Eljah/qulay/electronics/README.md

# Электронная сборка QL-01

## Архитектура

Raspberry Pi 4 / Linux SBC выполняет Java-агент, хранение, связь и работу с флеш-памятью. Pico RP2040 подключён к нему по USB CDC и опрашивает измерительные датчики. Специальное мобильное приложение не требуется: телефон может предоставить Wi-Fi hotspot; опционально используется готовый сертифицированный USB LTE-модем. Разработка собственного GSM-тракта не входит в QL-01.

Редактируемые проекты KiCad создаются `build_checked.py`: плата углового датчика `encoder` 18×24 мм, плата сопряжения Pico `carrier` 80×100 мм. Схемы и платы создаются из одной таблицы выводов, поэтому в `connections.csv` есть явная проверяемая карта каждого контакта. `harness.csv` задаёт все 31 канала, цепочки 8+8+8+7. Изображение платы без электрических сетей не выдаётся за разработанную схему.

## Основные узлы и количества

| Узел | Количество | Примечание |
|---|---:|---|
| Raspberry Pi 4 / Linux SBC | 1 | Java 21, USB, Wi-Fi; отдельное питание |
| Raspberry Pi Pico RP2040 | 1 | Нативный USB; две SPI-шины |
| AS5048A, TSSOP14 | 31 | По одному на каждый шарнир |
| encoder PCB | 31 | AS5048A, 100 нФ, 10 мкФ, разъём |
| carrier PCB | 1 | Разъёмы Pico, датчиков, питания, одометра |
| Диаметрально намагниченный магнит | 31 | Геометрия и материал согласуются по испытанию |
| ADXL355, модуль с доступным SPI 3.3 В | 1 | Жгут согласно нашей распиновке; не обещается прямое совпадение с любым модулем |
| Квадратурный энкодер 3.3 В | 1 | Реальное колесо и масштаб калибруются; 12/24 В входы не поддержаны |
| Внешний стабилизатор датчиков 3.3 В | 1 | Ток не менее 1 А как проектный запас, с ограничением тока |
| Питание SBC 5 В | 1 | Проектный бюджет до 4 А с запасом и отдельной проверкой пиков USB |
| Готовая батарея с BMS/защитой | 1 | Не проект самостоятельной сборки литиевых ячеек |

31 AS5048A при типовом потреблении порядка 15 мА требуют около 465 мА, без запаса. Не подключать их все к 3V3 Pico. Carrier принимает отдельные 3.3 В через PTC; номинал PTC и температурное снижение допустимого тока должны быть проверены. Pico питается от USB, общая земля соединена. Отключённое питание датчиков при активных SPI-линиях может вызывать паразитное питание через входы: порядок включения, буфер/изоляция и защита линий подлежат проверке перед полевым прибором.

Оценочный рабочий бюджет всей электроники 12–20 Вт, не измеренный. Для батареи 60 Вт·ч и суммарного использования 80% это примерно 2.4–4 часа; холод и LTE могут ухудшить результат. Номинал батареи выбирается после замера фактического потребления и пиков.

## Монтаж и первичное включение

Сначала USB-Pico без датчиков: загрузить UF2, проверить CDC и период строк. Затем один AS5048A от ограниченного источника 3.3 В; проверить распиновку, паритет, OCF и диагностику магнита при полном диапазоне поворота. Затем три соседних канала и влияние магнитов. Только после этого — все цепочки и нагрузочное питание. Физическое движение одного рычага должно менять именно его индекс в журнале, иначе порядок SPI-цепочки не подтверждён.

AS5048A SPI mode 1, ADXL355 SPI mode 0: они намеренно на разных контроллерах. Жгуты сигнала и земли прокладывать совместно, питание вести с достаточным сечением; окончательные длины, фронты, резисторы согласования, ESD и EMC подтверждаются на приборе. Наружный USB и разъёмы должны иметь механическую разгрузку и защиту от воды. Защита IP в QL-01 не заявляется.

## Что проверяет автоматическая сборка

KiCad 9, проверка сериализованных координат каждой площадки, экспорт DSN, реальная трассировка Freerouting, обратный импорт SES, DRC, ERC, экспорт схем в PDF и платы в SVG. Все сообщения сохраняются; они не скрываются исключениями. Наличие файлов Gerber, если они экспортированы, не является разрешением на производство: `manufacturing_release=false` остаётся до независимой проверки питания, контактов, схемы, EMC и магнитной калибровки.

Скрипт `build.py` — генератор логической модели; запускать именно `build_checked.py`, который нормализует координаты площадок через API KiCad 9 и повторно читает сохранённую плату. Это исправляет выявленную несовместимость KiCad 7. Системный Python должен содержать pcbnew. Пересборка: `python3 electronics/build_checked.py`, трассировка DSN в SES, `python3 electronics/verify.py`.

## Нереализованные аппаратные функции

Нет валидированного датчика контакта/усилия каждого ролика. Нет интерфейса внешнего геодезического Z, температурной компенсации, защищённого полевого питания и сертифицированного корпуса. Q1 сохраняет реальные углы/ускорение/пробег, но не имеет права утверждать, что все ролики касались покрытия. Эти ограничения отражены в данных, а не спрятаны в документации.

Первичные источники: [AS5048A](https://www.infineon.com/assets/row/public/documents/24/49/infineon-as5048a-as5048b-datasheet-en.pdf), [ADXL355](https://www.analog.com/media/en/technical-documentation/data-sheets/adxl354_adxl355.pdf), [Pico SDK](https://www.raspberrypi.com/documentation/pico-sdk/hardware.html), [KiCad Ubuntu](https://www.kicad.org/download/details/ubuntu/). Отчёты в `generated/` относятся к точной сохранённой ревизии плат.
