Eljah/qulay/electronics/generated/harness.csv

channel | bank | sensor_pin | signal | connect_to
0 | 0 | 1 | 3V3 | carrier.J2.1
0 | 0 | 2 | GND | carrier.J2.2
0 | 0 | 3 | CS | carrier.J2.3
0 | 0 | 4 | SCK | carrier.J2.4
0 | 0 | 5 | DIN | carrier.J2.5
0 | 0 | 6 | DOUT | encoder01.J1.5
1 | 0 | 1 | 3V3 | carrier.J2.1
1 | 0 | 2 | GND | carrier.J2.2
1 | 0 | 3 | CS | carrier.J2.3
1 | 0 | 4 | SCK | carrier.J2.4
1 | 0 | 5 | DIN | encoder00.J1.6
1 | 0 | 6 | DOUT | encoder02.J1.5
2 | 0 | 1 | 3V3 | carrier.J2.1
2 | 0 | 2 | GND | carrier.J2.2
2 | 0 | 3 | CS | carrier.J2.3
2 | 0 | 4 | SCK | carrier.J2.4
2 | 0 | 5 | DIN | encoder01.J1.6
2 | 0 | 6 | DOUT | encoder03.J1.5
3 | 0 | 1 | 3V3 | carrier.J2.1
3 | 0 | 2 | GND | carrier.J2.2
3 | 0 | 3 | CS | carrier.J2.3
3 | 0 | 4 | SCK | carrier.J2.4
3 | 0 | 5 | DIN | encoder02.J1.6
3 | 0 | 6 | DOUT | encoder04.J1.5
4 | 0 | 1 | 3V3 | carrier.J2.1
4 | 0 | 2 | GND | carrier.J2.2
4 | 0 | 3 | CS | carrier.J2.3
4 | 0 | 4 | SCK | carrier.J2.4
4 | 0 | 5 | DIN | encoder03.J1.6
4 | 0 | 6 | DOUT | encoder05.J1.5
5 | 0 | 1 | 3V3 | carrier.J2.1
5 | 0 | 2 | GND | carrier.J2.2
5 | 0 | 3 | CS | carrier.J2.3
5 | 0 | 4 | SCK | carrier.J2.4
5 | 0 | 5 | DIN | encoder04.J1.6
5 | 0 | 6 | DOUT | encoder06.J1.5
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
