Eljah/qulay/docs/METROLOGY.md

# QL-01: наблюдаемость, неопределённость и проект методики

Статус: проект инженерного исследования, не утверждённая методика измерений и не действующий ГОСТ.

## 1. Определяемые величины

Высотный профиль поверхности в заданной системе координат; продольный и поперечный уклоны на явно заданной базе; обнаруженные перепады уровней; зоны потери контакта; пространственная полнота обследования. Геометрия не доказывает сцепление, прочность, водоотвод, безопасное пересечение проезжей части или удобство для всех типов кресел.

Отчёт должен различать: измерено, вычислено, интерполировано, ненаблюдаемо. Интерполяция через вертикальную грань или неизвестный контакт запрещена. Отсутствие измеренной ступеньки не доказывает её отсутствие.

## 2. Геометрическая проблема, которую не исправит программный фильтр

Измерительный угол задаёт положение центра ролика относительно рамы. На двух поверхностях разной высоты рама может подняться вместе с роликами, сохраняя углы и наклон; поэтому без независимого Z продольная поверхность не определяется однозначно. Интегрирование ускорений или GNSS не принято здесь за миллиметровую базу.

DATUM_RAIL требует измерить форму и прогиб направляющих под нагрузкой, биение и деформацию опорных колёс, точное положение кассеты. EXTERNAL_POSE требует временной привязки и прослеживаемости внешней системы. FREE_ROLL допускает разведку и одновременные относительные поперечные величины с оговорками.

### Вдоль бордюра: ещё одна существенная поправка

При L=240 мм, оси на высоте 220 мм и ролике R20 на нижнем уровне центр находится примерно в X=132.7 мм от шарнира. На верхнем уровне +150 мм — примерно X=234.7 мм. Значит, две сравниваемые точки расположены не только на разных Y, но и примерно на 102 мм в разных X. На ровных вдоль бордюра площадках это допустимая модель, но при продольном изменении высот возникает смещение результата. Нельзя называть каждую строку массива строгим поперечным сечением без пересчёта координат.

`CurbAnalysis` сравнивает медианы наружных окон каналов 0..9 и 21..30 при разбросе высоты в каждом окне не более 4 мм. Этот допуск — демонстрационное условие алгоритма, не норматив. Сохраняется разность X контактов; центральная грань остаётся ненаблюдаемой. Серверный `/curb-profile` показывает профиль разности уровней и ограничения, не положительное заключение о соответствии. Для наклонных/волнистых площадок нужны сопоставление по мировой X с datum либо отдельная оценка возможной ошибки от продольного градиента.

## 3. Предварительная оценка чувствительности, не паспортная точность

На горизонтальной раме `dz/dα = L cos α`. Один отсчёт 14-битного датчика равен 2π/16384 ≈ 0.0003835 рад. При α=-56.44° и L=240 мм это около 0.051 мм на отсчёт; при α≈0 — около 0.092 мм. Это дискретность, НЕ погрешность. Нелинейность датчика, магнит, люфт и упругость могут давать значительно больший вклад.

При остаточной ошибке угла 0.05° и чувствительности 133 мм/рад вклад по высоте около 0.116 мм. Но значение 0.05° не достигнуто и не подтверждено: это лишь пример для выбора требований к калибровочному стенду.

Остаточная ошибка крена 0.05° даёт примерно 0.655 мм разности на ширине 750 мм. Неправильно установленный инклинометр способен имитировать нарушение поперечного уклона. Ускорение движения также влияет на акселерометрический наклон.

Пример бюджета стандартной неопределённости одной координаты (только гипотетические входные данные): угол 0.12 мм; длина/ось 0.15; радиус/биение 0.15; люфт/пружина 0.20; ориентация 0.20; datum 0.30; временная несогласованность 0.15. При независимости сумма квадратов даёт u≈0.50 мм, U(k=2)≈1.0 мм. Эти величины НЕ заявляются для устройства. Корреляции, температурные эффекты и модель контакта могут изменить результат.

Для уклона `(z2-z1)/B` важна ковариация двух высот; нельзя механически складывать две полные независимые ошибки, если общая ошибка datum сокращается, или наоборот игнорировать изгиб направляющей. Базу B, фильтрацию и правило обнаружения перегиба фиксируют в версии методики.

## 4. Программа трёхканального стенда

Сначала изготовить и испытать 3 соседних канала с реальными магнитами и датчиками, а не сразу заказывать 31. Измерить нелинейность вверх/вниз, гистерезис, люфт, повторяемость, чувствительность к температуре и соседнему магниту. Проверить реальный радиус контакта и биение ролика, стабильность усилия пружины по всему диапазону.

Требуется отдельный датчик контакта/силы. По одному углу нельзя надёжно отличить касание от зависания рычага: Q1 помечает все реальные каналы CONTACT_UNKNOWN. До разработки, калибровки и испытания этого канала автоматическое принятие реальных измерений блокируется. Возможная следующая конструкция — упругий измерительный элемент между вилкой ролика и рычагом с тензодатчиком; это отдельная аппаратная ревизия, не существующая часть платы QL-01.

После успешного стенда: полная кассета; измерение её изгиба; платформа с поверенными мерами высоты 5/10/15/20/150 мм; наклонная плоскость; два прохода в противоположных направлениях; проход со смещением половины шага; испытания грязью, водой и боковым упором. Положительный результат симулятора не заменяет ни одного из этих испытаний.

## 5. Проект полевой процедуры

Зафиксировать объект, план, погоду/температуру, оператора, версии прошивки и ПО, серийные номера, калибровку и профиль требований. Снять общий вид, границы доступного коридора и состояние покрытия. Проверить ноль и меру высоты до прохода.

Выбрать и проверить высотную базу; разместить направляющие вне исследуемого покрытия и безопасно оградить место. Выполнить перекрывающиеся проходы всей ширины объекта; записать направления, геометрическую привязку и смещения. При упоре в бордюр остановиться, поднять кассету, выполнить отдельный проход вдоль бордюра или сверху. Не продавливать ролики через препятствие.

После прохода повторить контроль нуля/меры, отметить отрывы и повреждения. Сохранить исходные данные и хеш; подписывать протокол отдельным механизмом идентификации оператора, поскольку SHA-256 сам по себе не является электронной подписью.

## 6. Правило решения

Для верхнего предела T при измеренном m и расширенной неопределённости U: соответствие, только если m+U≤T; несоответствие, если m−U>T; иначе пограничный/неопределённый результат. Неполнота покрытия, отсутствие datum, неизвестный контакт, неподтверждённая калибровка или неприменимый норматив дают самостоятельную причину невозможности заключения.

## 7. Путь к стандарту

Сначала определить область применения и измеряемые величины; затем ТУ на средство, методику калибровки/поверки, методику измерений, межоператорную и межлабораторную воспроизводимость, правила решения и формат протокола. Обсудить применимость 102-ФЗ и статус средства измерений с компетентной метрологической организацией. Только после экспериментальной базы готовить предложение по стандартизации с профильным техническим комитетом.

СП 59.13330.2020 и дорожные документы не объединяются в один универсальный порог. Для каждой проверки нужны применимая официальная редакция, пункт и условия объекта. В QL-01 такой юридико-технический реестр ещё не подтверждён; `DEMO-ONLY-01` намеренно не нормативный.

Источники принципов и спецификаций: ссылки в [CONCEPT.md](CONCEPT.md), [firmware/README.md](../firmware/README.md). Численные примеры выше — расчёты проектировщика, а не результаты испытаний.
