Eljah/qulay/mechanical/generated-r1/QL01-R1-review.pdf

# QULAY / Обновлённая компоновка

Ревизия B / 31 канал с шагом 25 мм. Исходная ревизия сохранена в mechanical/generated.

QL-01.R1 · Компоновочный CAD. НЕ разрешение на изготовление и НЕ подтверждение точности.
Номинальные размеры, мм. Пружины, замки высоты, уплотнения и соединение рычага с валом требуют деталировки.

# QULAY / Два соседних шарнира — крупно

Перенесены подшипники и платы. Магнит установлен на торце, а не внутри объёма вала.

# QULAY / Шарнир: осевой разрез

Разрез CAD по Z оси. Зелёный — плата; чёрный — корпус датчика; красный — магнит; жёлтый — габарит пружины.

# QULAY / Режим вдоль бордюра

Два уровня 0/150 мм. Необходимо отдельно ограничивать ошибку от смещения контактов по X.

# QULAY / Режим на независимых направляющих

Только компоновка: прямолинейность и прогиб направляющих под нагрузкой ещё не измерены.
