Eljah/qulay/mechanical/generated/QL01-CAD-album.pdf

# QULAY / Общий вид QL-01

31 канал; шаг 25 мм; база крайних осей 750 мм; рычаг 240 мм.

QL-01 • Компоновочный CAD. НЕ рабочая документация для изготовления. Размеры — мм.

Изображения отрендерены из тех же B-rep тел, которые экспортированы в STEP. Упрощения указаны в реестре деталей. | 1/7

# QULAY / Вид сверху

Габарит рамы 840 × 800 мм. Колея опор 825 мм; наружный габарит колёс 860 мм.

Изображения отрендерены из тех же B-rep тел, которые экспортированы в STEP. Упрощения указаны в реестре деталей. | 2/7

# QULAY / Боковая проекция X–Z

Высота оси измерительного рычага 220 мм; опорные колёса Ø200; ролики Ø40.

Изображения отрендерены из тех же B-rep тел, которые экспортированы в STEP. Упрощения указаны в реестре деталей. | 3/7

# QULAY / Фронтальная проекция Y–Z

Полоса измерения не равна полной ширине съезда. Требуются привязанные перекрывающиеся проходы.

Изображения отрендерены из тех же B-rep тел, которые экспортированы в STEP. Упрощения указаны в реестре деталей. | 4/7

# QULAY / Проход вдоль бордюра

Слева/справа разные уровни 0/150 мм; рама поднята, кассета опущена на 150 мм.

Изображения отрендерены из тех же B-rep тел, которые экспортированы в STEP. Упрощения указаны в реестре деталей. | 5/7

# QULAY / Независимая высотная база: направляющие

Направляющие 3000 × 60 × 80 × 4 мм, 5 опор на каждую. Поверенная геометрия ещё не подтверждена.

Изображения отрендерены из тех же B-rep тел, которые экспортированы в STEP. Упрощения указаны в реестре деталей. | 6/7

# Измерительная кассета — исходные размеры и ограничения

Рычаг: расстояние осей 240 мм; ширина 20 мм; сталь 3 мм; отверстия Ø8.1 мм.

Ролик: сферическая корона R20, ширина 12 мм, отверстие Ø16 мм под два подшипника 688.

31 независимый канал с шагом 25 мм; шарниры, магниты, платы и пружины показаны отдельными телами.

Приведён DXF 1:1 контура рычага и STEP заготовки; перед заказом согласовать посадки и технологию.

Пружина и крепёжные кронштейны показаны габаритно. Рабочие чертежи пружин, стопоров,

грязезащиты и замков высоты требуют проверки на трёхканальном стенде.

Не утверждается отсутствие взаимных пересечений всех сборочных деталей: выполнена проверка валидности

отдельных B-rep тел. Полная проверка зазоров, нагрузок и прогибов должна предшествовать производству.

Калибровка включает: угловую LUT каждого канала, положение магнита, длину рычага, радиус и биение

ролика, ориентацию инклинометра, масштаб одометра и высотную базу под нагрузкой.

Целевая погрешность не является достигнутой характеристикой. Реальные датчики ещё не испытаны.

Реестры резки и деталей выгружены в CSV отдельно для каждого положения сборки.
