Eljah/qulay/mechanical/coupling_c1/generated/C1-drawings.pdf

# QULAY / C1-00 Сборка и осевая размерная цепь

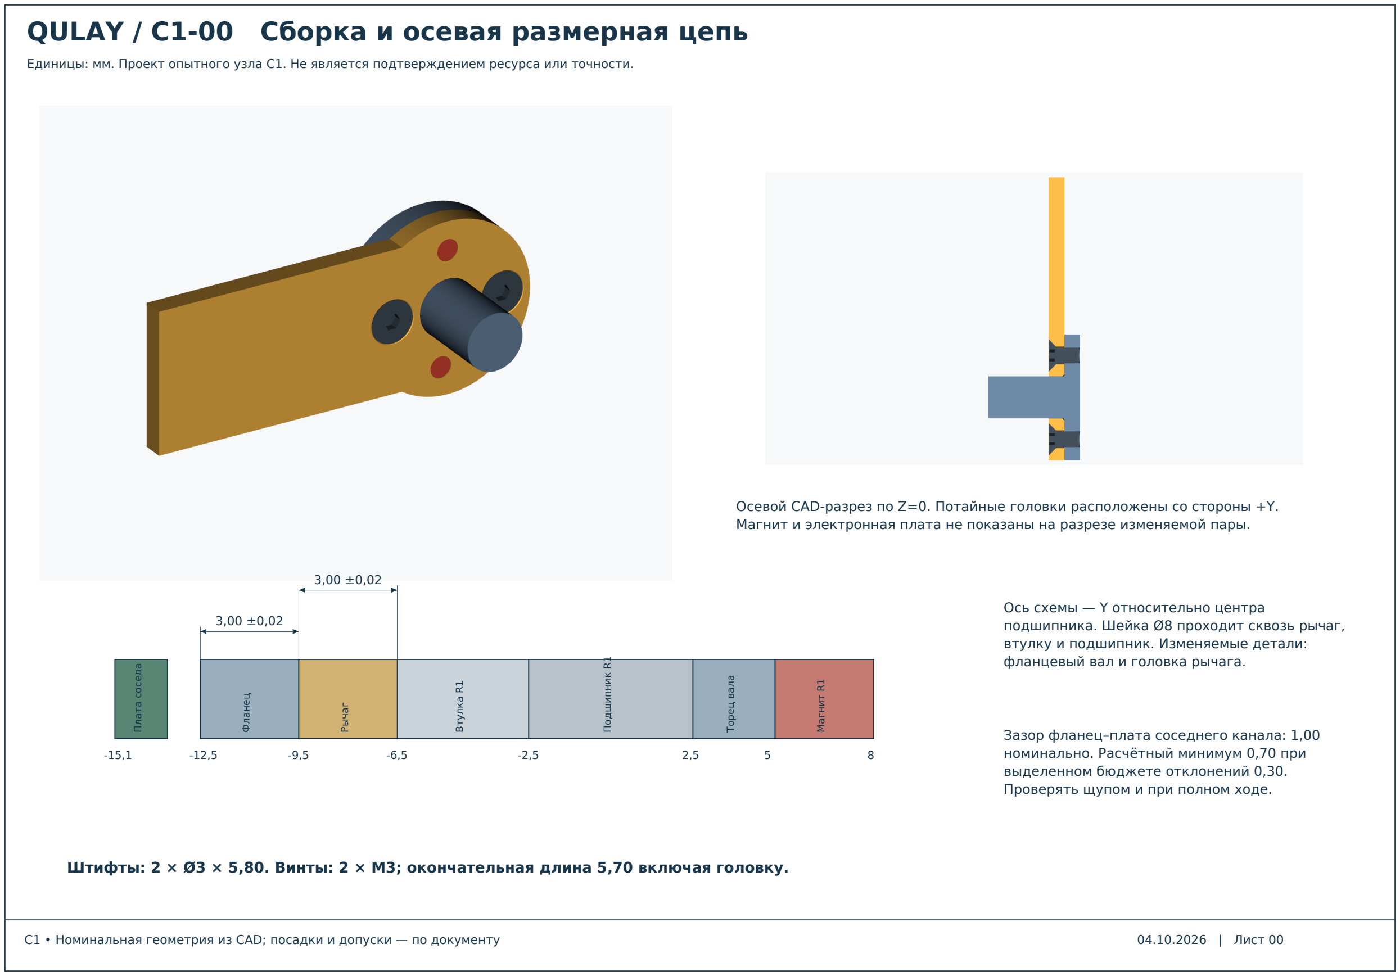
[picture p3: page 1]

Единицы: мм. Проект опытного узла C1. Не является подтверждением ресурса или точности.

C1 • Номинальная геометрия из CAD; посадки и допуски — по документу | 04.10.2026 | Лист 00

Осевой CAD-разрез по Z=0. Потайные головки расположены со стороны +Y. Магнит и электронная плата не показаны на разрезе изменяемой пары.

Плата соседа

-15,1

Фланец

-12,5

Рычаг

-9,5

Втулка R1

-6,5

Подшипник R1

-2,5

Торец вала

2,5

Магнит R1

5 | 8

3,00 ±0,02

3,00 ±0,02

Ось схемы — Y относительно центра подшипника. Шейка Ø8 проходит сквозь рычаг, втулку и подшипник. Изменяемые детали: фланцевый вал и головка рычага.

Зазор фланец–плата соседнего канала: 1,00 номинально. Расчётный минимум 0,70 при выделенном бюджете отклонений 0,30. Проверять щупом и при полном ходе.

Штифты: 2 × Ø3 × 5,80. Винты: 2 × M3; окончательная длина 5,70 включая головку.

# QULAY / C1-01 Цельный фланцевый вал

Единицы: мм. Проект опытного узла C1. Не является подтверждением ресурса или точности.

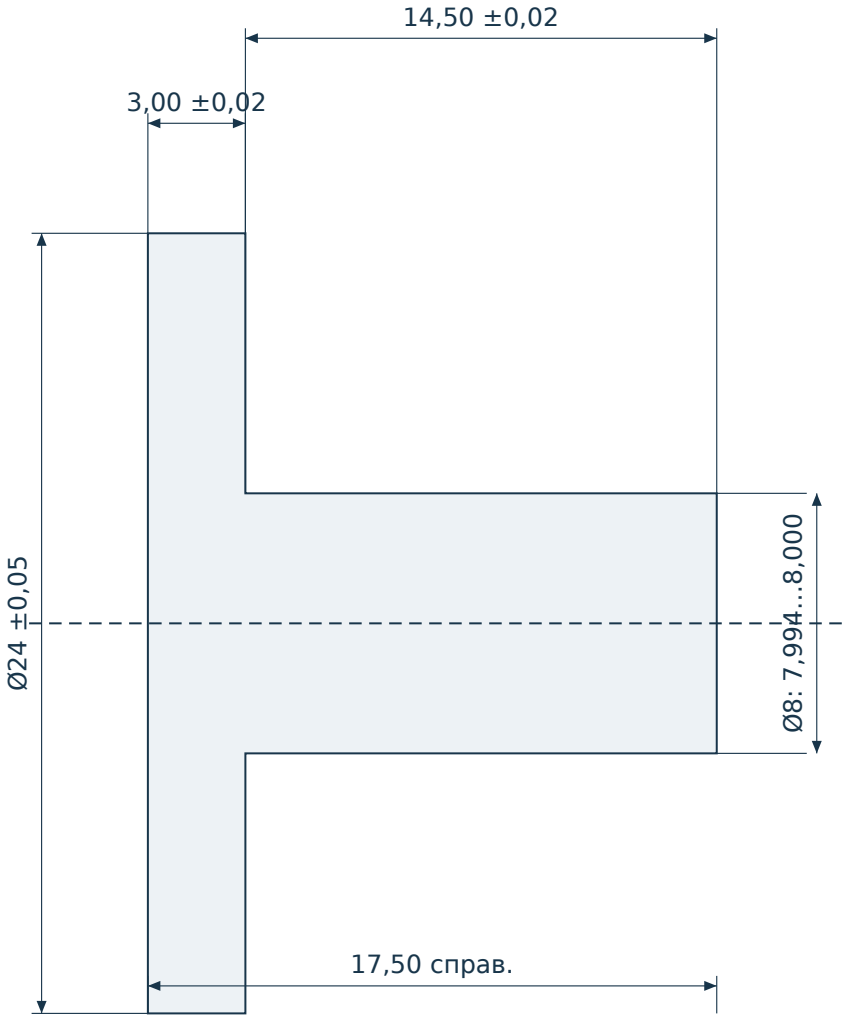
[picture p4: figure]
17,50 справ.
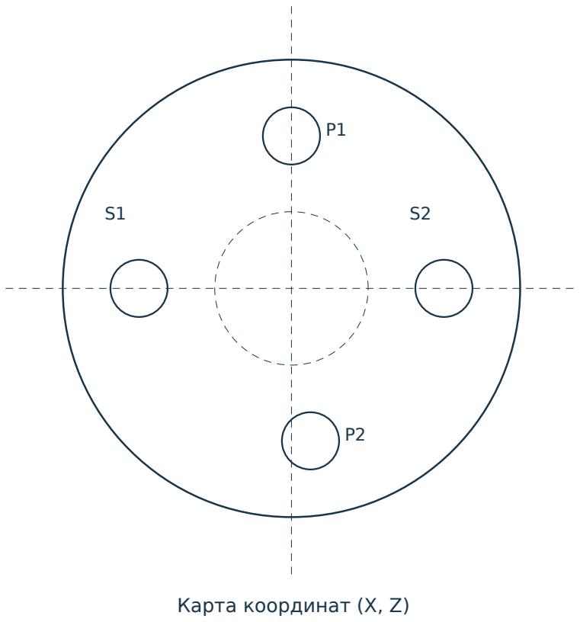
[picture p5: figure]
Карта координат (X, Z)

C1 • Номинальная геометрия из CAD; посадки и допуски — по документу | 04.10.2026 | Лист 01

Продольный профиль Y–Z; галтель R0,20 у фланца.

Отверстие | X | Z | Обработка
P1 | 0 | +8 | Совместно под свой штифт
P2 | +1 | −8 | Совместно под свой штифт
S1 | −8 | 0 | M3×0,5-6H сквозное
S2 | +8 | 0 | M3×0,5-6H сквозное

Материал: C45 / сталь 45; сертификат Rp0,2 ≥300 МПа.

Вал и фланец — одна заготовка. Не приваривать шайбу.

Шейка: Ra ≤0,8 мкм. Торец фланца: плоскостность 0,02;

его биение относительно шейки ≤0,02. Задиры не допускаются.

# QULAY / C1-02 Рычаг и обработка головки

Единицы: мм. Проект опытного узла C1. Не является подтверждением ресурса или точности.

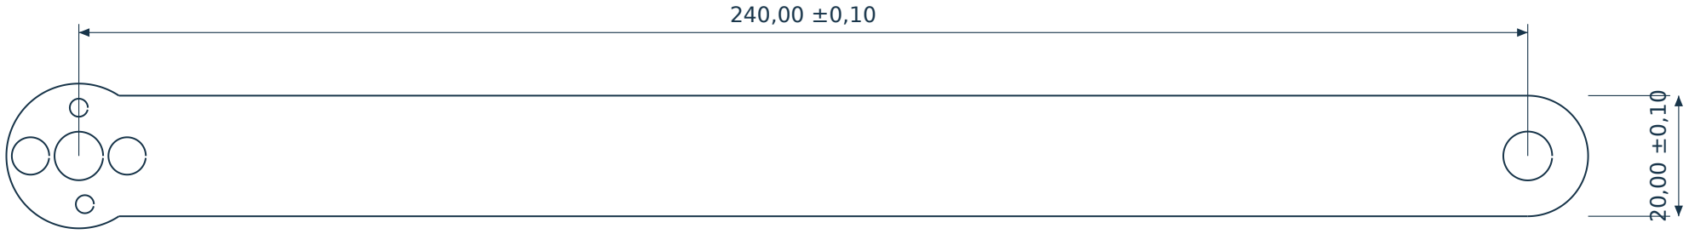
[picture p6: figure]
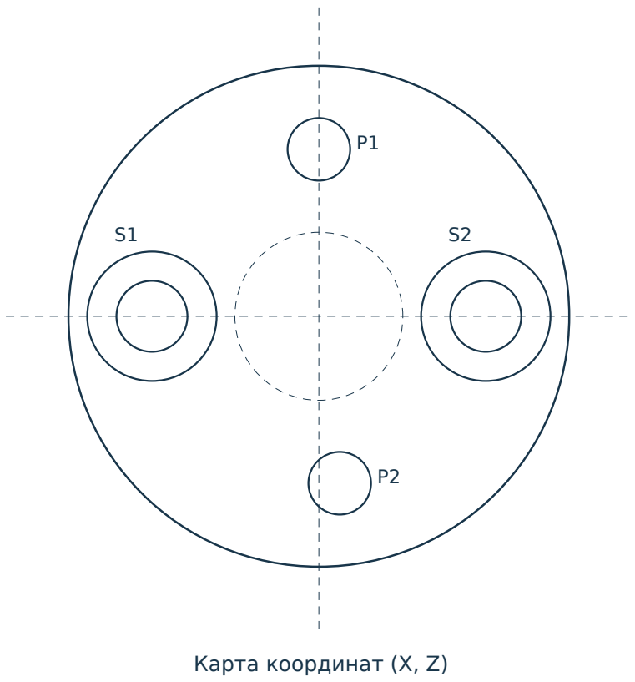
[picture p7: figure]
Карта координат (X, Z)

C1 • Номинальная геометрия из CAD; посадки и допуски — по документу | 04.10.2026 | Лист 02

Общий вид 1:1: линии получены с плоской грани CAD. Головка R12; роликовое отверстие Ø8,10.

Головка рычага: толщина 3,00 ±0,02; сталь Rp0,2 ≥300 МПа.

Центральное отверстие Ø8,05 ±0,01. Со стороны фланца

фаска 0,4×45° для галтели. Плоскостность торца ≤0,02.

S1 / S2: Ø3,4 сквозные; зенковка Ø6,2 +0,05/0, угол 90°.

Головка винта ≤Ø6,0; утапливание 0…0,10. Подрезанный

винт длиной 5,70 ±0,05 включая головку; не выступать сзади.

P1 / P2: координаты как на листе C1-01. Финиш отверстий

только совместно в стянутой паре. Dотв = Dштифта − 0,002…0,004.

Натяг измерять; обозначение H7/m6 не является заменой.

Серийный номер пары нанести до запрессовки. Не смешивать пары.

Рабочее цилиндрическое зацепление штифта ≥2,4 в каждой детали.

DXF — геометрия готовой грани, не программа лазера: отверстия

с натягом, фаски и зенковки требуют механической обработки.

Контроль печати: 100 мм. Печатать A3, 100%, без вписывания.
