Eljah/qulay/docs/channel/assets/pivot.png

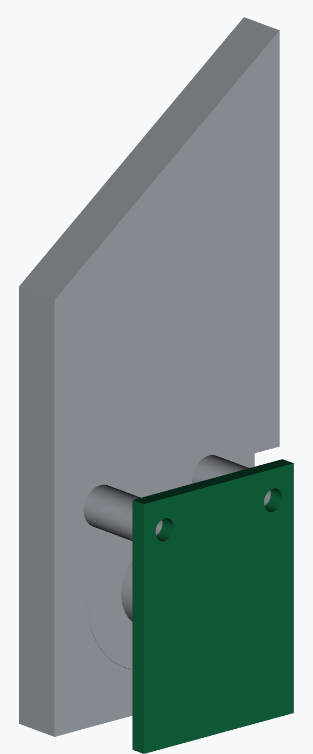
docs/channel/assets/pivot.png
