Eljah/qulay/mechanical/coupling_c1/generated/joint.png

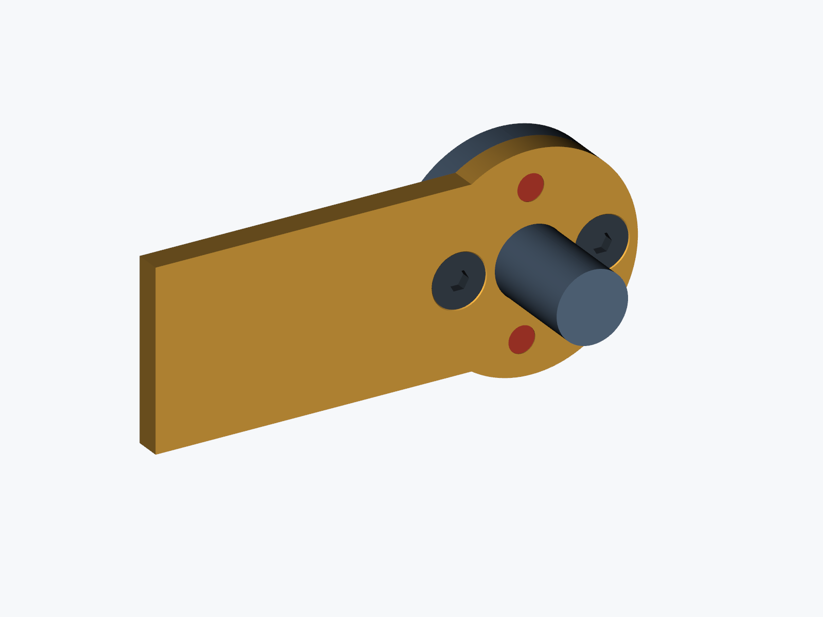
mechanical/coupling_c1/generated/joint.png
