Eljah/qulay/mechanical/coupling_c1/generated/section.png

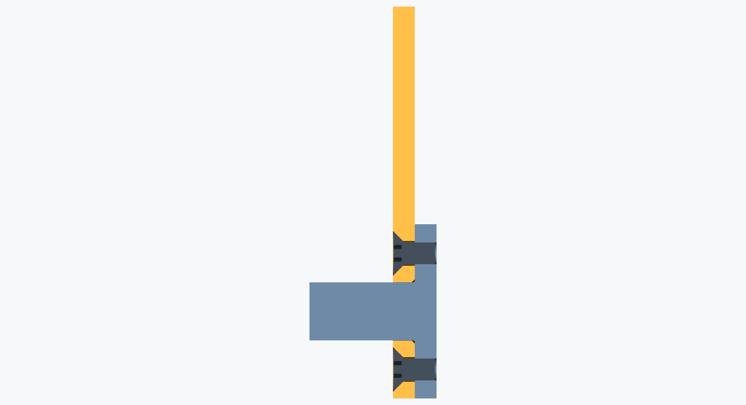
mechanical/coupling_c1/generated/section.png
