Eljah/qulay/mechanical/coupling_c1/generated/trolley.png

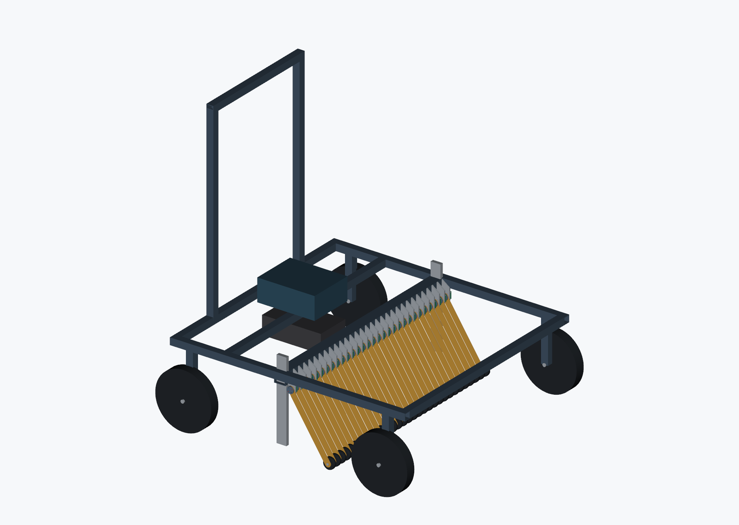
mechanical/coupling_c1/generated/trolley.png
