Eljah/qulay/mechanical/generated-r1/along-curb-iso.png

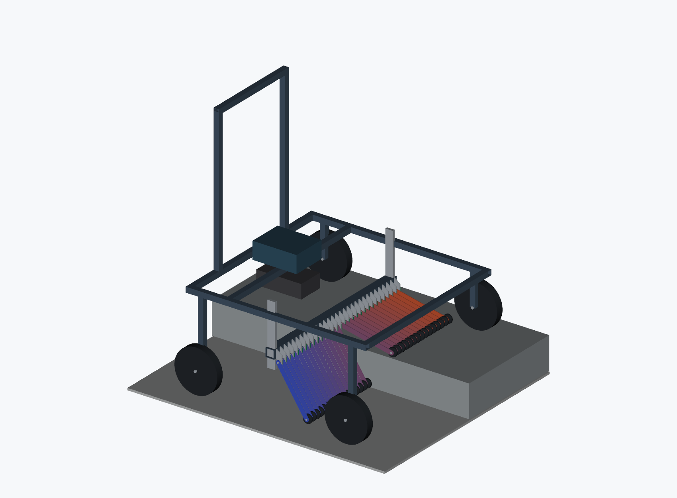
mechanical/generated-r1/along-curb-iso.png
