Eljah/qulay/mechanical/generated-r1/datum-rail-iso.png

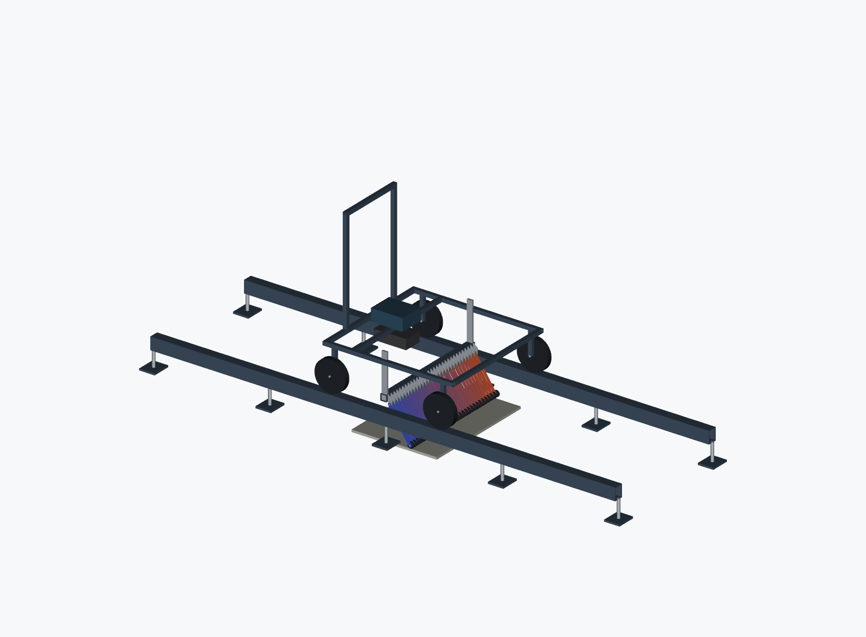
mechanical/generated-r1/datum-rail-iso.png
