Eljah/qulay/mechanical/generated-r1/pivot-detail.png

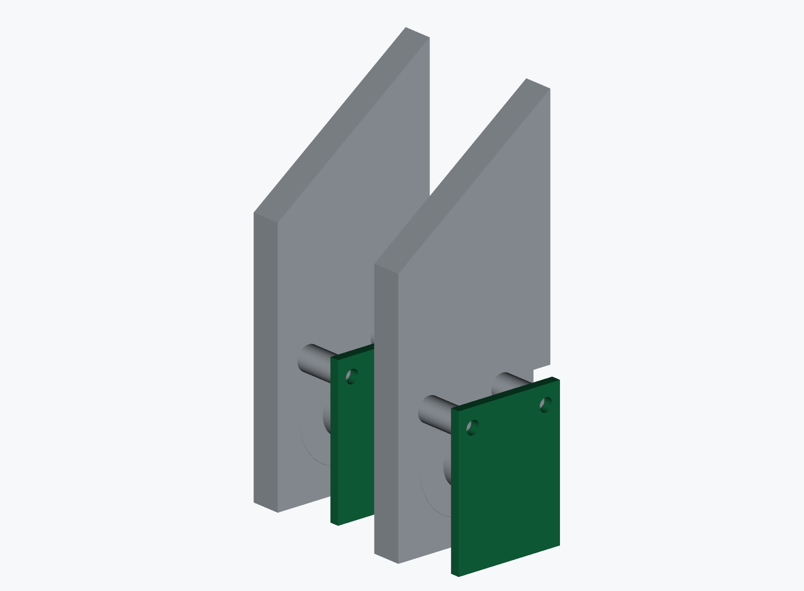
mechanical/generated-r1/pivot-detail.png
