Eljah/qulay/mechanical/generated-r1/pivot-section.png

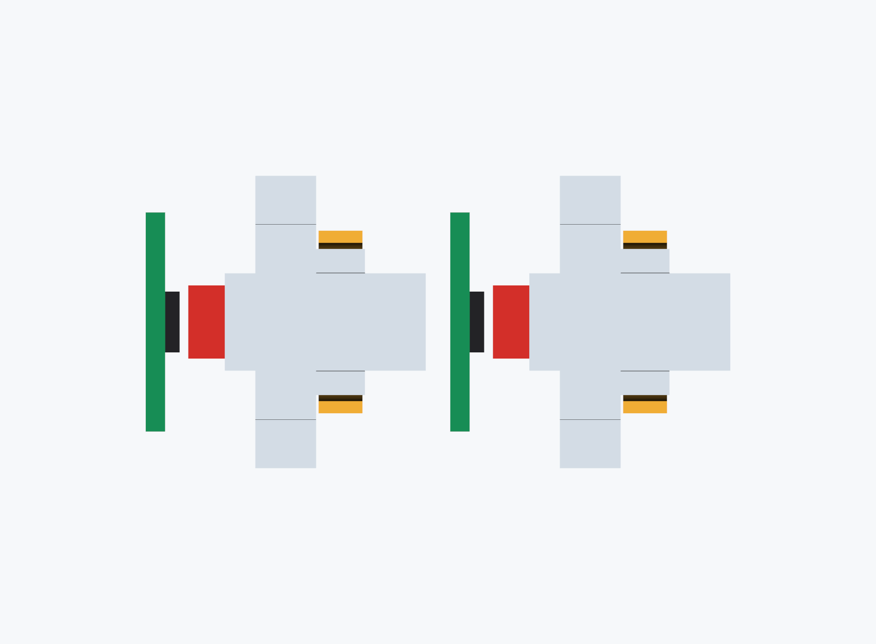
mechanical/generated-r1/pivot-section.png
