Eljah/qulay/mechanical/generated/crossing-front.png

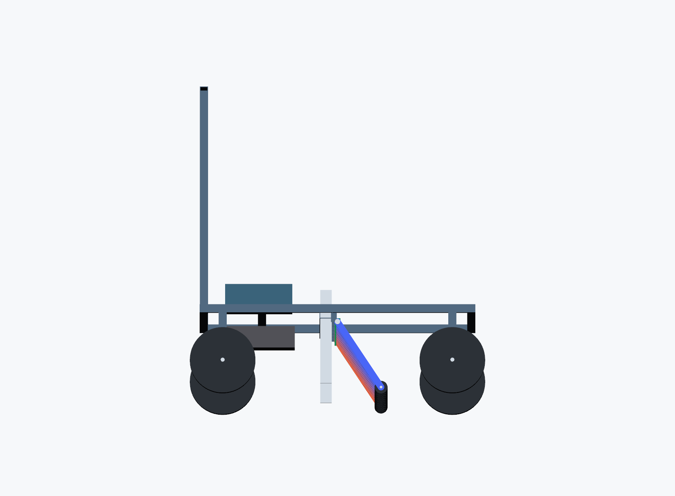
mechanical/generated/crossing-front.png
