Eljah/qulay/mechanical/generated/crossing-side.png

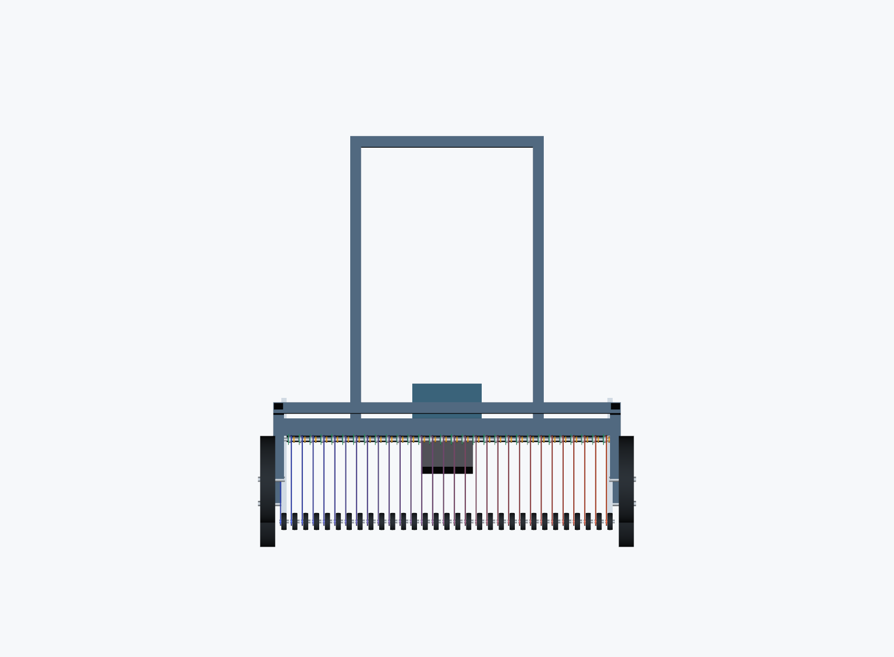
mechanical/generated/crossing-side.png
