Eljah/qulay/mechanical/generated/crossing-top.png

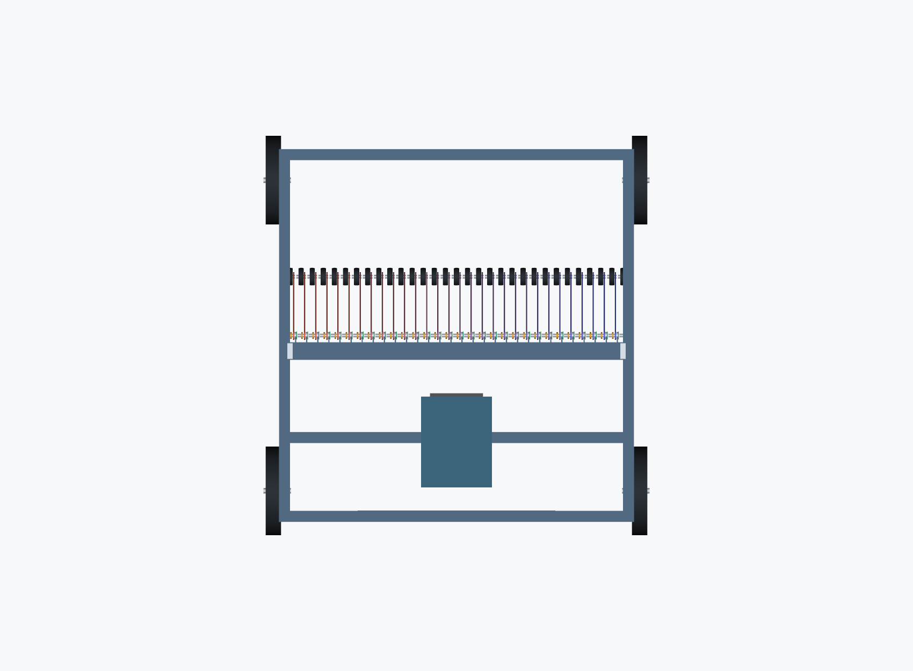
mechanical/generated/crossing-top.png
