Eljah/qulay/mechanical/generated-r1/parts-along-curb.csv

id | material | volume_mm3 | note
F01-L | steel | 154560.0
F01-R | steel | 154560.0
F02-rear | steel | 138000.0
F02-front | steel | 138000.0
F03-rear-cross | steel | 138000.0
W-leg-rear-L | steel | 57040.0
W-axle-rear-L | steel | 7012.035 | axle envelope; retainers not detailed
W-wheel-rear-L | purchased wheel | 1095599.022 | rigid calibrated substitute needed on datum rails
W-leg-rear-R | steel | 29440.0
W-axle-rear-R | steel | 7012.035 | axle envelope; retainers not detailed
W-wheel-rear-R | purchased wheel | 1095599.022 | rigid calibrated substitute needed on datum rails
W-leg-front-L | steel | 57040.0
W-axle-front-L | steel | 7012.035 | axle envelope; retainers not detailed
W-wheel-front-L | purchased wheel | 1095599.022 | rigid calibrated substitute needed on datum rails
W-leg-front-R | steel | 29440.0
W-axle-front-R | steel | 7012.035 | axle envelope; retainers not detailed
W-wheel-front-R | purchased wheel | 1095599.022 | rigid calibrated substitute needed on datum rails
C-slide-L | steel | 119700.0 | cassette slide/clamp envelope, travel 220 mm
C-slide-R | steel | 119700.0 | cassette slide/clamp envelope, travel 220 mm
C01-pivot-beam | steel | 237120.0
A-01 | steel laser plate | 15033.298 | 240 mm centre distance; 3 mm; 8.1 mm holes
R-01 | POM/urethane crown | 12214.515 | spherical crown R20, width12; material/hysteresis to validate
RB-01a | 688 bearing | 753.982
RB-01b | 688 bearing | 753.982
RA-01 | steel axle | 1105.841
A-02 | steel laser plate | 15033.298 | 240 mm centre distance; 3 mm; 8.1 mm holes
R-02 | POM/urethane crown | 12214.515 | spherical crown R20, width12; material/hysteresis to validate
RB-02a | 688 bearing | 753.982
RB-02b | 688 bearing | 753.982
RA-02 | steel axle | 1105.841
A-03 | steel laser plate | 15033.298 | 240 mm centre distance; 3 mm; 8.1 mm holes
R-03 | POM/urethane crown | 12214.515 | spherical crown R20, width12; material/hysteresis to validate
RB-03a | 688 bearing | 753.982
RB-03b | 688 bearing | 753.982
RA-03 | steel axle | 1105.841
A-04 | steel laser plate | 15033.298 | 240 mm centre distance; 3 mm; 8.1 mm holes
R-04 | POM/urethane crown | 12214.515 | spherical crown R20, width12; material/hysteresis to validate
RB-04a | 688 bearing | 753.982
RB-04b | 688 bearing | 753.982
RA-04 | steel axle | 1105.841
A-05 | steel laser plate | 15033.298 | 240 mm centre distance; 3 mm; 8.1 mm holes
R-05 | POM/urethane crown | 12214.515 | spherical crown R20, width12; material/hysteresis to validate
RB-05a | 688 bearing | 753.982
RB-05b | 688 bearing | 753.982
RA-05 | steel axle | 1105.841
A-06 | steel laser plate | 15033.298 | 240 mm centre distance; 3 mm; 8.1 mm holes
R-06 | POM/urethane crown | 12214.515 | spherical crown R20, width12; material/hysteresis to validate
RB-06a | 688 bearing | 753.982
RB-06b | 688 bearing | 753.982
RA-06 | steel axle | 1105.841
A-07 | steel laser plate | 15033.298 | 240 mm centre distance; 3 mm; 8.1 mm holes
R-07 | POM/urethane crown | 12214.515 | spherical crown R20, width12; material/hysteresis to validate
RB-07a | 688 bearing | 753.982
RB-07b | 688 bearing | 753.982
RA-07 | steel axle | 1105.841
A-08 | steel laser plate | 15033.298 | 240 mm centre distance; 3 mm; 8.1 mm holes
R-08 | POM/urethane crown | 12214.515 | spherical crown R20, width12; material/hysteresis to validate
RB-08a | 688 bearing | 753.982
RB-08b | 688 bearing | 753.982
RA-08 | steel axle | 1105.841
A-09 | steel laser plate | 15033.298 | 240 mm centre distance; 3 mm; 8.1 mm holes
R-09 | POM/urethane crown | 12214.515 | spherical crown R20, width12; material/hysteresis to validate
RB-09a | 688 bearing | 753.982
RB-09b | 688 bearing | 753.982
RA-09 | steel axle | 1105.841
A-10 | steel laser plate | 15033.298 | 240 mm centre distance; 3 mm; 8.1 mm holes
R-10 | POM/urethane crown | 12214.515 | spherical crown R20, width12; material/hysteresis to validate
RB-10a | 688 bearing | 753.982
RB-10b | 688 bearing | 753.982
RA-10 | steel axle | 1105.841
A-11 | steel laser plate | 15033.298 | 240 mm centre distance; 3 mm; 8.1 mm holes
R-11 | POM/urethane crown | 12214.515 | spherical crown R20, width12; material/hysteresis to validate
RB-11a | 688 bearing | 753.982
RB-11b | 688 bearing | 753.982
RA-11 | steel axle | 1105.841
A-12 | steel laser plate | 15033.298 | 240 mm centre distance; 3 mm; 8.1 mm holes
R-12 | POM/urethane crown | 12214.515 | spherical crown R20, width12; material/hysteresis to validate
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
RB-27b | 688 bearing | 753.982
RA-27 | steel axle | 1105.841
A-28 | steel laser plate | 15033.298 | 240 mm centre distance; 3 mm; 8.1 mm holes
R-28 | POM/urethane crown | 12214.515 | spherical crown R20, width12; material/hysteresis to validate
RB-28a | 688 bearing | 753.982
RB-28b | 688 bearing | 753.982
RA-28 | steel axle | 1105.841
A-29 | steel laser plate | 15033.298 | 240 mm centre distance; 3 mm; 8.1 mm holes
R-29 | POM/urethane crown | 12214.515 | spherical crown R20, width12; material/hysteresis to validate
RB-29a | 688 bearing | 753.982
RB-29b | 688 bearing | 753.982
RA-29 | steel axle | 1105.841
A-30 | steel laser plate | 15033.298 | 240 mm centre distance; 3 mm; 8.1 mm holes
R-30 | POM/urethane crown | 12214.515 | spherical crown R20, width12; material/hysteresis to validate
RB-30a | 688 bearing | 753.982
RB-30b | 688 bearing | 753.982
RA-30 | steel axle | 1105.841
A-31 | steel laser plate | 15033.298 | 240 mm centre distance; 3 mm; 8.1 mm holes
R-31 | POM/urethane crown | 12214.515 | spherical crown R20, width12; material/hysteresis to validate
RB-31a | 688 bearing | 753.982
RB-31b | 688 bearing | 753.982
RA-31 | steel axle | 1105.841
E-enclosure | purchased enclosure | 2624000.0 | Pi and acquisition carrier; sealed connectors not detailed
B-battery-envelope | certified battery assembly | 1638000.0 | purchased battery+BMS; no cell-pack fabrication instructions
H01-L | steel | 125120.0
H01-R | steel | 125120.0
H02-grip | steel | 81880.0
REFERENCE-road | reference only | 12600000.0
REFERENCE-curb | reference only | 91800000.0 | vertical face deliberately not traversed
BR-01 | aluminium bracket | 5640.384 | bearing bore 16.05; retention/fasteners require review
PB-01 | 688 bearing | 753.982 | centre Y=0; +/-2.5 mm
PS-01 | steel shaft | 829.38 | Y -11.5..+5; positive arm coupling remains to detail
PC-01 | spacer | 246.269 | Y -6.5..-2.5
PM-01 | magnet | 84.823 | Y +5..+8; end-face attachment; no overlap with shaft
PE-01 | PCB FR4 envelope | 679.036 | Y9.9..11.5; holes match encoder PCB
IC-01 | AS5048A package envelope | 38.4 | magnet-face to package 0.7 mm; actual sensitive-layer gap needs calibration
STL-01 | nonmagnetic standoff | 64.861 | PCB support, unthreaded CAD bore
STR-01 | nonmagnetic standoff | 64.861 | PCB support, unthreaded CAD bore
SP-01 | torsion spring envelope | 158.336 | not a released spring winding or fatigue design
BR-02 | aluminium bracket | 5640.384 | bearing bore 16.05; retention/fasteners require review
PB-02 | 688 bearing | 753.982 | centre Y=0; +/-2.5 mm
PS-02 | steel shaft | 829.38 | Y -11.5..+5; positive arm coupling remains to detail
PC-02 | spacer | 246.269 | Y -6.5..-2.5
PM-02 | magnet | 84.823 | Y +5..+8; end-face attachment; no overlap with shaft
PE-02 | PCB FR4 envelope | 679.036 | Y9.9..11.5; holes match encoder PCB
IC-02 | AS5048A package envelope | 38.4 | magnet-face to package 0.7 mm; actual sensitive-layer gap needs calibration
STL-02 | nonmagnetic standoff | 64.861 | PCB support, unthreaded CAD bore
STR-02 | nonmagnetic standoff | 64.861 | PCB support, unthreaded CAD bore
SP-02 | torsion spring envelope | 158.336 | not a released spring winding or fatigue design
BR-03 | aluminium bracket | 5640.384 | bearing bore 16.05; retention/fasteners require review
PB-03 | 688 bearing | 753.982 | centre Y=0; +/-2.5 mm
PS-03 | steel shaft | 829.38 | Y -11.5..+5; positive arm coupling remains to detail
PC-03 | spacer | 246.269 | Y -6.5..-2.5
PM-03 | magnet | 84.823 | Y +5..+8; end-face attachment; no overlap with shaft
PE-03 | PCB FR4 envelope | 679.036 | Y9.9..11.5; holes match encoder PCB
IC-03 | AS5048A package envelope | 38.4 | magnet-face to package 0.7 mm; actual sensitive-layer gap needs calibration
STL-03 | nonmagnetic standoff | 64.861 | PCB support, unthreaded CAD bore
STR-03 | nonmagnetic standoff | 64.861 | PCB support, unthreaded CAD bore
SP-03 | torsion spring envelope | 158.336 | not a released spring winding or fatigue design
BR-04 | aluminium bracket | 5640.384 | bearing bore 16.05; retention/fasteners require review
PB-04 | 688 bearing | 753.982 | centre Y=0; +/-2.5 mm
PS-04 | steel shaft | 829.38 | Y -11.5..+5; positive arm coupling remains to detail
PC-04 | spacer | 246.269 | Y -6.5..-2.5
PM-04 | magnet | 84.823 | Y +5..+8; end-face attachment; no overlap with shaft
PE-04 | PCB FR4 envelope | 679.036 | Y9.9..11.5; holes match encoder PCB
IC-04 | AS5048A package envelope | 38.4 | magnet-face to package 0.7 mm; actual sensitive-layer gap needs calibration
STL-04 | nonmagnetic standoff | 64.861 | PCB support, unthreaded CAD bore
STR-04 | nonmagnetic standoff | 64.861 | PCB support, unthreaded CAD bore
SP-04 | torsion spring envelope | 158.336 | not a released spring winding or fatigue design
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
PS-29 | steel shaft | 829.38 | Y -11.5..+5; positive arm coupling remains to detail
PC-29 | spacer | 246.269 | Y -6.5..-2.5
PM-29 | magnet | 84.823 | Y +5..+8; end-face attachment; no overlap with shaft
PE-29 | PCB FR4 envelope | 679.036 | Y9.9..11.5; holes match encoder PCB
IC-29 | AS5048A package envelope | 38.4 | magnet-face to package 0.7 mm; actual sensitive-layer gap needs calibration
STL-29 | nonmagnetic standoff | 64.861 | PCB support, unthreaded CAD bore
STR-29 | nonmagnetic standoff | 64.861 | PCB support, unthreaded CAD bore
SP-29 | torsion spring envelope | 158.336 | not a released spring winding or fatigue design
BR-30 | aluminium bracket | 5640.384 | bearing bore 16.05; retention/fasteners require review
PB-30 | 688 bearing | 753.982 | centre Y=0; +/-2.5 mm
PS-30 | steel shaft | 829.38 | Y -11.5..+5; positive arm coupling remains to detail
PC-30 | spacer | 246.269 | Y -6.5..-2.5
PM-30 | magnet | 84.823 | Y +5..+8; end-face attachment; no overlap with shaft
PE-30 | PCB FR4 envelope | 679.036 | Y9.9..11.5; holes match encoder PCB
IC-30 | AS5048A package envelope | 38.4 | magnet-face to package 0.7 mm; actual sensitive-layer gap needs calibration
STL-30 | nonmagnetic standoff | 64.861 | PCB support, unthreaded CAD bore
STR-30 | nonmagnetic standoff | 64.861 | PCB support, unthreaded CAD bore
SP-30 | torsion spring envelope | 158.336 | not a released spring winding or fatigue design
BR-31 | aluminium bracket | 5640.384 | bearing bore 16.05; retention/fasteners require review
PB-31 | 688 bearing | 753.982 | centre Y=0; +/-2.5 mm
PS-31 | steel shaft | 829.38 | Y -11.5..+5; positive arm coupling remains to detail
PC-31 | spacer | 246.269 | Y -6.5..-2.5
PM-31 | magnet | 84.823 | Y +5..+8; end-face attachment; no overlap with shaft
PE-31 | PCB FR4 envelope | 679.036 | Y9.9..11.5; holes match encoder PCB
IC-31 | AS5048A package envelope | 38.4 | magnet-face to package 0.7 mm; actual sensitive-layer gap needs calibration
STL-31 | nonmagnetic standoff | 64.861 | PCB support, unthreaded CAD bore
STR-31 | nonmagnetic standoff | 64.861 | PCB support, unthreaded CAD bore
SP-31 | torsion spring envelope | 158.336 | not a released spring winding or fatigue design
