Eljah/qulay/electronics/generated/carrier/BOM.csv

reference | value | footprint | quantity_per_board
U1 | Raspberry_Pi_Pico_USB_powered | PICO40 | 1
J1 | EXTERNAL_3V3_CURRENT_LIMITED | H2 | 1
F1 | PTC_hold_0.75A_review_derating | F1206 | 1
J2 | SPI_BANK_0 | H6 | 1
J3 | SPI_BANK_1 | H6 | 1
J4 | SPI_BANK_2 | H6 | 1
J5 | SPI_BANK_3 | H6 | 1
J6 | ADXL355_3V3_MODULE | H7 | 1
J7 | ODOMETER_3V3_ONLY | H4 | 1
C1 | 100n | C0603 | 1
C2 | 10u 6.3V | C0603 | 1
