Eljah/qulay/electronics/generated-r2/carrier_r2/connections.csv

reference | pin | net | pin_type
U1 | 1 | ODO_A | passive
U1 | 2 | ODO_B | passive
U1 | 3 | GND | passive
U1 | 4 | P_SCK0 | passive
U1 | 5 | P_MOSI0 | passive
U1 | 6 | MISO0 | passive
U1 | 7 | P_CS0 | passive
U1 | 8 | GND | passive
U1 | 9 | P_CS1 | passive
U1 | 10 | P_CS2 | passive
U1 | 11 | P_CS3 | passive
U1 | 12 | NC | passive
U1 | 13 | GND | passive
U1 | 14 | P_SCK1 | passive
U1 | 15 | P_MOSI1 | passive
U1 | 16 | MISO1 | passive
U1 | 17 | CS_ADXL | passive
U1 | 18 | GND | passive
U1 | 19 | DRDY_ADXL | passive
U1 | 20 | NC | passive
U1 | 21 | P_ADC_CS0 | passive
U1 | 22 | P_ADC_CS1 | passive
U1 | 23 | GND | passive
U1 | 24 | P_ADC_CS2 | passive
U1 | 25 | P_ADC_CS3 | passive
U1 | 26 | LIFT_STOWED_N | passive
U1 | 27 | POWER_GOOD | passive
U1 | 28 | GND | passive
U1 | 29 | SENSOR_ENABLE | passive
U1 | 30 | NC | passive
U1 | 31 | NC | passive
U1 | 32 | NC | passive
U1 | 33 | GND | passive
U1 | 34 | NC | passive
U1 | 35 | NC | passive
U1 | 36 | PICO_3V3 | power_out
U1 | 37 | NC | passive
U1 | 38 | GND | passive
U1 | 39 | NC | passive
U1 | 40 | NC | passive
J1 | 1 | SENS_3V3 | power_out
J1 | 2 | GND | power_out
U2 | 1 | OE_SENS_N | input
U2 | 2 | P_SCK0 | input
U2 | 3 | ADC_MOSI_BUF | tri_state
U2 | 4 | P_MOSI0 | input
U2 | 5 | ADC_SCK_BUF | tri_state
U2 | 6 | P_CS0 | input
U2 | 7 | CS3 | tri_state
U2 | 8 | P_CS1 | input
U2 | 9 | CS2 | tri_state
U2 | 10 | GND | power_in
U2 | 11 | P_CS2 | input
U2 | 12 | CS1 | tri_state
U2 | 13 | P_CS3 | input
U2 | 14 | CS0 | tri_state
U2 | 15 | P_SCK1 | input
U2 | 16 | MOSI0_BUF | tri_state
U2 | 17 | P_MOSI1 | input
U2 | 18 | SCK0_BUF | tri_state
U2 | 19 | OE_SENS_N | input
U2 | 20 | SENS_3V3 | power_in
U3 | 1 | OE_SENS_N | input
U3 | 2 | P_ADC_CS0 | input
U3 | 3 | NC | tri_state
U3 | 4 | P_ADC_CS1 | input
U3 | 5 | NC | tri_state
U3 | 6 | P_ADC_CS2 | input
U3 | 7 | NC | tri_state
U3 | 8 | P_ADC_CS3 | input
U3 | 9 | NC | tri_state
U3 | 10 | GND | power_in
U3 | 11 | GND | input
U3 | 12 | ADC_CS3 | tri_state
U3 | 13 | GND | input
U3 | 14 | ADC_CS2 | tri_state
U3 | 15 | GND | input
U3 | 16 | ADC_CS1 | tri_state
U3 | 17 | GND | input
U3 | 18 | ADC_CS0 | tri_state
U3 | 19 | OE_SENS_N | input
U3 | 20 | SENS_3V3 | power_in
U4 | 1 | GND | input
U4 | 2 | MISO0_RAW | input
U4 | 3 | MISO0 | tri_state
U4 | 4 | GND | input
U4 | 5 | MISO1_RAW | input
U4 | 6 | MISO1 | tri_state
U4 | 7 | GND | power_in
U4 | 8 | NC | passive
U4 | 9 | GND | passive
U4 | 10 | PICO_3V3 | input
U4 | 11 | NC | passive
U4 | 12 | GND | passive
U4 | 13 | PICO_3V3 | input
U4 | 14 | PICO_3V3 | power_in
C1 | 1 | SENS_3V3 | passive
C1 | 2 | GND | passive
C2 | 1 | SENS_3V3 | passive
C2 | 2 | GND | passive
C3 | 1 | PICO_3V3 | passive
C3 | 2 | GND | passive
C4 | 1 | SENS_3V3 | passive
C4 | 2 | GND | passive
J2 | 1 | SENS_3V3 | passive
J2 | 2 | GND | passive
J2 | 3 | CS0 | passive
J2 | 4 | SCK0 | passive
J2 | 5 | MOSI0 | passive
J2 | 6 | MISO0_RAW | passive
J3 | 1 | SENS_3V3 | passive
J3 | 2 | GND | passive
J3 | 3 | CS1 | passive
J3 | 4 | SCK0 | passive
J3 | 5 | MOSI0 | passive
J3 | 6 | MISO0_RAW | passive
J4 | 1 | SENS_3V3 | passive
J4 | 2 | GND | passive
J4 | 3 | CS2 | passive
J4 | 4 | SCK0 | passive
J4 | 5 | MOSI0 | passive
J4 | 6 | MISO0_RAW | passive
J5 | 1 | SENS_3V3 | passive
J5 | 2 | GND | passive
J5 | 3 | CS3 | passive
J5 | 4 | SCK0 | passive
J5 | 5 | MOSI0 | passive
J5 | 6 | MISO0_RAW | passive
J6 | 1 | PICO_3V3 | passive
J6 | 2 | GND | passive
J6 | 3 | P_SCK1 | passive
J6 | 4 | P_MOSI1 | passive
J6 | 5 | MISO1_RAW | passive
J6 | 6 | CS_ADXL | passive
J6 | 7 | DRDY_ADXL | passive
J7 | 1 | PICO_3V3 | passive
J7 | 2 | GND | passive
J7 | 3 | ODO_A | passive
J7 | 4 | ODO_B | passive
J8 | 1 | SENS_3V3 | passive
J8 | 2 | GND | passive
J8 | 3 | ADC_SCK | passive
J8 | 4 | ADC_MOSI | passive
J8 | 5 | MISO1_RAW | passive
J8 | 6 | ADC_CS0 | passive
J8 | 7 | ADC_CS1 | passive
J8 | 8 | ADC_CS2 | passive
J8 | 9 | ADC_CS3 | passive
J8 | 10 | GND | passive
J9 | 1 | GND | passive
J9 | 2 | LIFT_STOWED_N | passive
J9 | 3 | POWER_GOOD | passive
J9 | 4 | PICO_3V3 | passive
R1 | 1 | SENS_3V3 | passive
R1 | 2 | CS0 | passive
R2 | 1 | SENS_3V3 | passive
R2 | 2 | CS1 | passive
R3 | 1 | SENS_3V3 | passive
R3 | 2 | CS2 | passive
R4 | 1 | SENS_3V3 | passive
R4 | 2 | CS3 | passive
R5 | 1 | SENS_3V3 | passive
R5 | 2 | ADC_CS0 | passive
R6 | 1 | SENS_3V3 | passive
R6 | 2 | ADC_CS1 | passive
R7 | 1 | SENS_3V3 | passive
R7 | 2 | ADC_CS2 | passive
R8 | 1 | SENS_3V3 | passive
R8 | 2 | ADC_CS3 | passive
Q1 | 1 | Q_BASE | passive
Q1 | 2 | GND | passive
Q1 | 3 | OE_SENS_N | open_collector
R9 | 1 | SENSOR_ENABLE | passive
R9 | 2 | Q_BASE | passive
R10 | 1 | Q_BASE | passive
R10 | 2 | GND | passive
R11 | 1 | SENS_3V3 | passive
R11 | 2 | OE_SENS_N | passive
R12 | 1 | POWER_GOOD | passive
R12 | 2 | GND | passive
R13 | 1 | MISO0_RAW | passive
R13 | 2 | GND | passive
R14 | 1 | MISO1_RAW | passive
R14 | 2 | GND | passive
R15 | 1 | SCK0_BUF | passive
R15 | 2 | SCK0 | passive
R16 | 1 | MOSI0_BUF | passive
R16 | 2 | MOSI0 | passive
R17 | 1 | ADC_SCK_BUF | passive
R17 | 2 | ADC_SCK | passive
R18 | 1 | ADC_MOSI_BUF | passive
R18 | 2 | ADC_MOSI | passive
