Eljah/qulay/electronics/generated/carrier/connections.csv

reference | pin | net | pin_type
U1 | 1 | ODO_A | passive
U1 | 2 | ODO_B | passive
U1 | 3 | GND | passive
U1 | 4 | SCK0 | passive
U1 | 5 | MOSI0 | passive
U1 | 6 | MISO0 | passive
U1 | 7 | CS0 | passive
U1 | 8 | GND | passive
U1 | 9 | CS1 | passive
U1 | 10 | CS2 | passive
U1 | 11 | CS3 | passive
U1 | 12 | NC | passive
U1 | 13 | GND | passive
U1 | 14 | SCK1 | passive
U1 | 15 | MOSI1 | passive
U1 | 16 | MISO1 | passive
U1 | 17 | CS_ADXL | passive
U1 | 18 | GND | passive
U1 | 19 | DRDY_ADXL | passive
U1 | 20 | NC | passive
U1 | 21 | NC | passive
U1 | 22 | NC | passive
U1 | 23 | GND | passive
U1 | 24 | NC | passive
U1 | 25 | NC | passive
U1 | 26 | NC | passive
U1 | 27 | NC | passive
U1 | 28 | GND | passive
U1 | 29 | NC | passive
U1 | 30 | NC | passive
U1 | 31 | NC | passive
U1 | 32 | NC | passive
U1 | 33 | GND | passive
U1 | 34 | NC | passive
U1 | 35 | NC | passive
U1 | 36 | PICO_3V3 | power_out
U1 | 37 | NC | passive
U1 | 38 | GND | passive
U1 | 39 | NC | passive
U1 | 40 | NC | passive
J1 | 1 | EXT_3V3 | power_out
J1 | 2 | GND | power_out
F1 | 1 | EXT_3V3 | passive
F1 | 2 | SENS_3V3 | passive
J2 | 1 | SENS_3V3 | passive
J2 | 2 | GND | passive
J2 | 3 | CS0 | passive
J2 | 4 | SCK0 | passive
J2 | 5 | MOSI0 | passive
J2 | 6 | MISO0 | passive
J3 | 1 | SENS_3V3 | passive
J3 | 2 | GND | passive
J3 | 3 | CS1 | passive
J3 | 4 | SCK0 | passive
J3 | 5 | MOSI0 | passive
J3 | 6 | MISO0 | passive
J4 | 1 | SENS_3V3 | passive
J4 | 2 | GND | passive
J4 | 3 | CS2 | passive
J4 | 4 | SCK0 | passive
J4 | 5 | MOSI0 | passive
J4 | 6 | MISO0 | passive
J5 | 1 | SENS_3V3 | passive
J5 | 2 | GND | passive
J5 | 3 | CS3 | passive
J5 | 4 | SCK0 | passive
J5 | 5 | MOSI0 | passive
J5 | 6 | MISO0 | passive
J6 | 1 | PICO_3V3 | passive
J6 | 2 | GND | passive
J6 | 3 | SCK1 | passive
J6 | 4 | MOSI1 | passive
J6 | 5 | MISO1 | passive
J6 | 6 | CS_ADXL | passive
J6 | 7 | DRDY_ADXL | passive
J7 | 1 | PICO_3V3 | passive
J7 | 2 | GND | passive
J7 | 3 | ODO_A | passive
J7 | 4 | ODO_B | passive
C1 | 1 | SENS_3V3 | passive
C1 | 2 | GND | passive
C2 | 1 | SENS_3V3 | passive
C2 | 2 | GND | passive
