Eljah/qulay/electronics/generated/encoder/connections.csv

reference | pin | net | pin_type
U1 | 1 | CS | input
U1 | 2 | SCK | input
U1 | 3 | DOUT | tri_state
U1 | 4 | DIN | input
U1 | 5 | GND | power_in
U1 | 6 | NC | passive
U1 | 7 | NC | passive
U1 | 8 | NC | passive
U1 | 9 | NC | passive
U1 | 10 | NC | passive
U1 | 11 | SENS_3V3 | power_in
U1 | 12 | SENS_3V3 | power_in
U1 | 13 | GND | power_in
U1 | 14 | NC | passive
J1 | 1 | SENS_3V3 | power_out
J1 | 2 | GND | power_out
J1 | 3 | CS | output
J1 | 4 | SCK | output
J1 | 5 | DIN | output
J1 | 6 | DOUT | input
C1 | 1 | SENS_3V3 | passive
C1 | 2 | GND | passive
C2 | 1 | SENS_3V3 | passive
C2 | 2 | GND | passive
