Eljah/qulay/mechanical/coupling_c1/generated/Qulay-C1-crossing.step

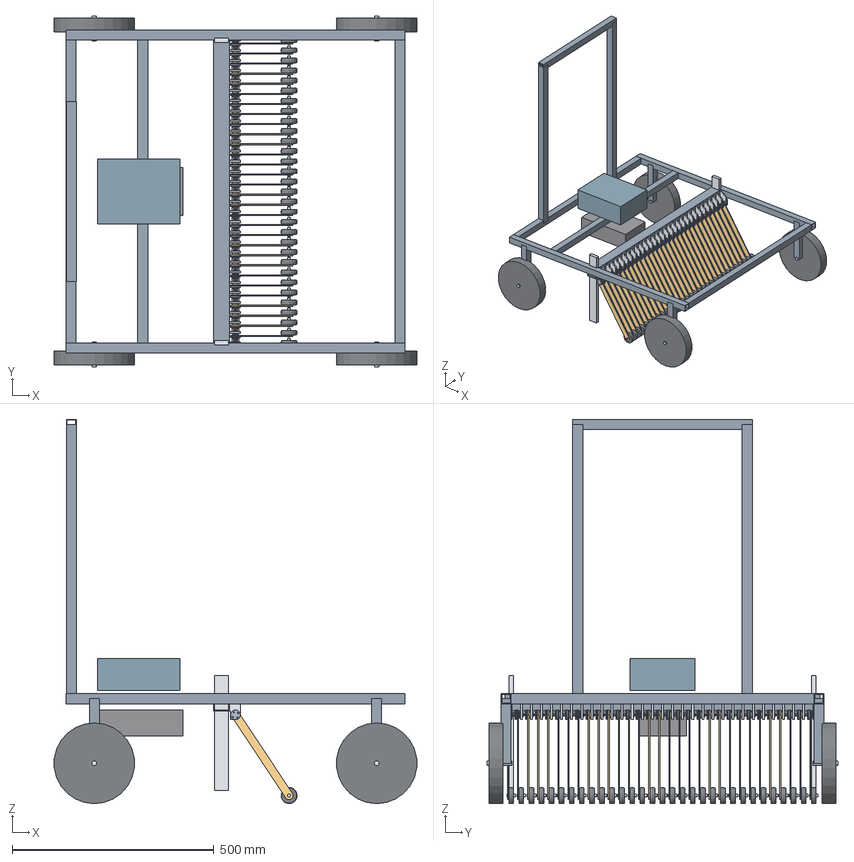
[picture p29: CAD file, 2026-10-04]
mechanical/coupling_c1/generated/Qulay-C1-crossing.step
898.5 x 870.0 x 952.5 mm
F01-L
F01-R
F02-rear
F02-front
F03-rear-cross
W-leg-rear-L
W-axle-rear-L
W-wheel-rear-L
W-leg-rear-R
W-axle-rear-R
W-wheel-rear-R
W-leg-front-L
W-axle-front-L
W-wheel-front-L
W-leg-front-R
W-axle-front-R
W-wheel-front-R
C-slide-L
C-slide-R
C01-pivot-beam
R-01
RB-01a
RB-01b
RA-01
R-02
RB-02a
RB-02b
RA-02
R-03
RB-03a
RB-03b
RA-03
R-04
RB-04a
RB-04b
RA-04
R-05
RB-05a
RB-05b
RA-05
R-06
RB-06a
RB-06b
RA-06
R-07
RB-07a
RB-07b
RA-07
R-08
RB-08a
RB-08b
RA-08
R-09
RB-09a
RB-09b
RA-09
R-10
RB-10a
RB-10b
RA-10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
