Eljah/qulay/mechanical/generated/arm-240mm-3mm.step

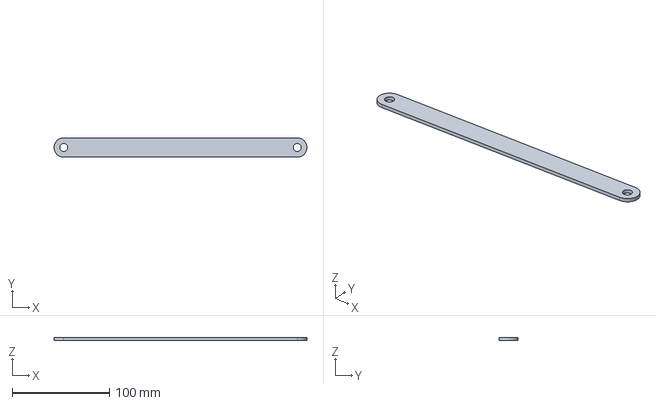
[picture p31: CAD file, 2026-10-02]
mechanical/generated/arm-240mm-3mm.step
260.0 x 20.0 x 3.00 mm
