Eljah/qulay/mechanical/coupling_c1/generated/C1-PIN-1.step

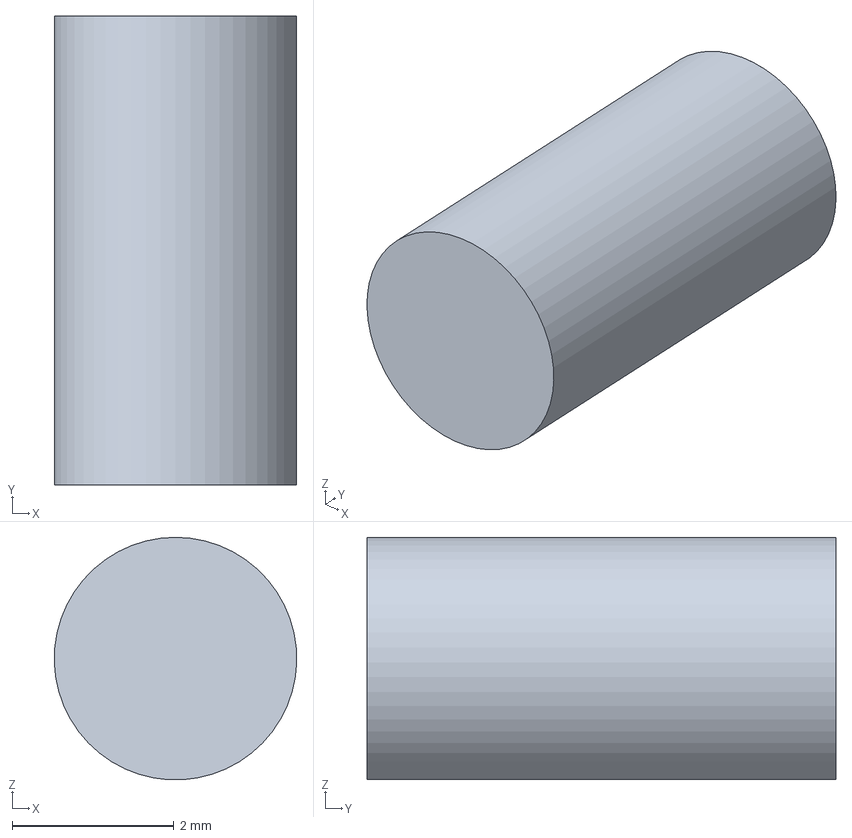
[picture p32: CAD file, 2026-10-04]
mechanical/coupling_c1/generated/C1-PIN-1.step
3.00 x 5.80 x 3.00 mm
