Eljah/qulay/mechanical/generated/qulay-along-curb.step

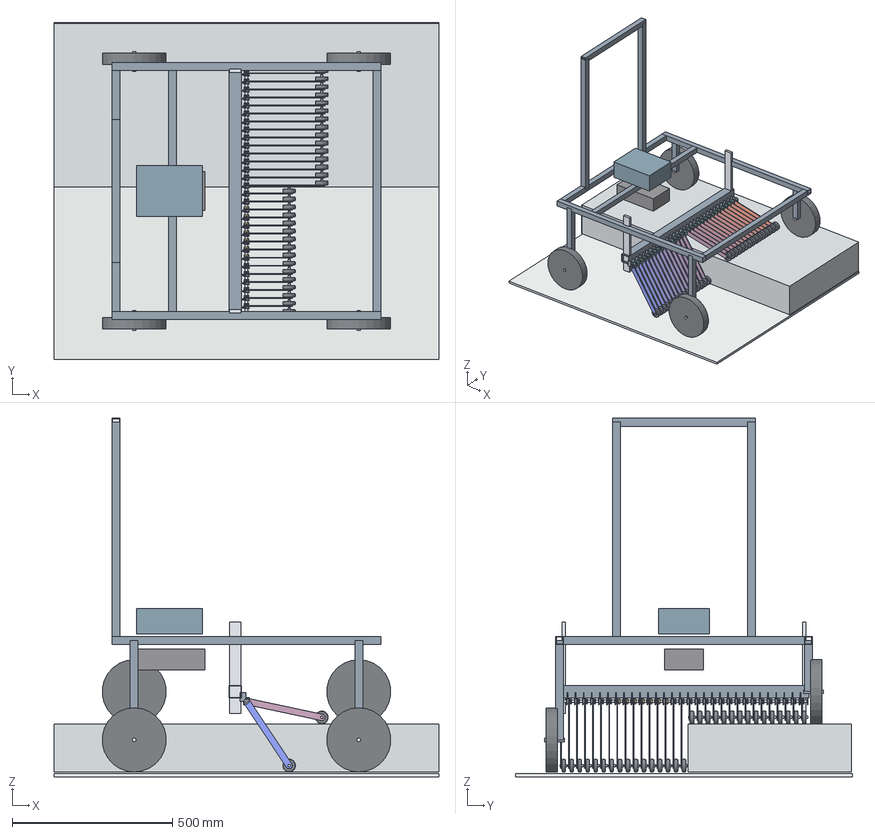
[picture p34: CAD file, 2026-10-02]
mechanical/generated/qulay-along-curb.step
1200.0 x 1050.0 x 1117.5 mm
F01-L
F01-R
F02-rear
F02-front
F03-rear-cross
W-leg-rear-L
W-axle-rear-L
W-wheel-rear-L
W-leg-rear-R
W-axle-rear-R
W-wheel-rear-R
W-leg-front-L
W-axle-front-L
W-wheel-front-L
W-leg-front-R
W-axle-front-R
W-wheel-front-R
C-slide-L
C-slide-R
C01-pivot-beam
A-01
R-01
RB-01a
RB-01b
RA-01
PB-01
PS-01
PM-01
PE-01
SP-01
BR-01
A-02
R-02
RB-02a
RB-02b
RA-02
PB-02
PS-02
PM-02
PE-02
SP-02
BR-02
A-03
R-03
RB-03a
RB-03b
RA-03
PB-03
PS-03
PM-03
PE-03
SP-03
BR-03
A-04
R-04
RB-04a
RB-04b
RA-04
PB-04
PS-04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
