Eljah/qulay/mechanical/generated-r1/pivot-bracket-5mm.dxf

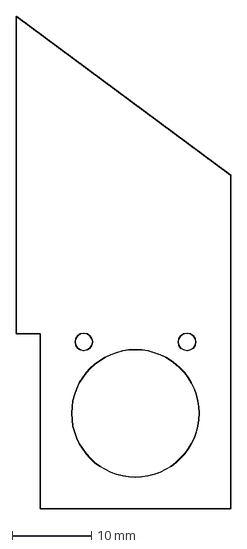
[picture p35: CAD file, 2026-10-02]
mechanical/generated-r1/pivot-bracket-5mm.dxf
27.0 x 62.0 mm
