Eljah/qulay/mechanical/coupling_c1/generated/C1-arm-finished-face.dxf

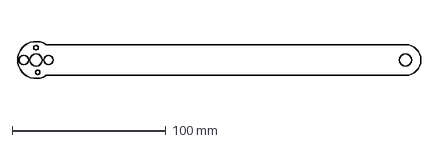
[picture p40: CAD file, 2026-10-04]
mechanical/coupling_c1/generated/C1-arm-finished-face.dxf
263.0 x 26.6 mm
