Eljah/qulay/mechanical/coupling_c1/generated/C1-ARM.step

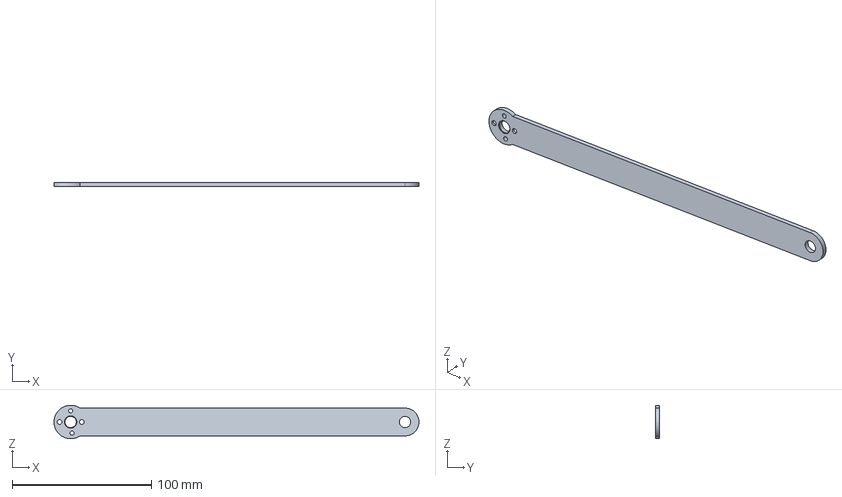
[picture p41: CAD file, 2026-10-04]
mechanical/coupling_c1/generated/C1-ARM.step
262.0 x 3.00 x 24.0 mm
