Eljah/qulay/mechanical/coupling_c1/generated/C1-flange-hole-map.dxf

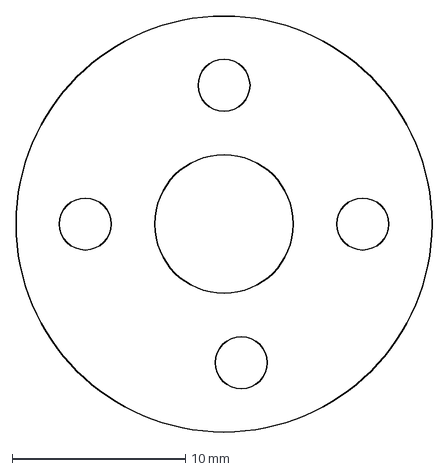
[picture p42: CAD file, 2026-10-04]
mechanical/coupling_c1/generated/C1-flange-hole-map.dxf
24.0 x 24.0 mm
