Eljah/qulay/mechanical/coupling_c1/generated/C1-SHAFT.step

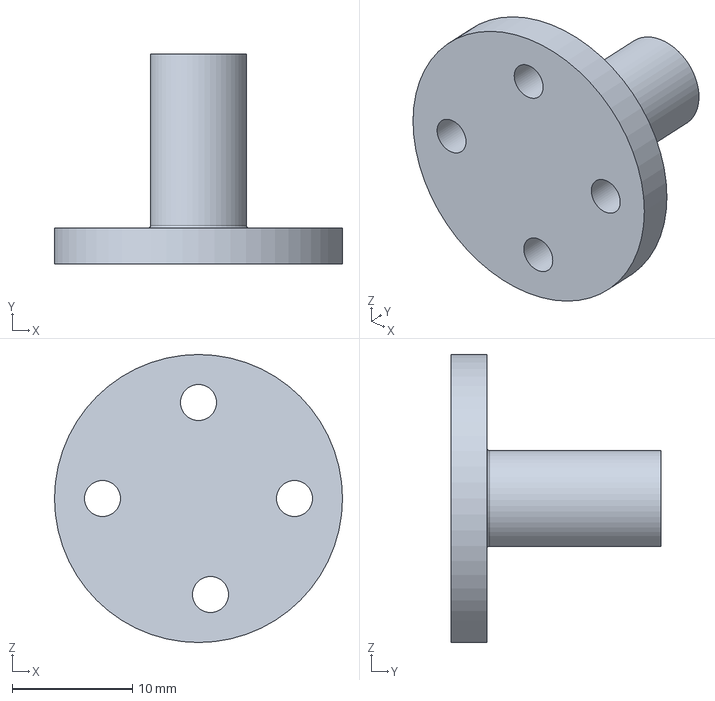
[picture p43: CAD file, 2026-10-04]
mechanical/coupling_c1/generated/C1-SHAFT.step
24.0 x 17.5 x 24.0 mm
