Eljah/qulay/mechanical/coupling_c1/generated/C1-exploded.step

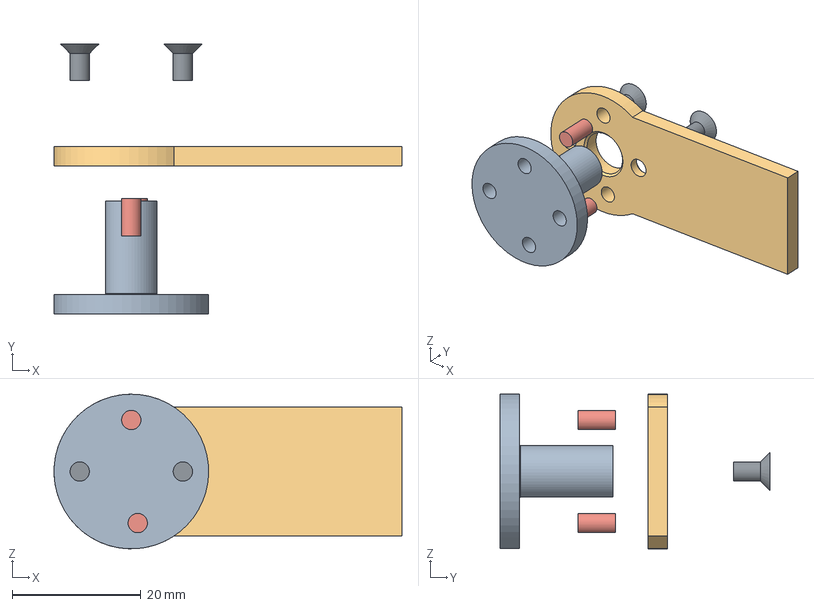
[picture p44: CAD file, 2026-10-04]
mechanical/coupling_c1/generated/C1-exploded.step
54.0 x 41.9 x 24.0 mm
C1-SHAFT
C1-ARM
C1-PIN-1
C1-PIN-2
C1-SCREW-1
C1-SCREW-2
