Eljah/qulay/(list of files, cad)

Other CAD files:
mechanical/coupling_c1/generated/C1-PIN-2.step
mechanical/coupling_c1/generated/Qulay-C1-datum-rail.step
mechanical/coupling_c1/generated/Qulay-C1-along-curb.step
mechanical/coupling_c1/generated/C1-SCREW-1.step
mechanical/coupling_c1/generated/C1-SCREW-2.step
mechanical/generated/arm-240mm-3mm.dxf
