Eljah/qulay/docs/manual/manual.md

# 01. Назначение и статус документа
@sources S1,S2,S3,S5

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

## Как читать обозначения

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

## Состав альбома

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

# 02. Система координат и рабочие положения
@sources S1,S2,S3

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

@dimensions

## Нумерация каналов

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

## Различие трёх положений

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

# 03. Состав общей механической сборки
@sources S1,S2,S3

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

@bom_base

## До заказа покупных узлов

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

# 04. Комплект одного измерительного канала
@sources S2,S3,S5

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

@bom_channel

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

# 05. Заготовки рамы и резка труб
@sources S1,S2,S4

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

@cuts

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

# 06. Подготовка и сборка рамы
@sources S1,S2,S4

## Операция М01 — входной контроль

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

## Операция М02 — выставление прямоугольника

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

## Операция М03 — соединения и защита

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

## Операция М04 — опоры и рукоять

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

# 07. Установка кассеты и кронштейнов
@sources S1,S2,S3

## Операция М05 — поперечина и направляющие кассеты

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

## Операция М06 — базирование ряда

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

## Операция М07 — кронштейн BR

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

# 08. Сборка рычага, ролика и шарнира
@sources S1,S2,S3

## Операция М08 — роликовый узел

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

## Операция М09 — рычаг A

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

## Операция М10 — шарнир

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

# 09. Монтаж магнита и платы encoder
@sources S2,S3,S5,S10

## Операция Э01 — подготовка платы

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

## Операция Э02 — магнит и осевой зазор

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

## Операция Э03 — контроль соседнего канала

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

# 10. Монтаж ящика, SBC и вспомогательных датчиков
@sources S1,S2,S5,S7

## Операция Э04 — ящик и батарея

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

## Операция Э05 — carrier и Pico

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

## Операция Э06 — наклон и пробег

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

# 11. Жгуты и разделение питания
@sources S5,S6,S7

## Операция Э07 — механическая прокладка

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

## Питание: три разных интерфейса

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

@power

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

# 12. Распиновка разъёмов
@sources S5,S6,S7

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

@pinout

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

# 13. Карта каналов 01–16
@sources S2,S6,S7

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

@channels_first

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

# 14. Карта каналов 17–31
@sources S2,S6,S7

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

@channels_second

## Проверка полного комплекта

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

# 15. Первичное включение и проверка монтажа
@sources S5,S6,S7,S9

## Операция П01 — без питания

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

## Операция П02 — Pico отдельно

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

## Операция П03 — стенд датчиков

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

## Операция П04 — весь измерительный ряд

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

# 16. Механическая наладка и калибровка
@sources S1,S2,S3,S7,S8

## Операция П05 — свободный ход

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

## Операция П06 — геометрическая калибровка

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

## Операция П07 — тракт данных

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

# 17. Переналадка на два режима обследования
@sources S1,S2,S8

## Поперёк перехода дорога — тротуар

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

## Вдоль бордюра

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

# 18. Обслуживание и поиск неисправностей
@sources S2,S5,S6,S7,S8

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

# 19. Неопределённые узлы и контрольные остановки
@sources S1,S2,S3,S5,S8,S9

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

# 20. Форма механического контроля
@sources S1,S2,S3,S4

Серийный номер образца: __________________  Дата: __________________

Сборщик: __________________  Контролёр: __________________________

CAD/ревизия: __________________  Утверждённые изменения: ___________

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

Допуски и критерии по документу: __________________________________

Незакрытые КО: __________________________________________________

Разрешён следующий этап: _________________________________________

Подпись контролёра: __________________  Дата: _____________________

> Эта форма фиксирует контроль сборки. Она не заменяет поверку и не является актом приёмки доступной среды.

# 21. Форма электрического и поканального контроля
@sources S5,S6,S7

PCB/ревизия: _________________  Прошивка/хеш: _____________________

Напряжение EXT_3V3: __________  Дальний encoder: ___________________

Ток ветвей J2/J3/J4/J5: __________ / __________ / __________ / __________

Ориентация ADXL355: __________  Масштаб одометра: ________________

@channel_check

CRC/тайм-ауты: _______________  Файл пробного прохода: ______________

Контрольные суммы сохранены: ______  Незакрытые КО: ______________

Исполнитель / подпись: _________________  Дата: ___________________

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

# 22. Источники и прослеживаемость
@sources S1,S2,S3,S4,S5,S6,S7,S8,S9,S10,S11

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

@sources_table

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
