Eljah/qulay/docs/manual/assets/r1-channel.png

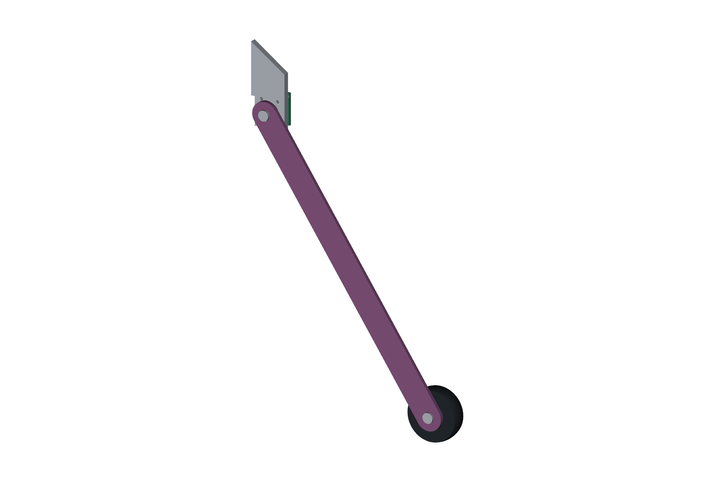
docs/manual/assets/r1-channel.png
