Eljah/qulay/docs/manual/assets/r1-frame.png

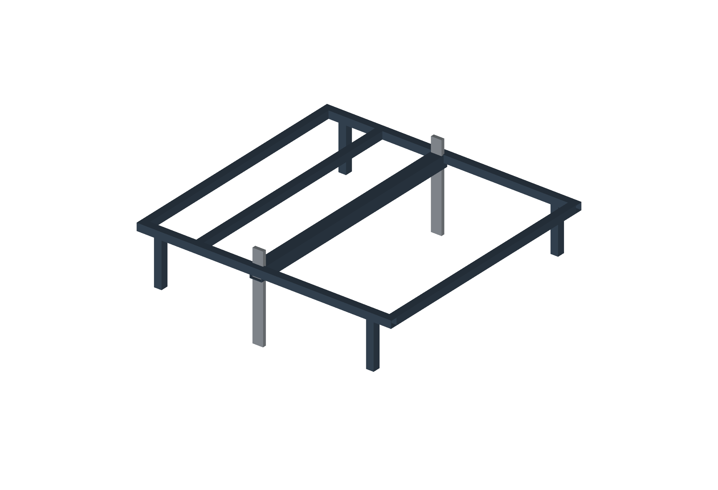
docs/manual/assets/r1-frame.png
