Eljah/qulay/docs/manual/assets/r1-pivot-exploded.png

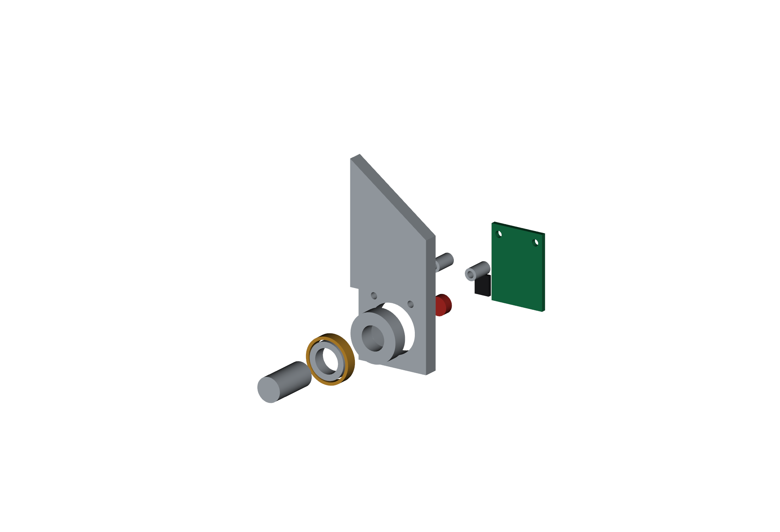
docs/manual/assets/r1-pivot-exploded.png
