Eljah/qulay/docs/manual/assets/r1-side.png

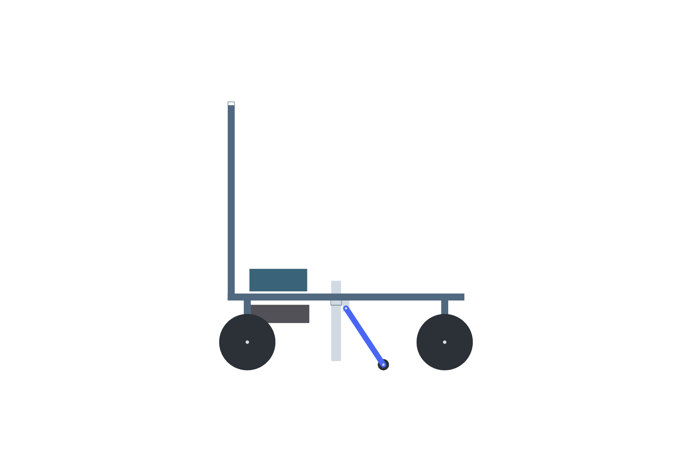
docs/manual/assets/r1-side.png
