Eljah/qulay/docs/manual/assets/r1-top.png

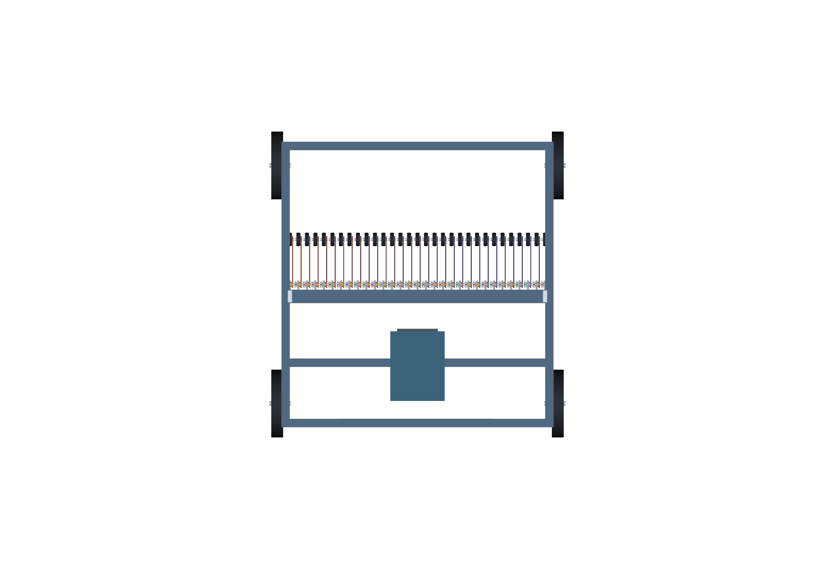
docs/manual/assets/r1-top.png
