Eljah/qulay/electronics/generated-r2/adc/adc-assembly.pdf

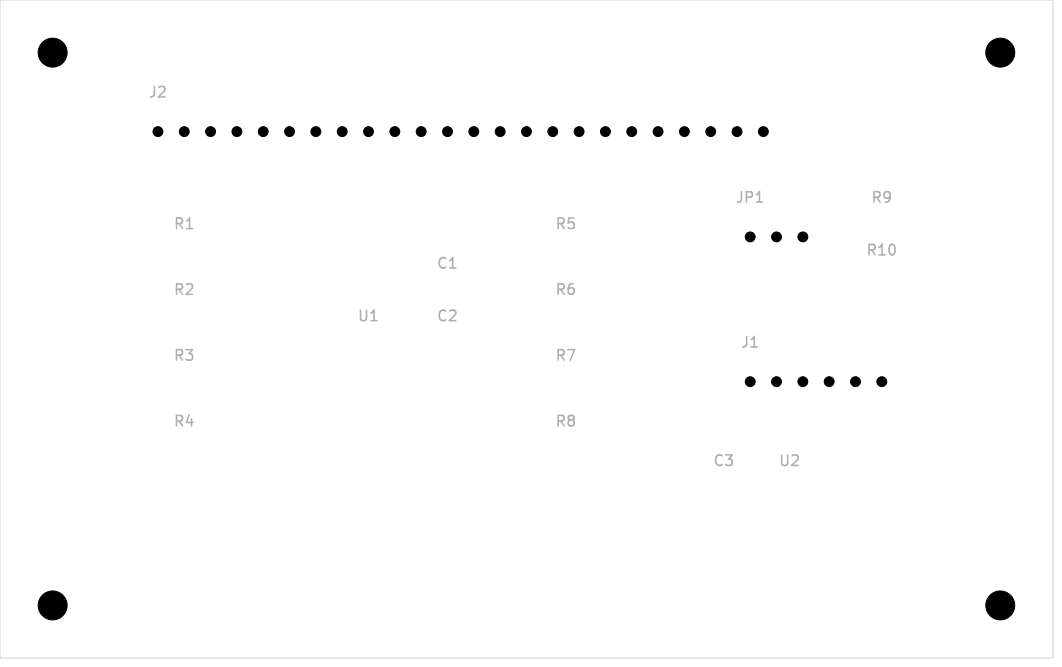
[picture p73: page 1]
