Eljah/qulay/electronics/generated-r2/adc/adc-schematic.pdf

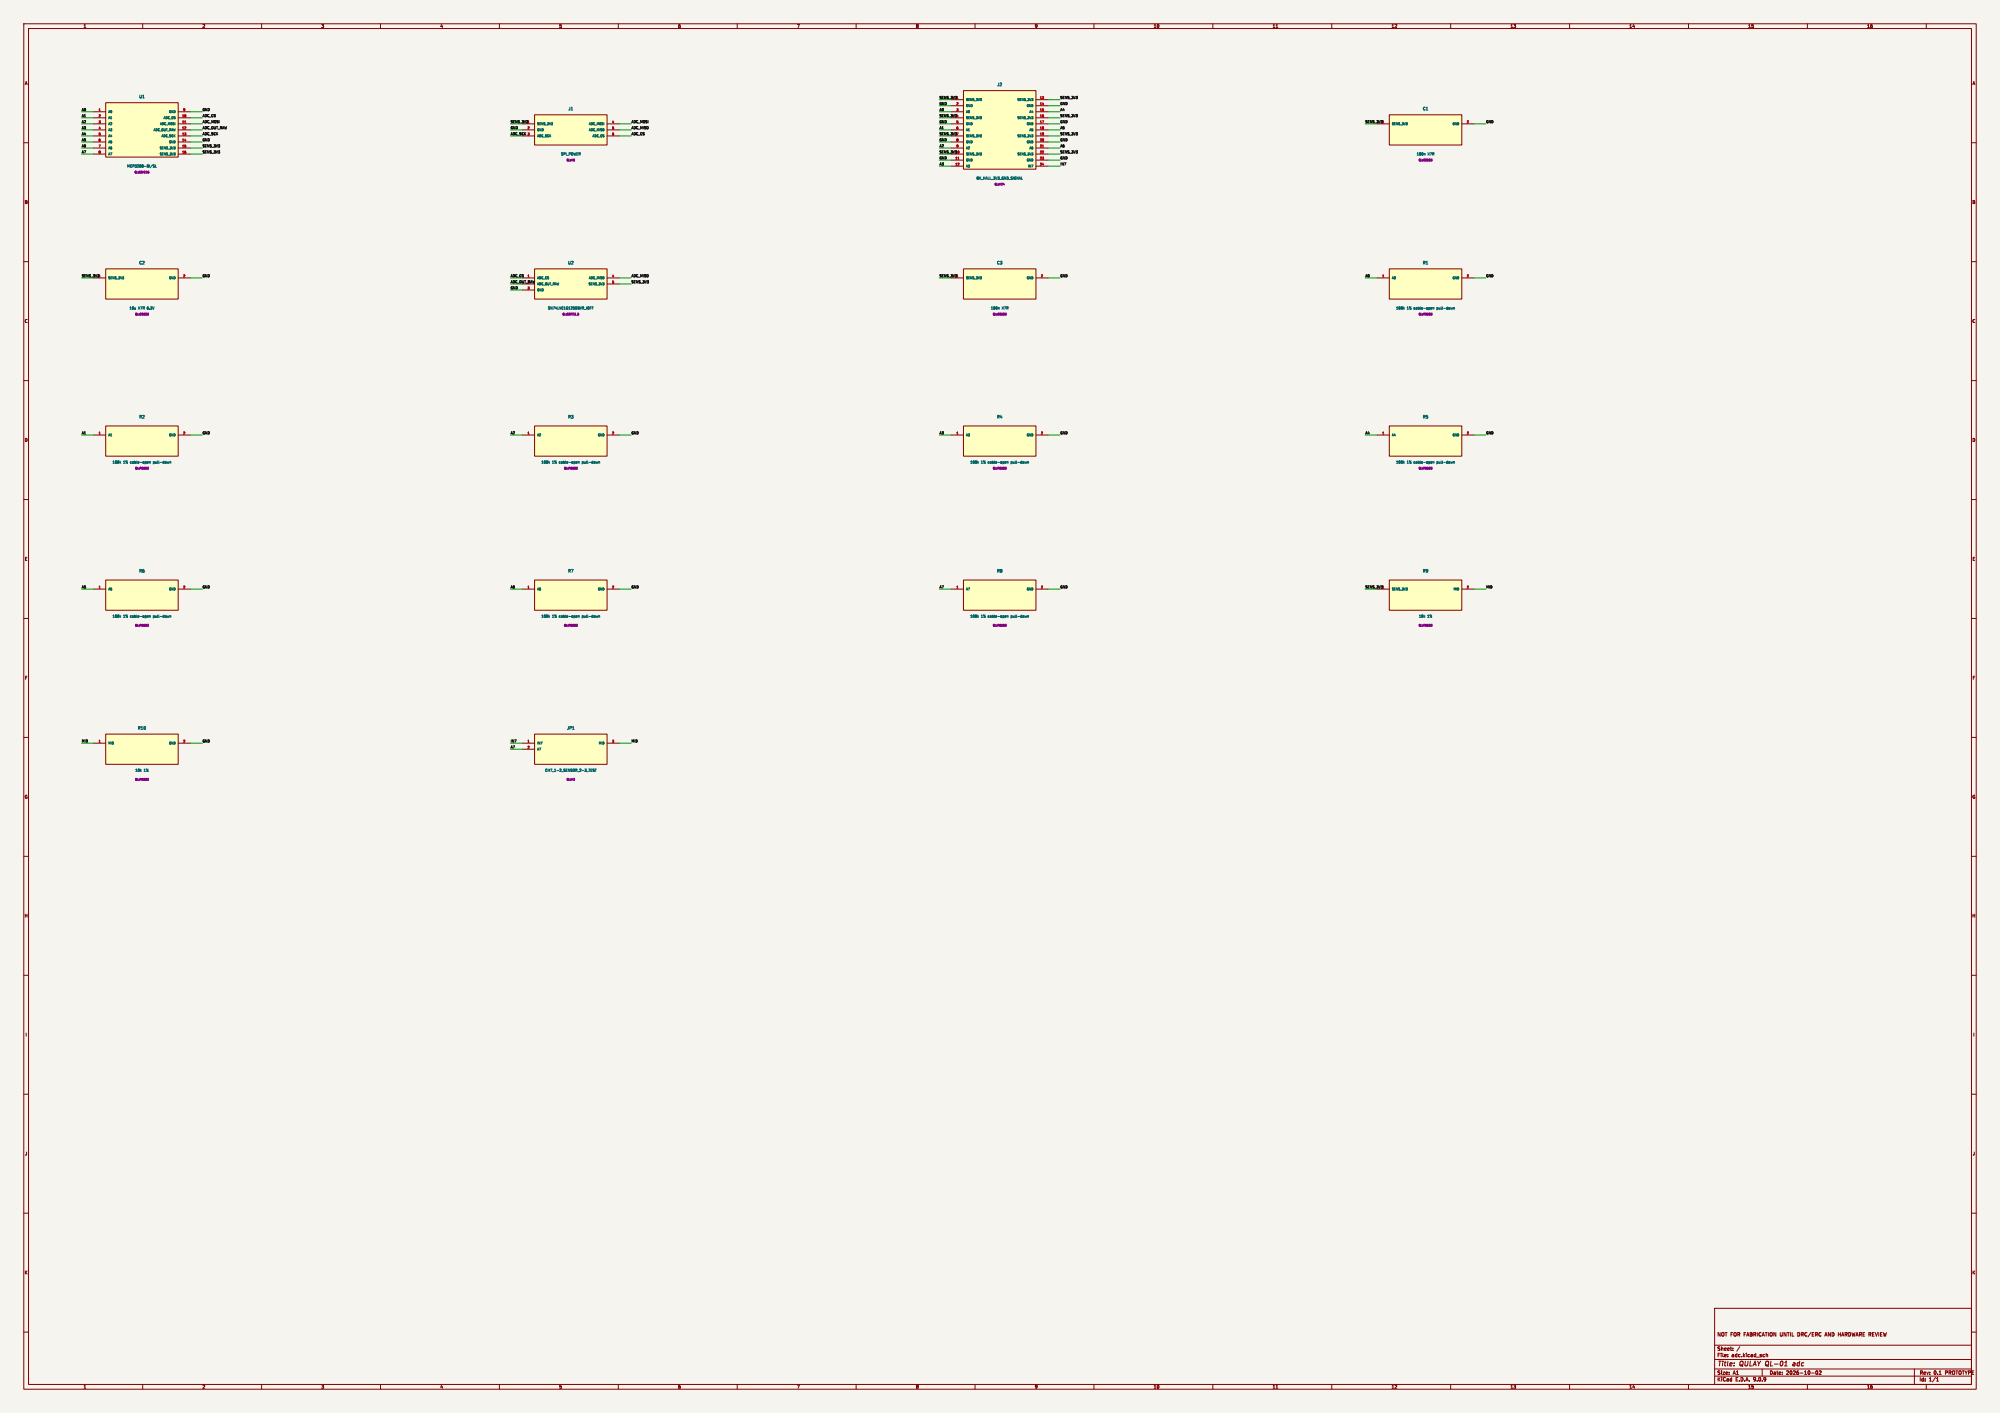
[picture p74: page 1]
