Eljah/qulay/electronics/generated-r2/carrier_r2/carrier_r2-assembly.pdf

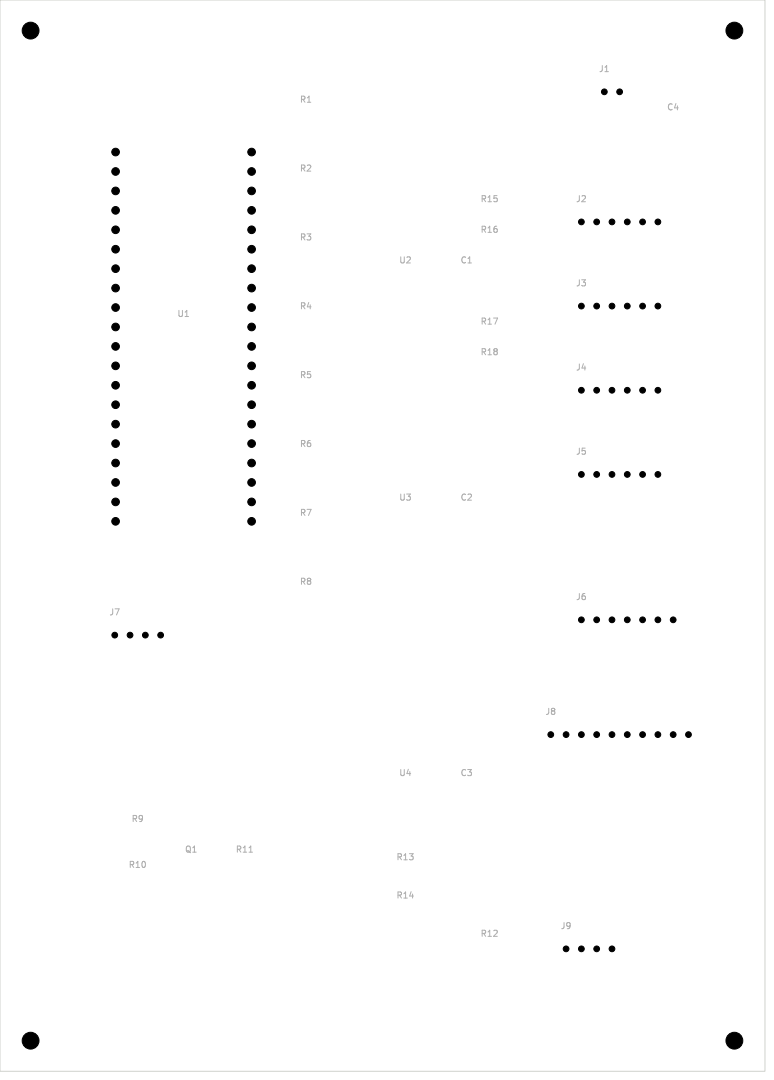
[picture p75: page 1]
