Eljah/qulay/electronics/generated-r2/carrier_r2/carrier_r2-schematic.pdf

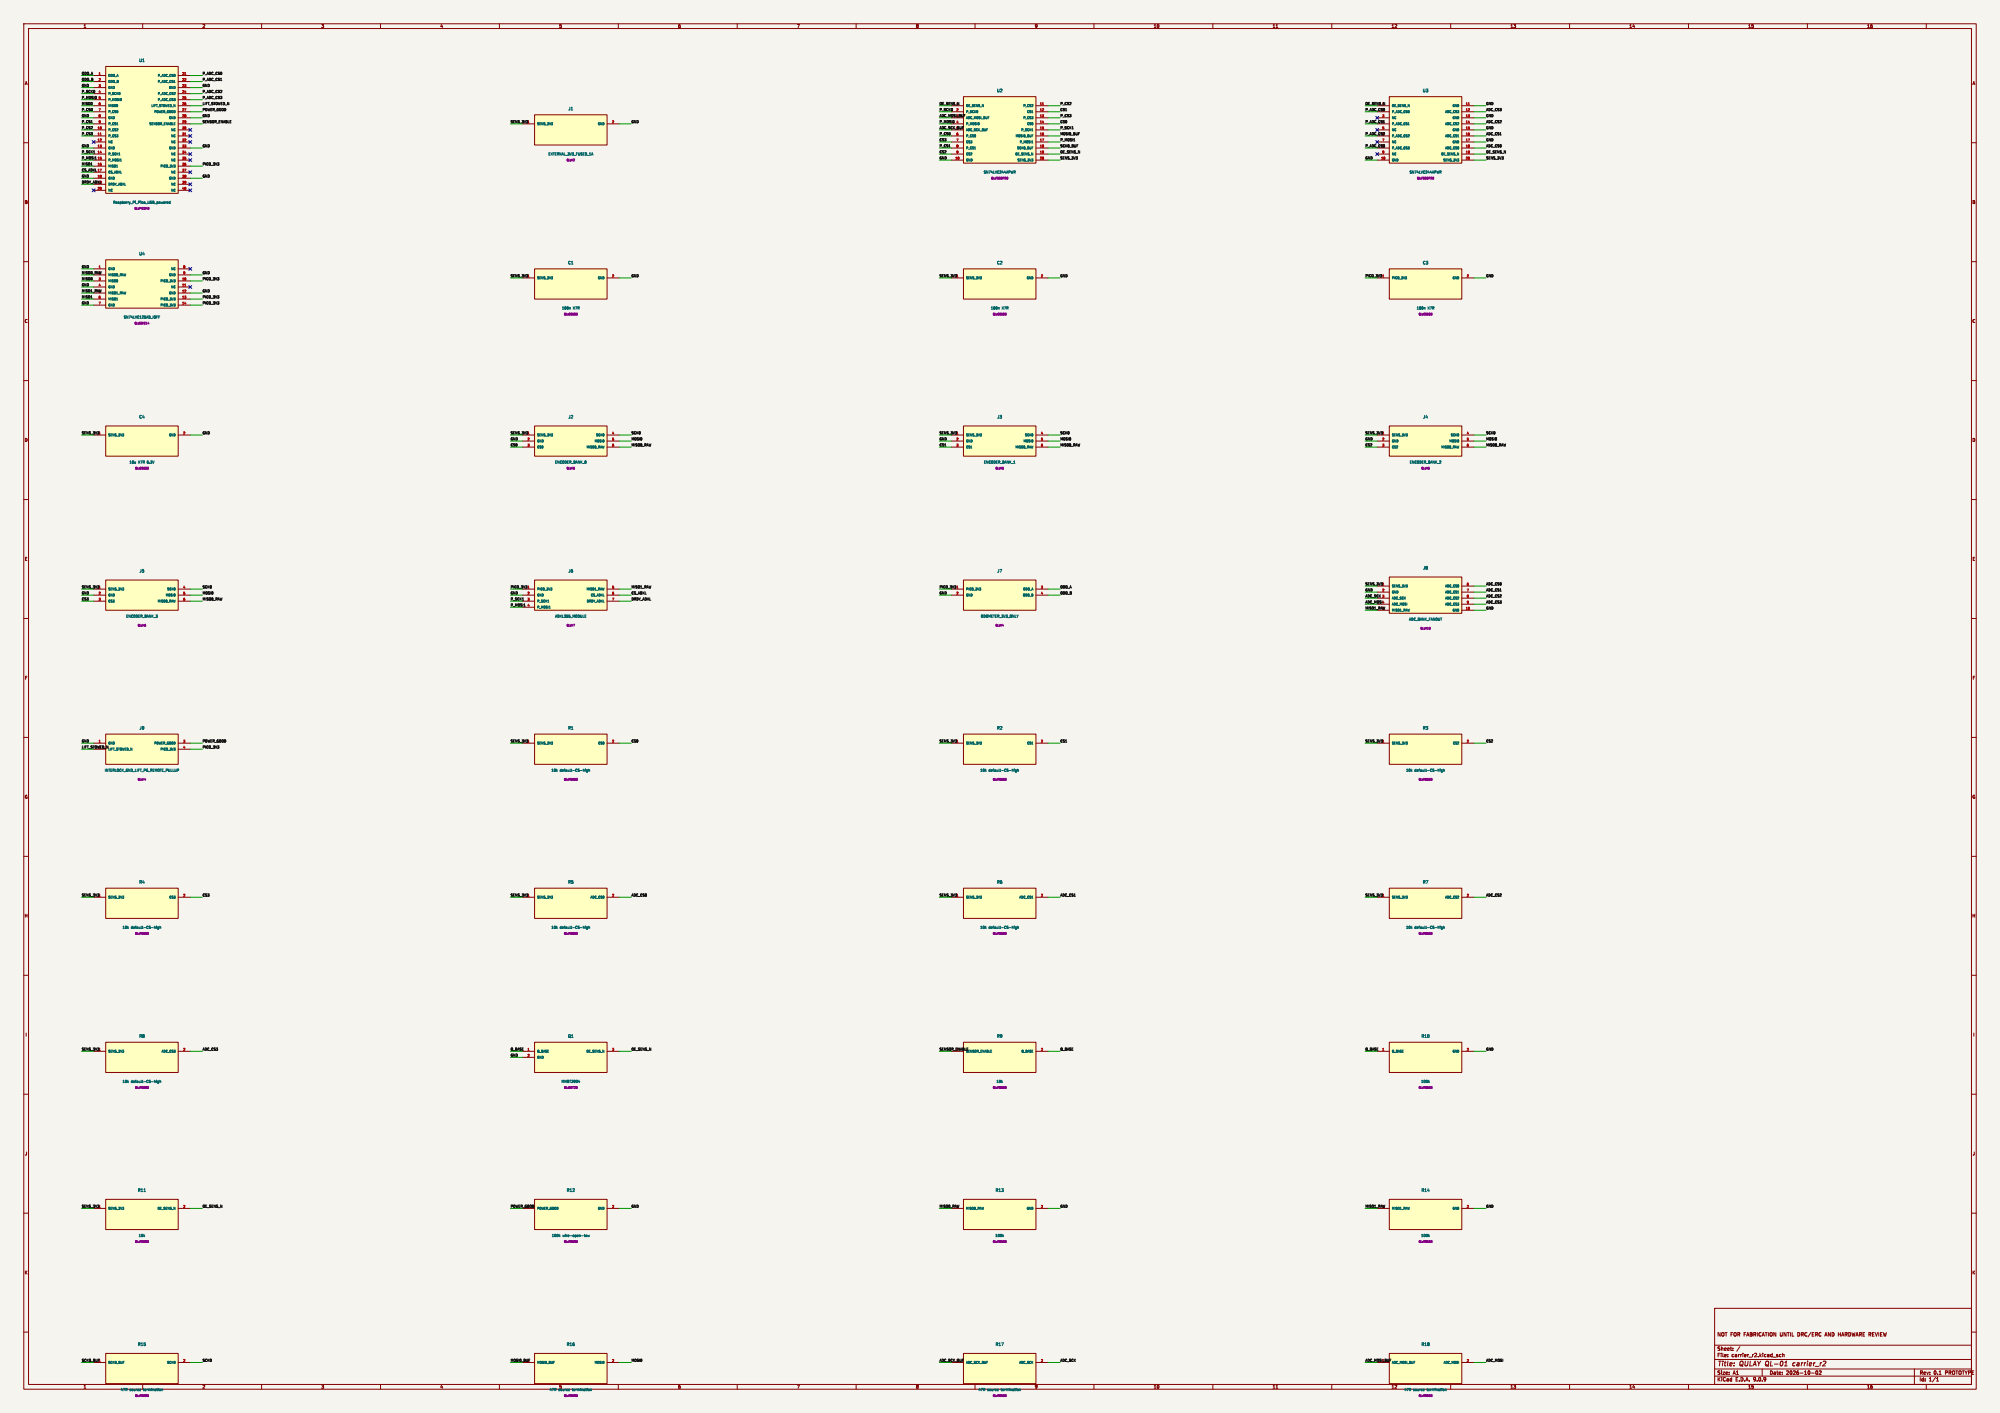
[picture p76: page 1]

10k default-CS-high QL:R0603

10k default-CS-high QL:R0603 Q_BASE
