Eljah/qulay/electronics/generated-r2/force/force-assembly.pdf

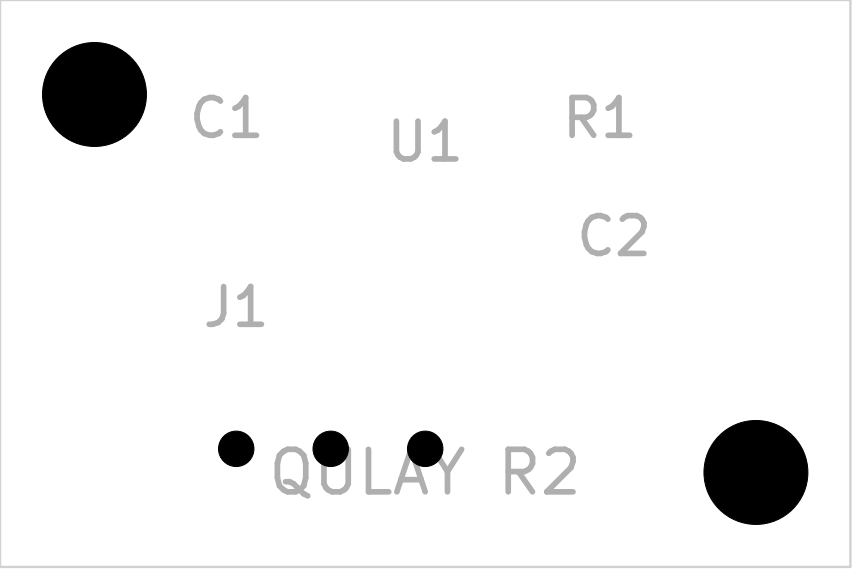
[picture p77: page 1]
