Eljah/qulay/electronics/generated-r2/force/force-schematic.pdf

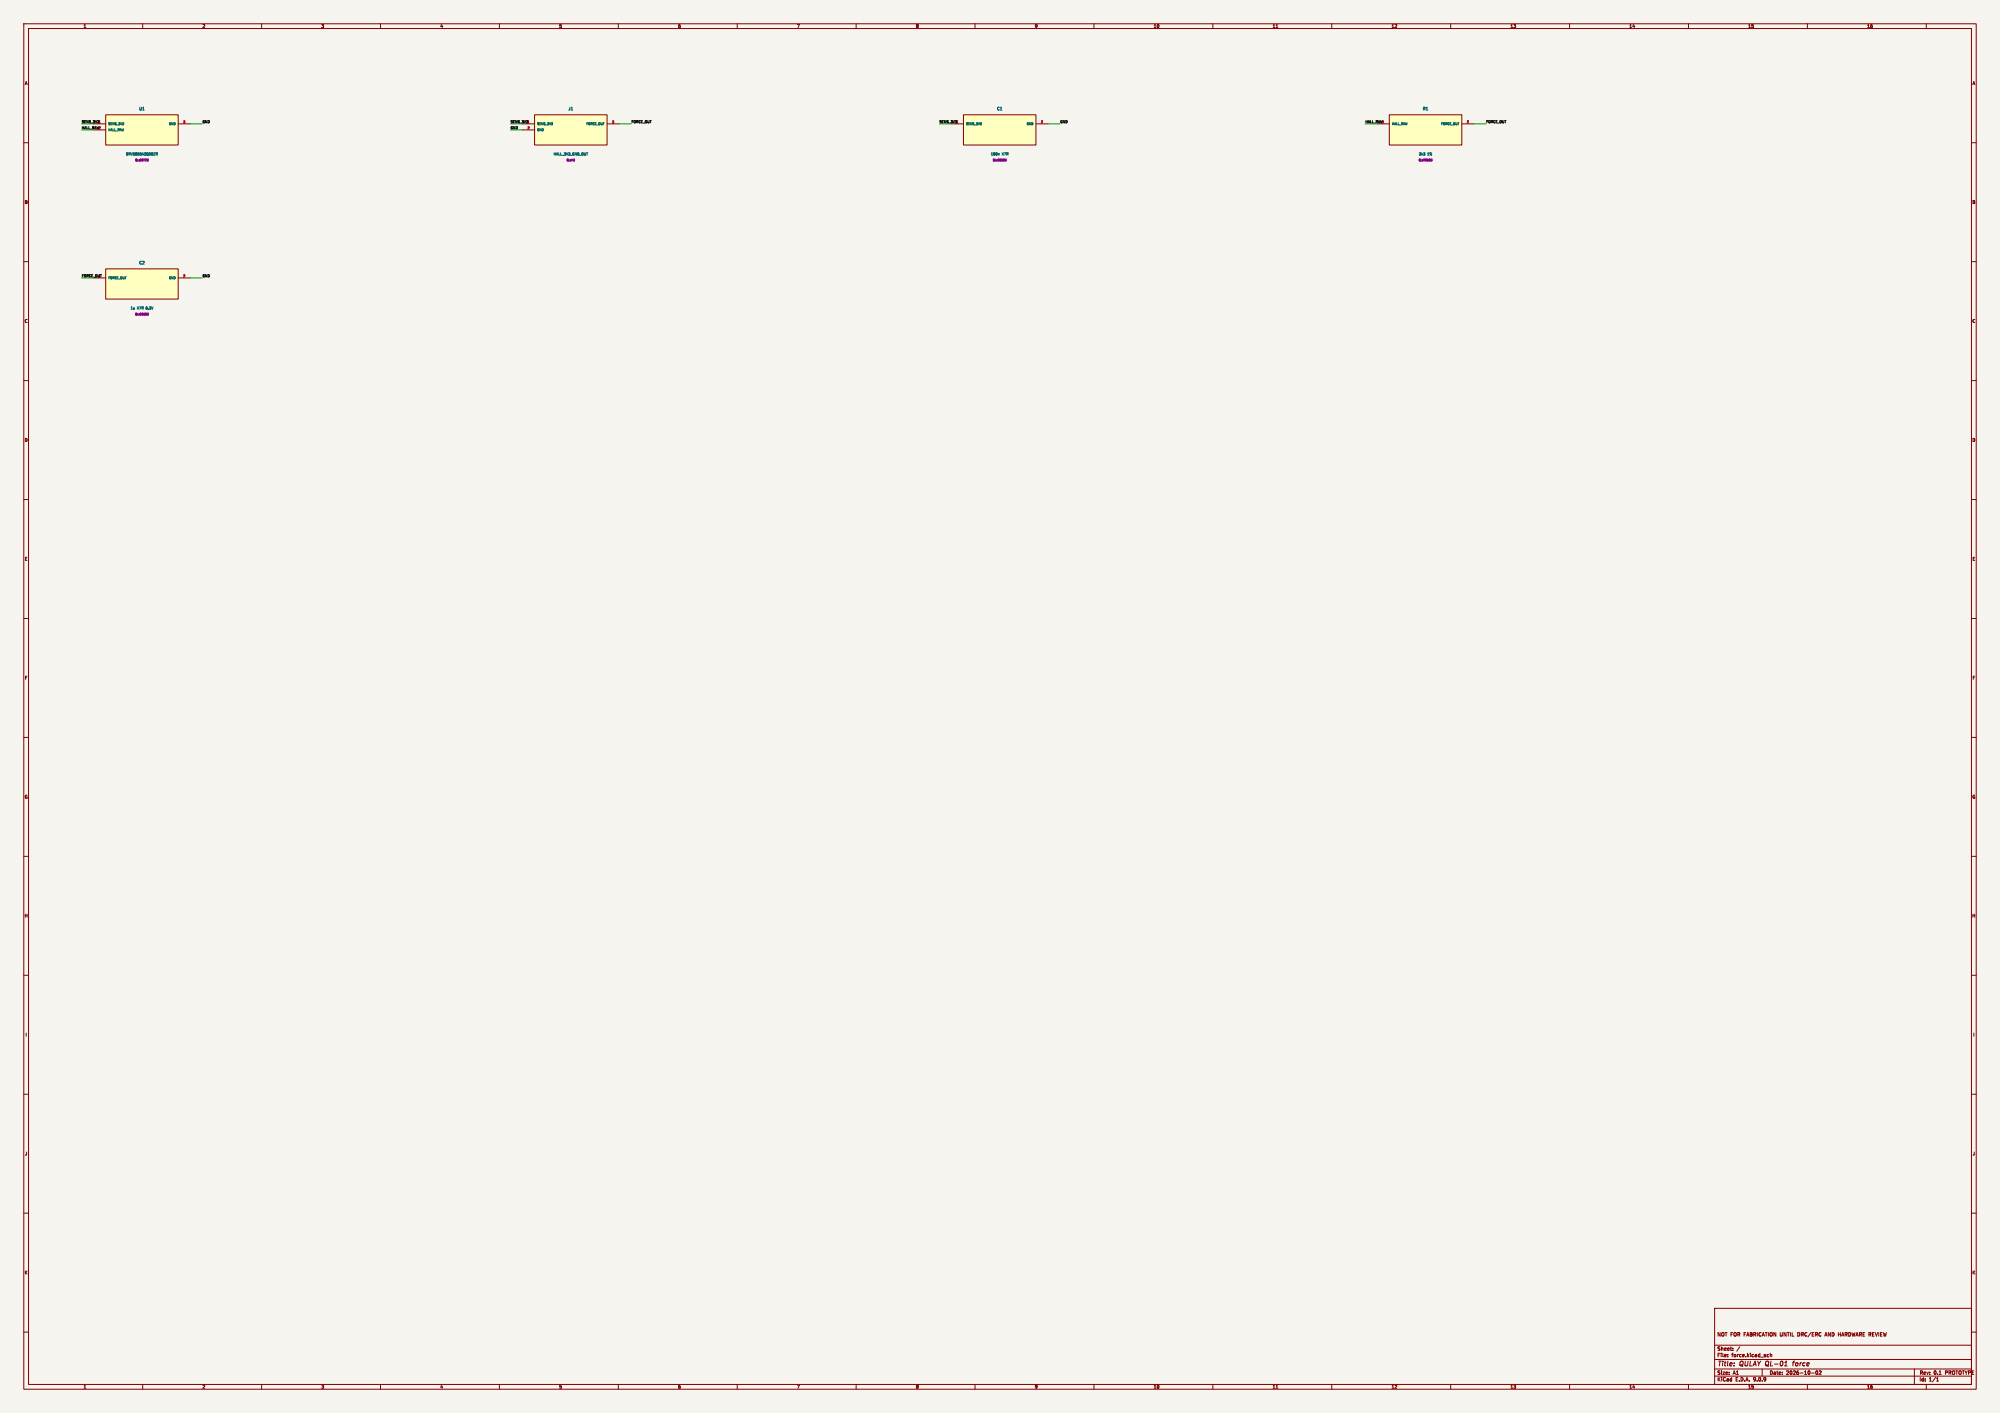
[picture p78: page 1]
