Eljah/qulay/electronics/generated-r2/power_good/power_good-assembly.pdf

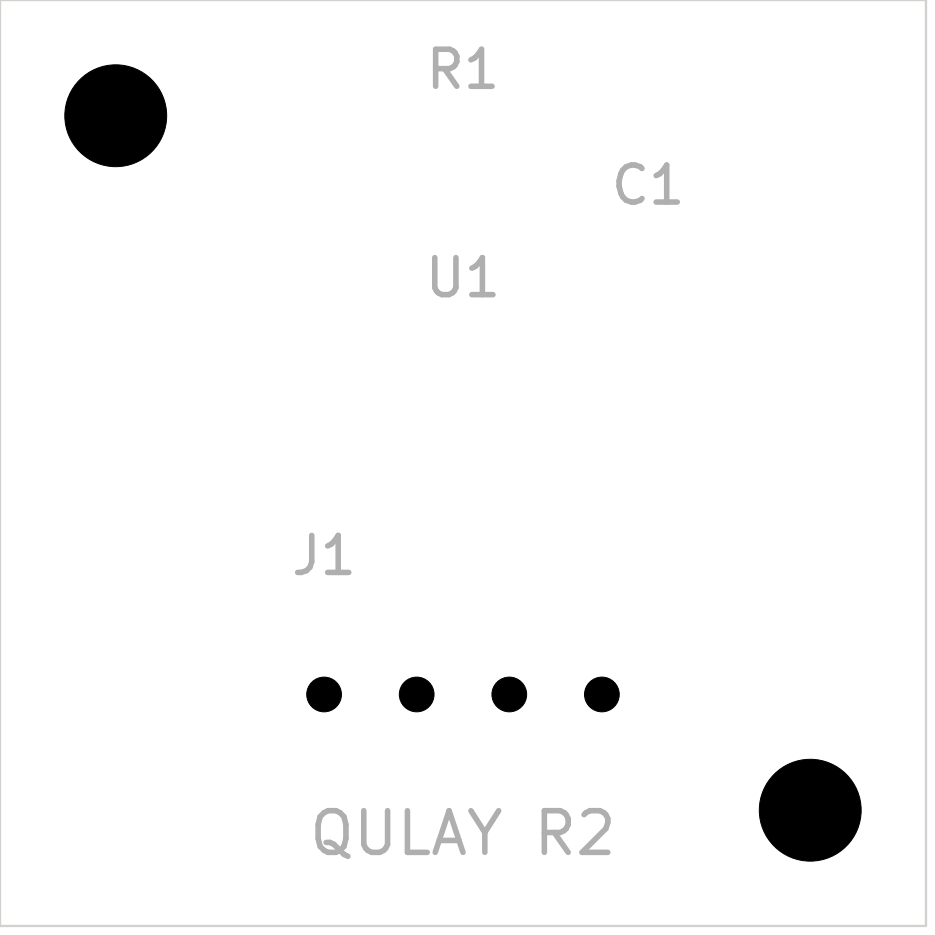
[picture p79: page 1]
