Eljah/qulay/electronics/generated-r2/power_good/power_good-schematic.pdf

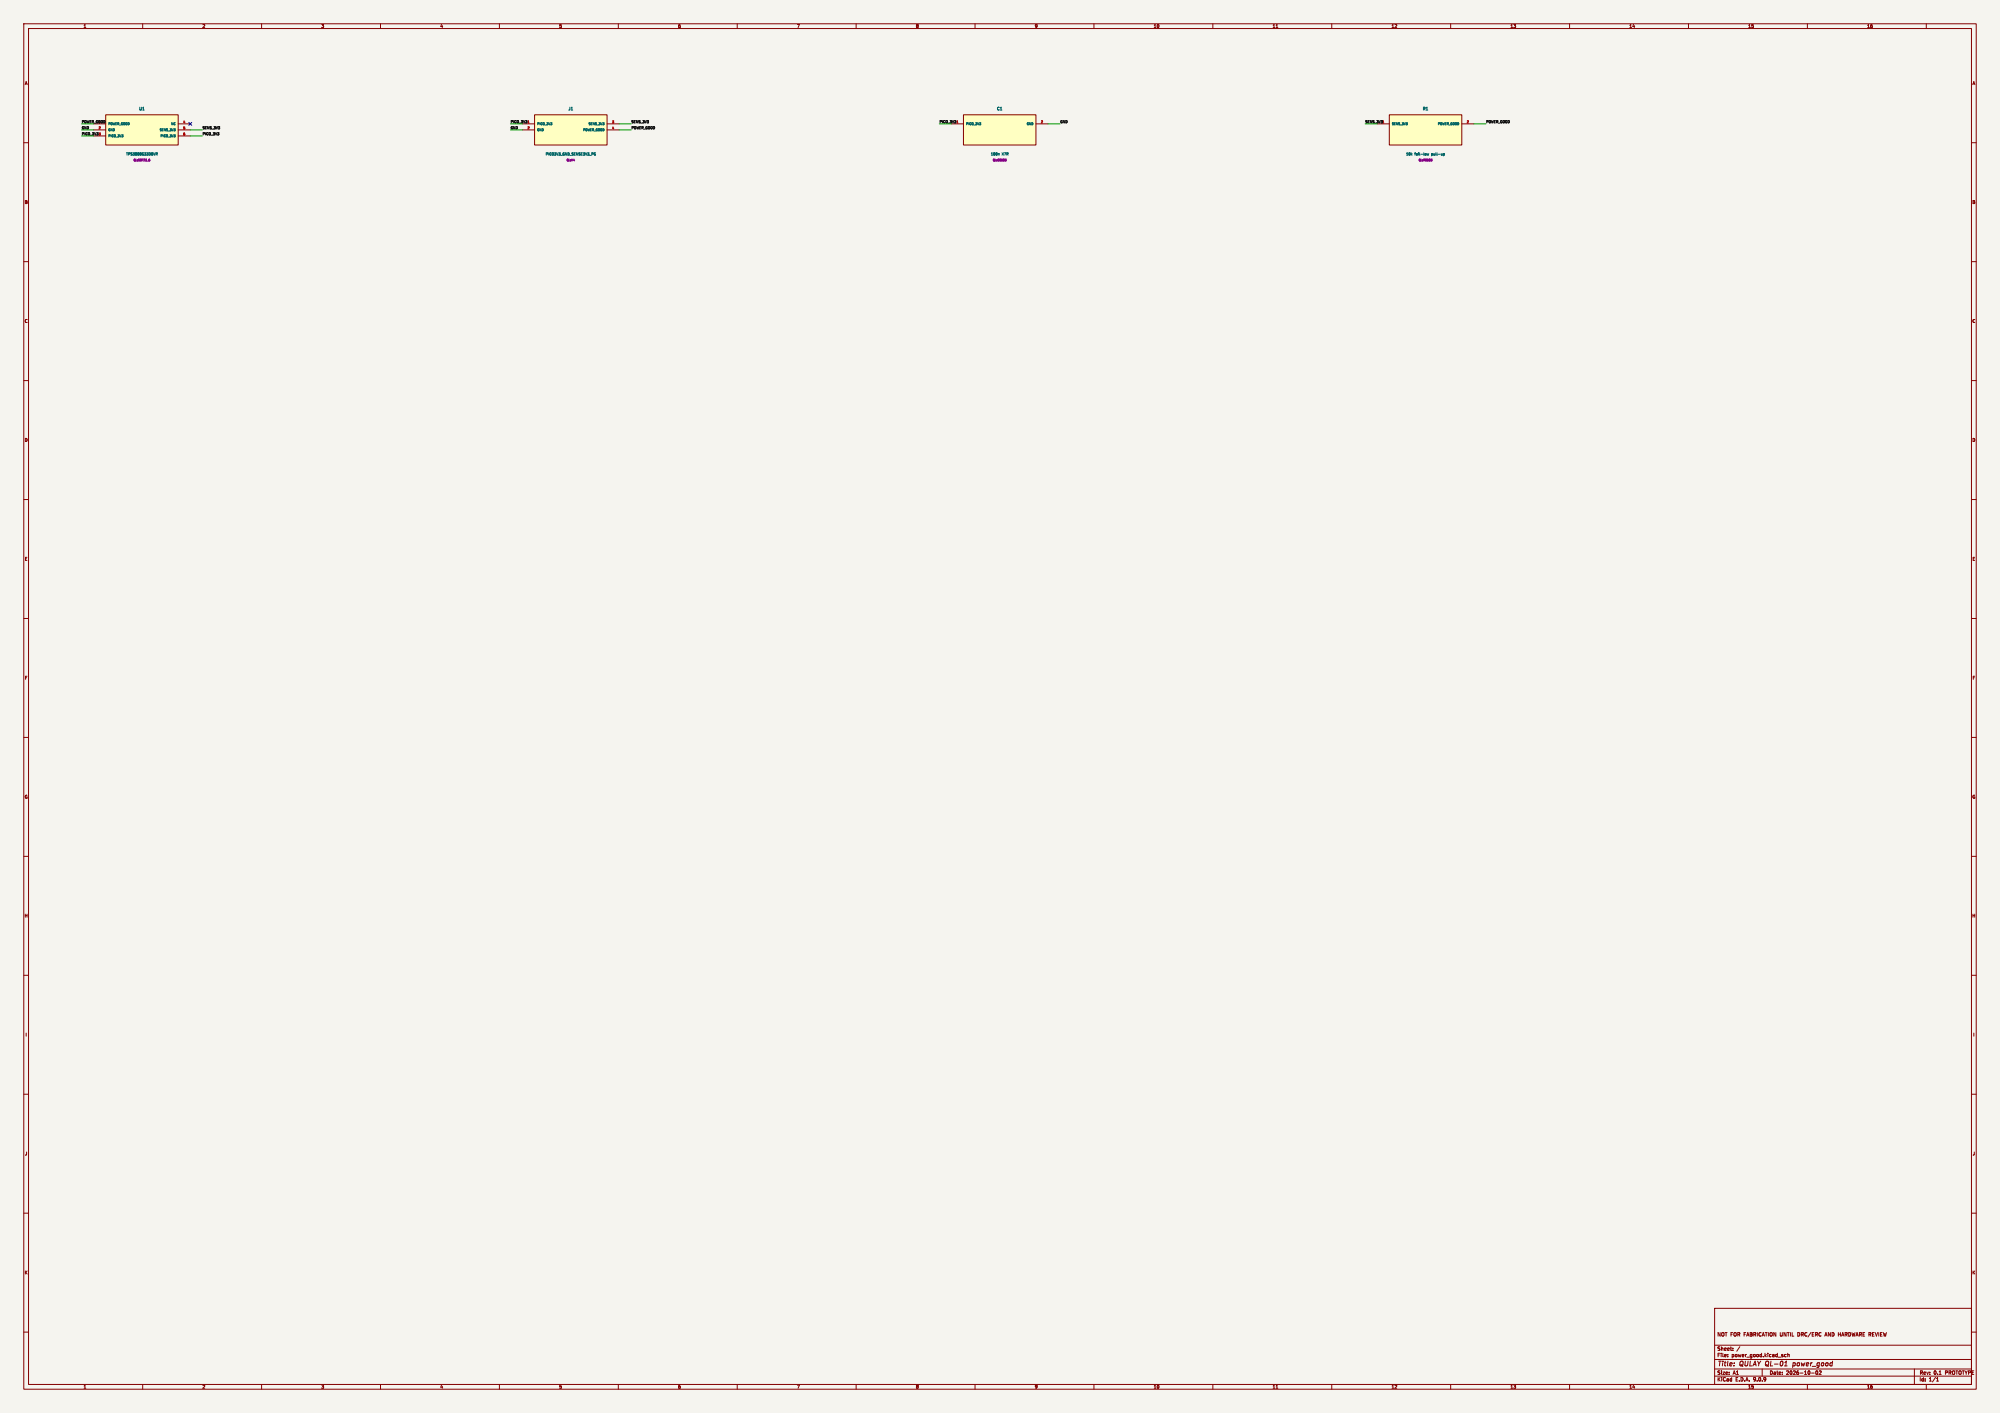
[picture p80: page 1]
