Eljah/qulay/electronics/generated/carrier/carrier-schematic.pdf

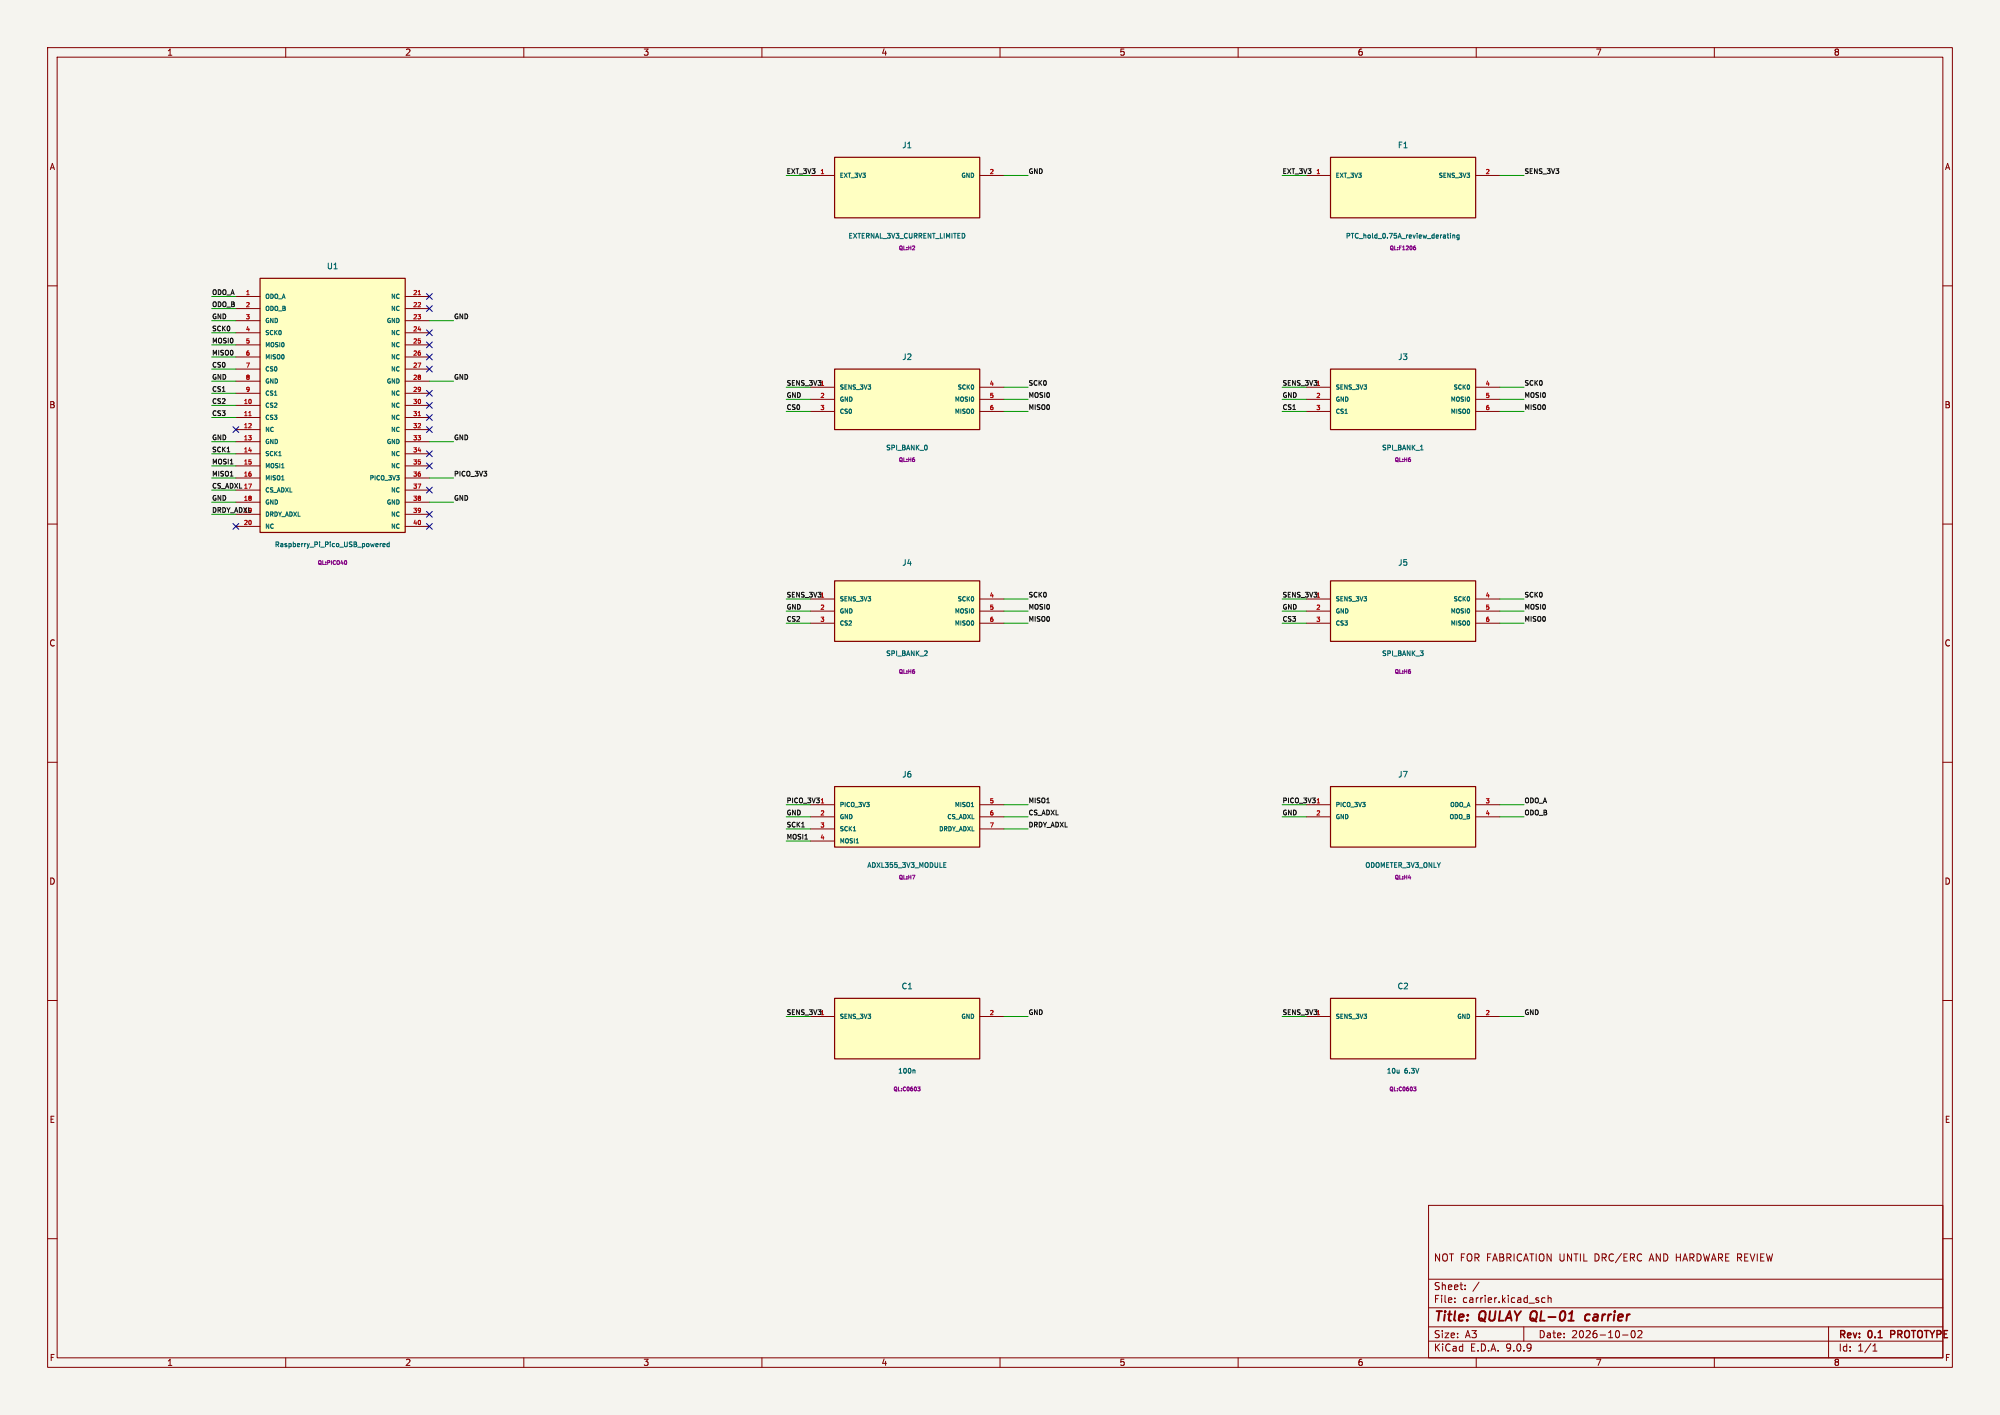
[picture p81: page 1]
