Eljah/qulay/electronics/generated/encoder/encoder-schematic.pdf

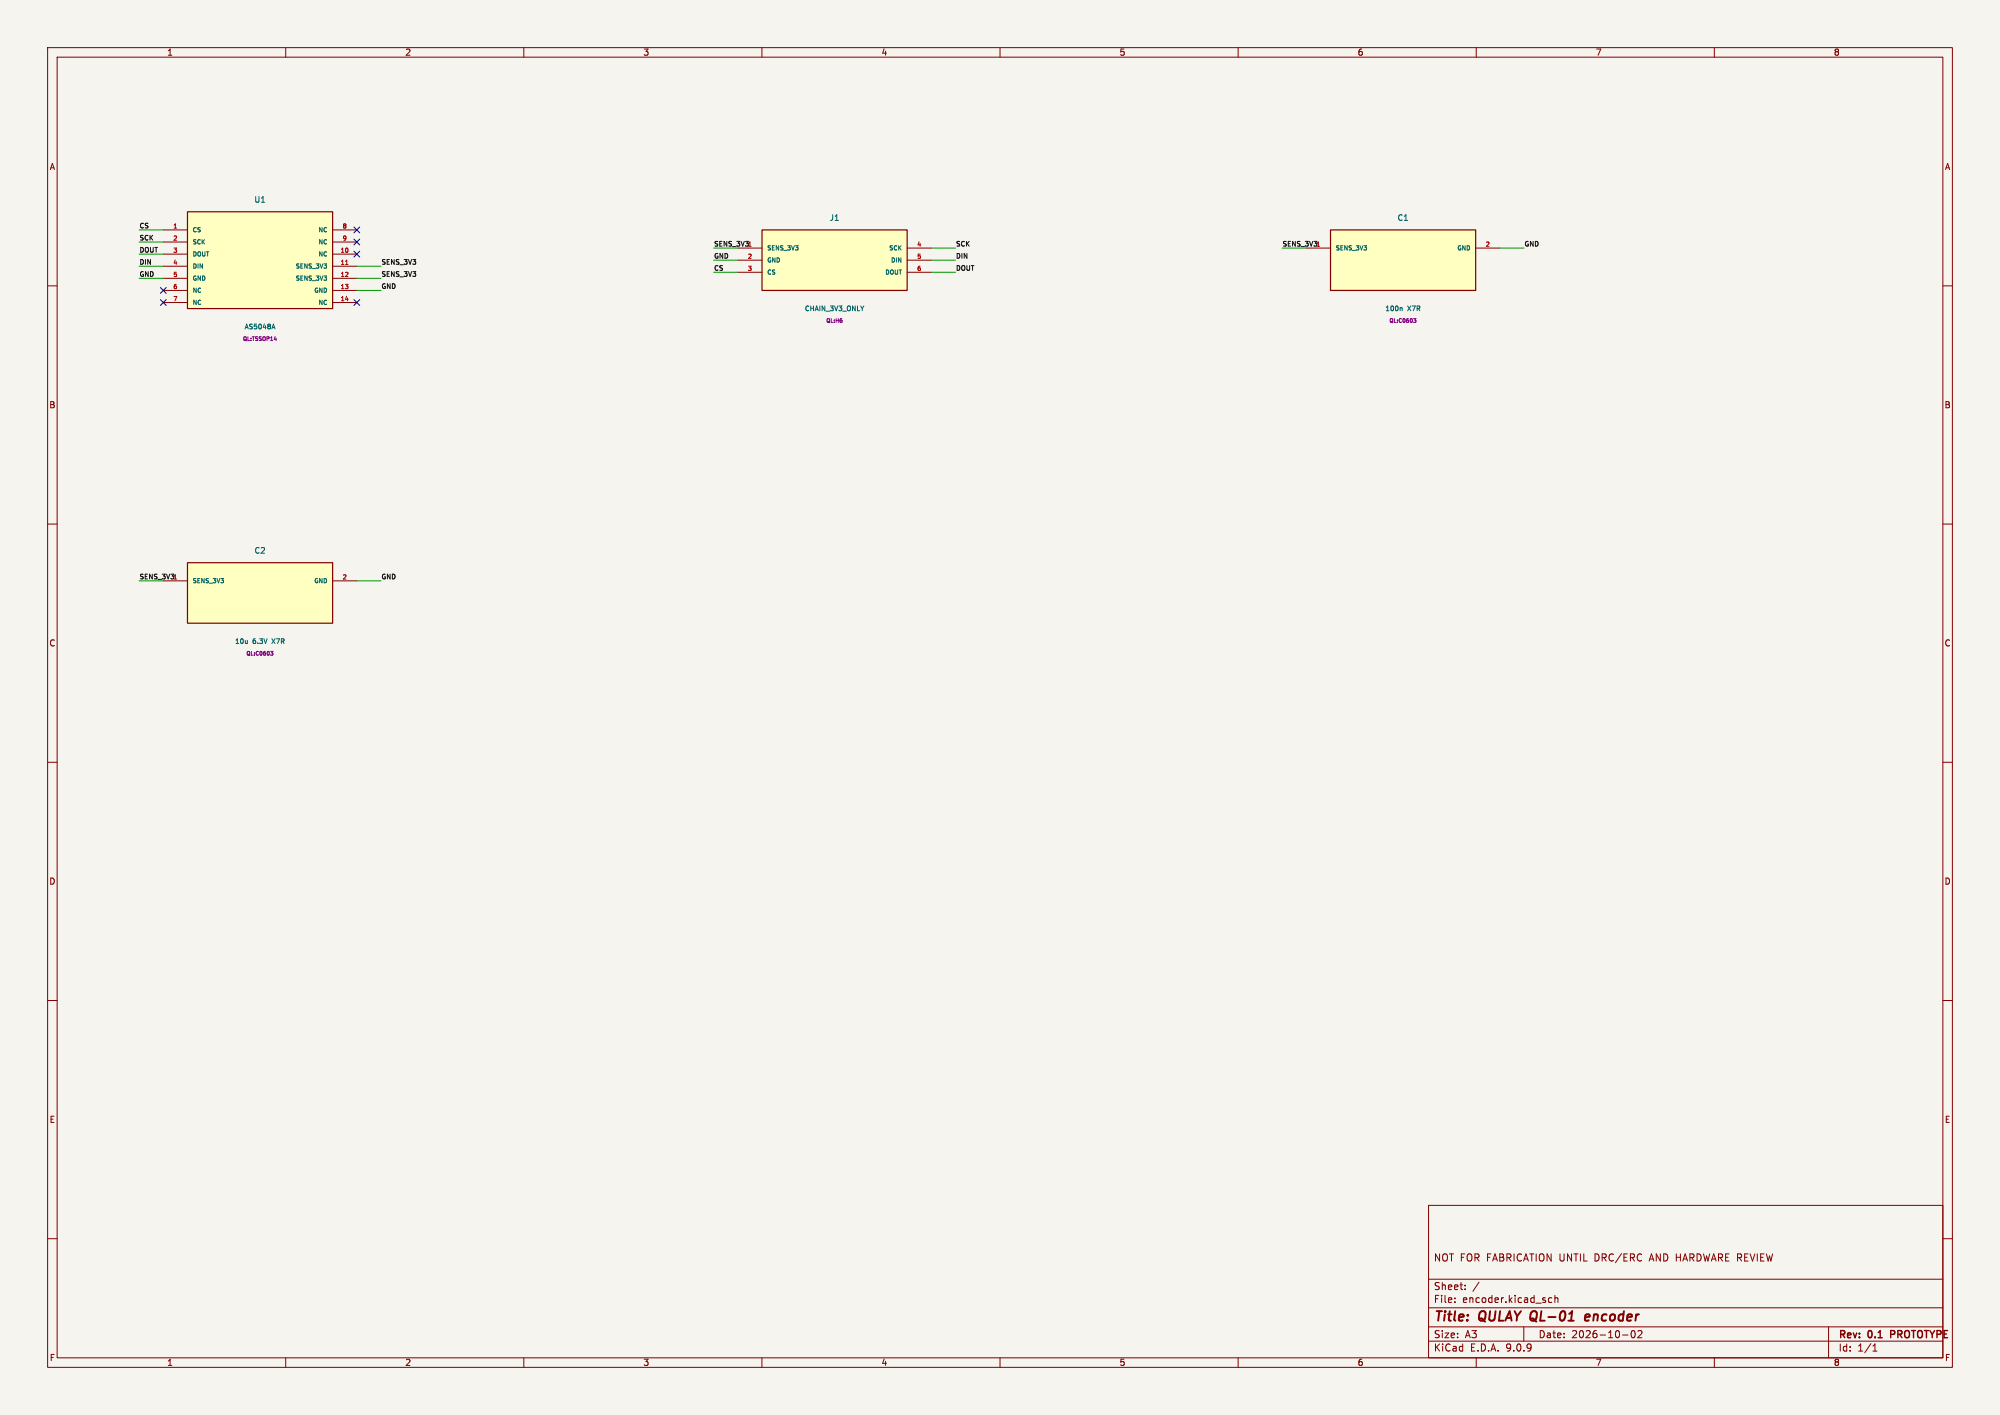
[picture p82: page 1]
