Eljah/qulay/(list of files, drawings)

Other design files:
electronics/generated-r2/adc/adc.dsn
electronics/generated-r2/carrier_r2/carrier_r2.dsn
electronics/generated-r2/force/force.dsn
electronics/generated-r2/power_good/power_good.dsn
electronics/generated/carrier/carrier.dsn
electronics/generated/encoder/encoder.dsn
