Eljah/qulay/electronics/generated-r2/force/force.kicad_pcb

## KiCad design electronics/generated-r2/force/force.kicad_pcb (2026-10-04)

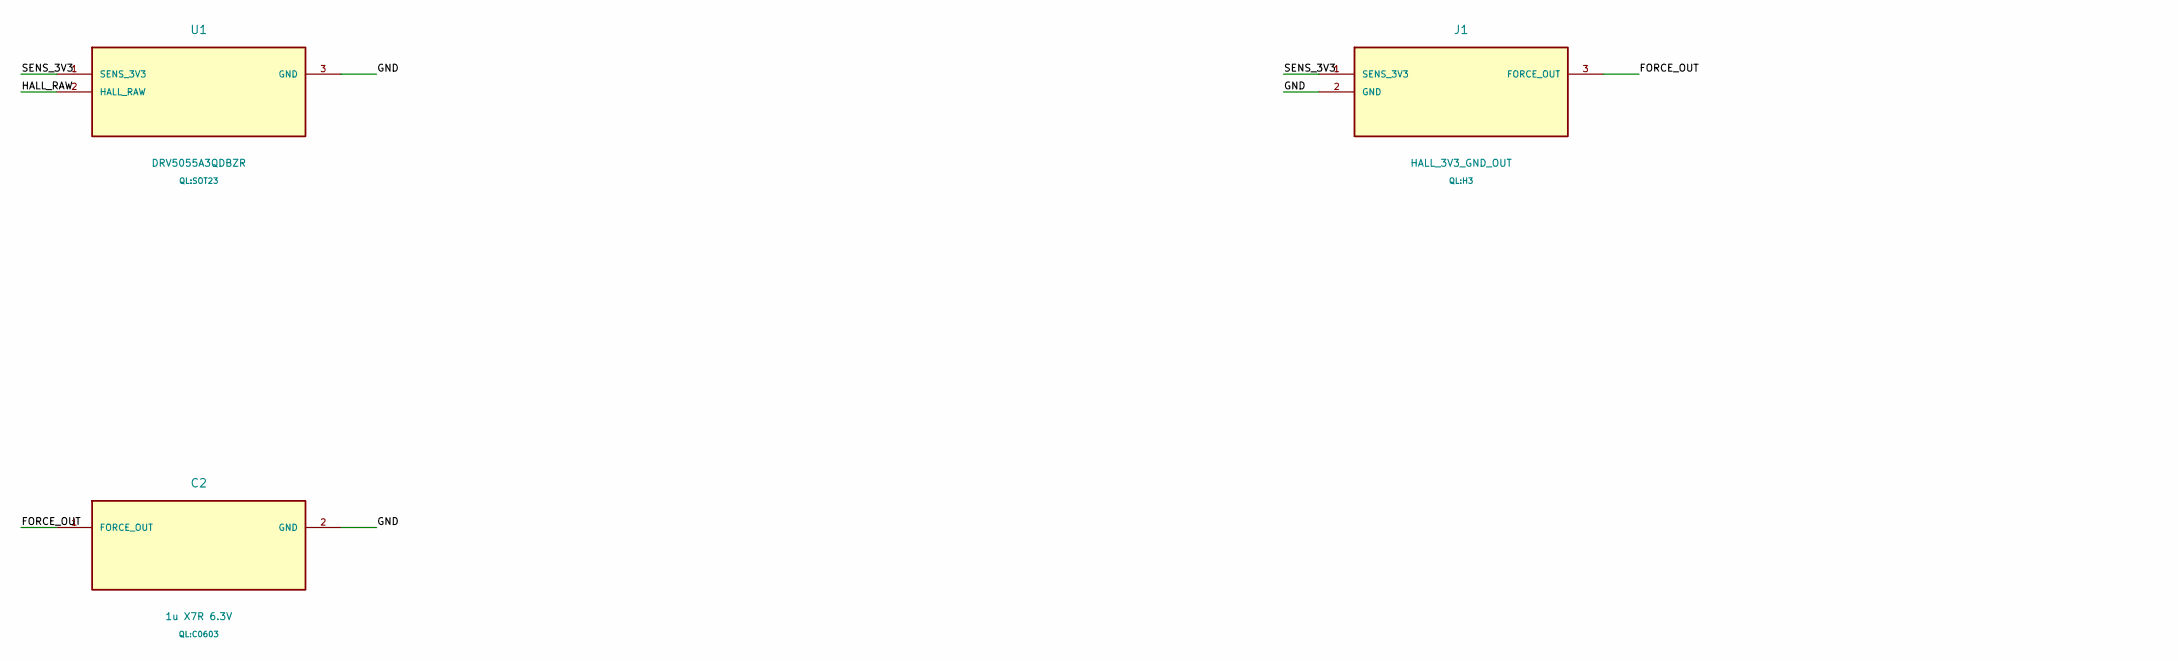
[picture p83: schematic force.kicad_sch, QULAY QL-01 force, part in row 1, column 1]

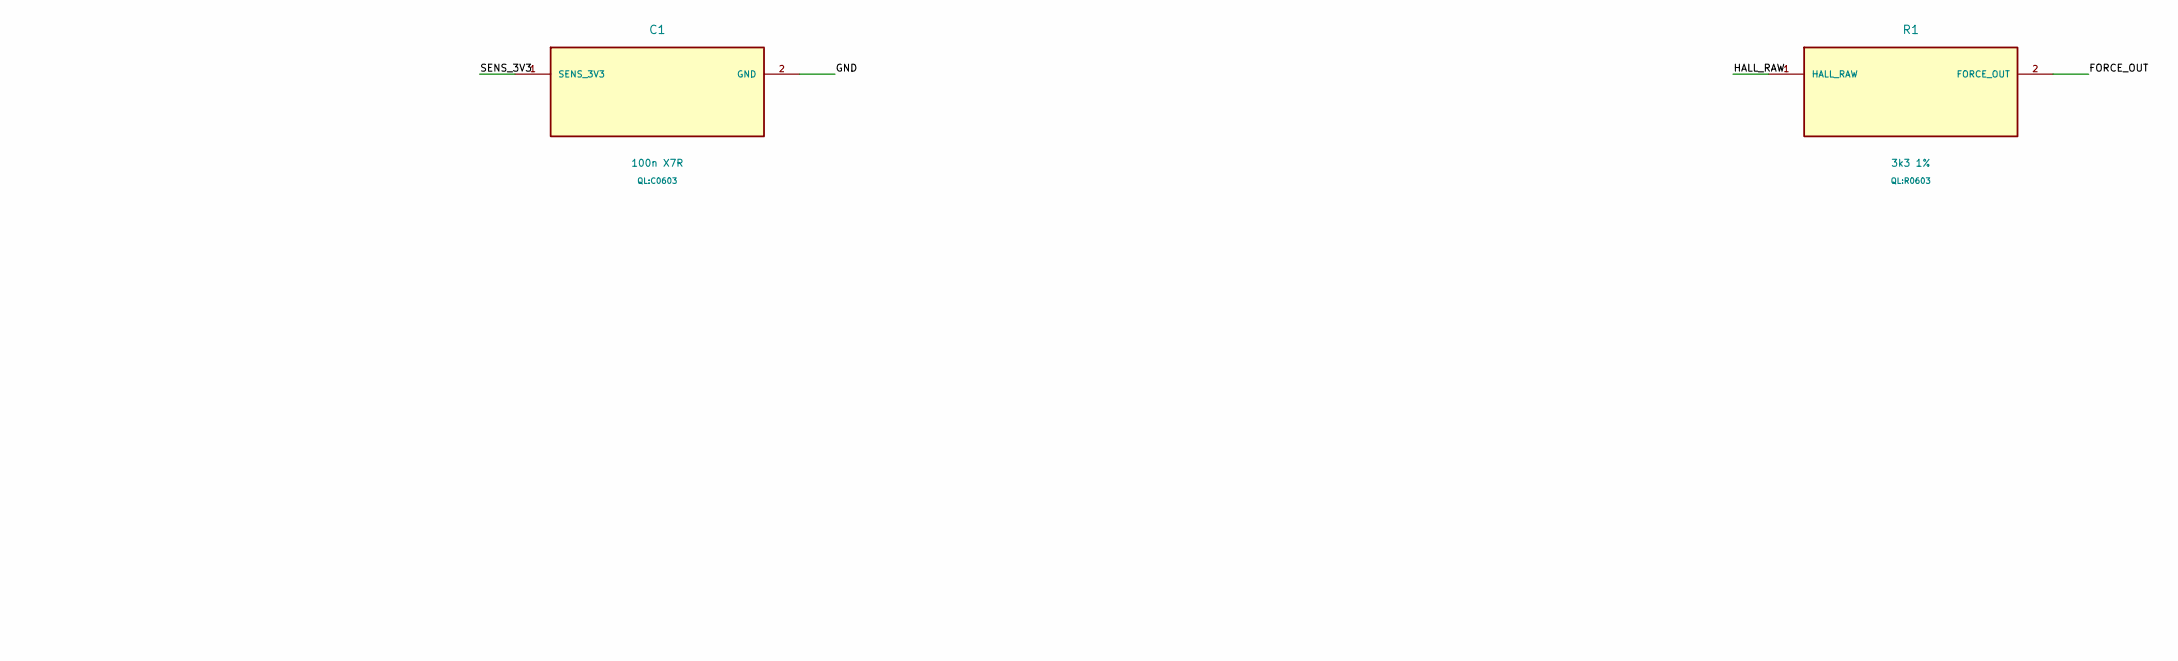
[picture p84: schematic force.kicad_sch, QULAY QL-01 force, part in row 1, column 2]

Parts:
C1: 100n X7R; C0603
C2: 1u X7R 6.3V; C0603
J1: HALL_3V3_GND_OUT; H3
R1: 3k3 1%; R0603
U1: DRV5055A3QDBZR; SOT23

Connections:
FORCE_OUT: C2.1 (FORCE_OUT), J1.3 (FORCE_OUT), R1.2 (FORCE_OUT)
GND: C1.2 (GND), C2.2 (GND), J1.2 (GND), U1.3 (GND)
HALL_RAW: R1.1 (HALL_RAW), U1.2 (HALL_RAW)
SENS_3V3: C1.1 (SENS_3V3), J1.1 (SENS_3V3), U1.1 (SENS_3V3)

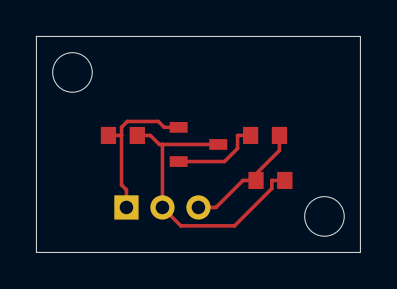
[picture p85: board force.kicad_pcb from above]

Board: 2 copper layers, 18.0 x 12.0 mm, 7 parts (0 on the bottom side), 4 nets.

Other parts of the board:
MH1, MH2: MountingHole_2.2mm
