Eljah/qulay/electronics/generated-r2/adc/adc.kicad_pcb

## KiCad design electronics/generated-r2/adc/adc.kicad_pcb (2026-10-04)

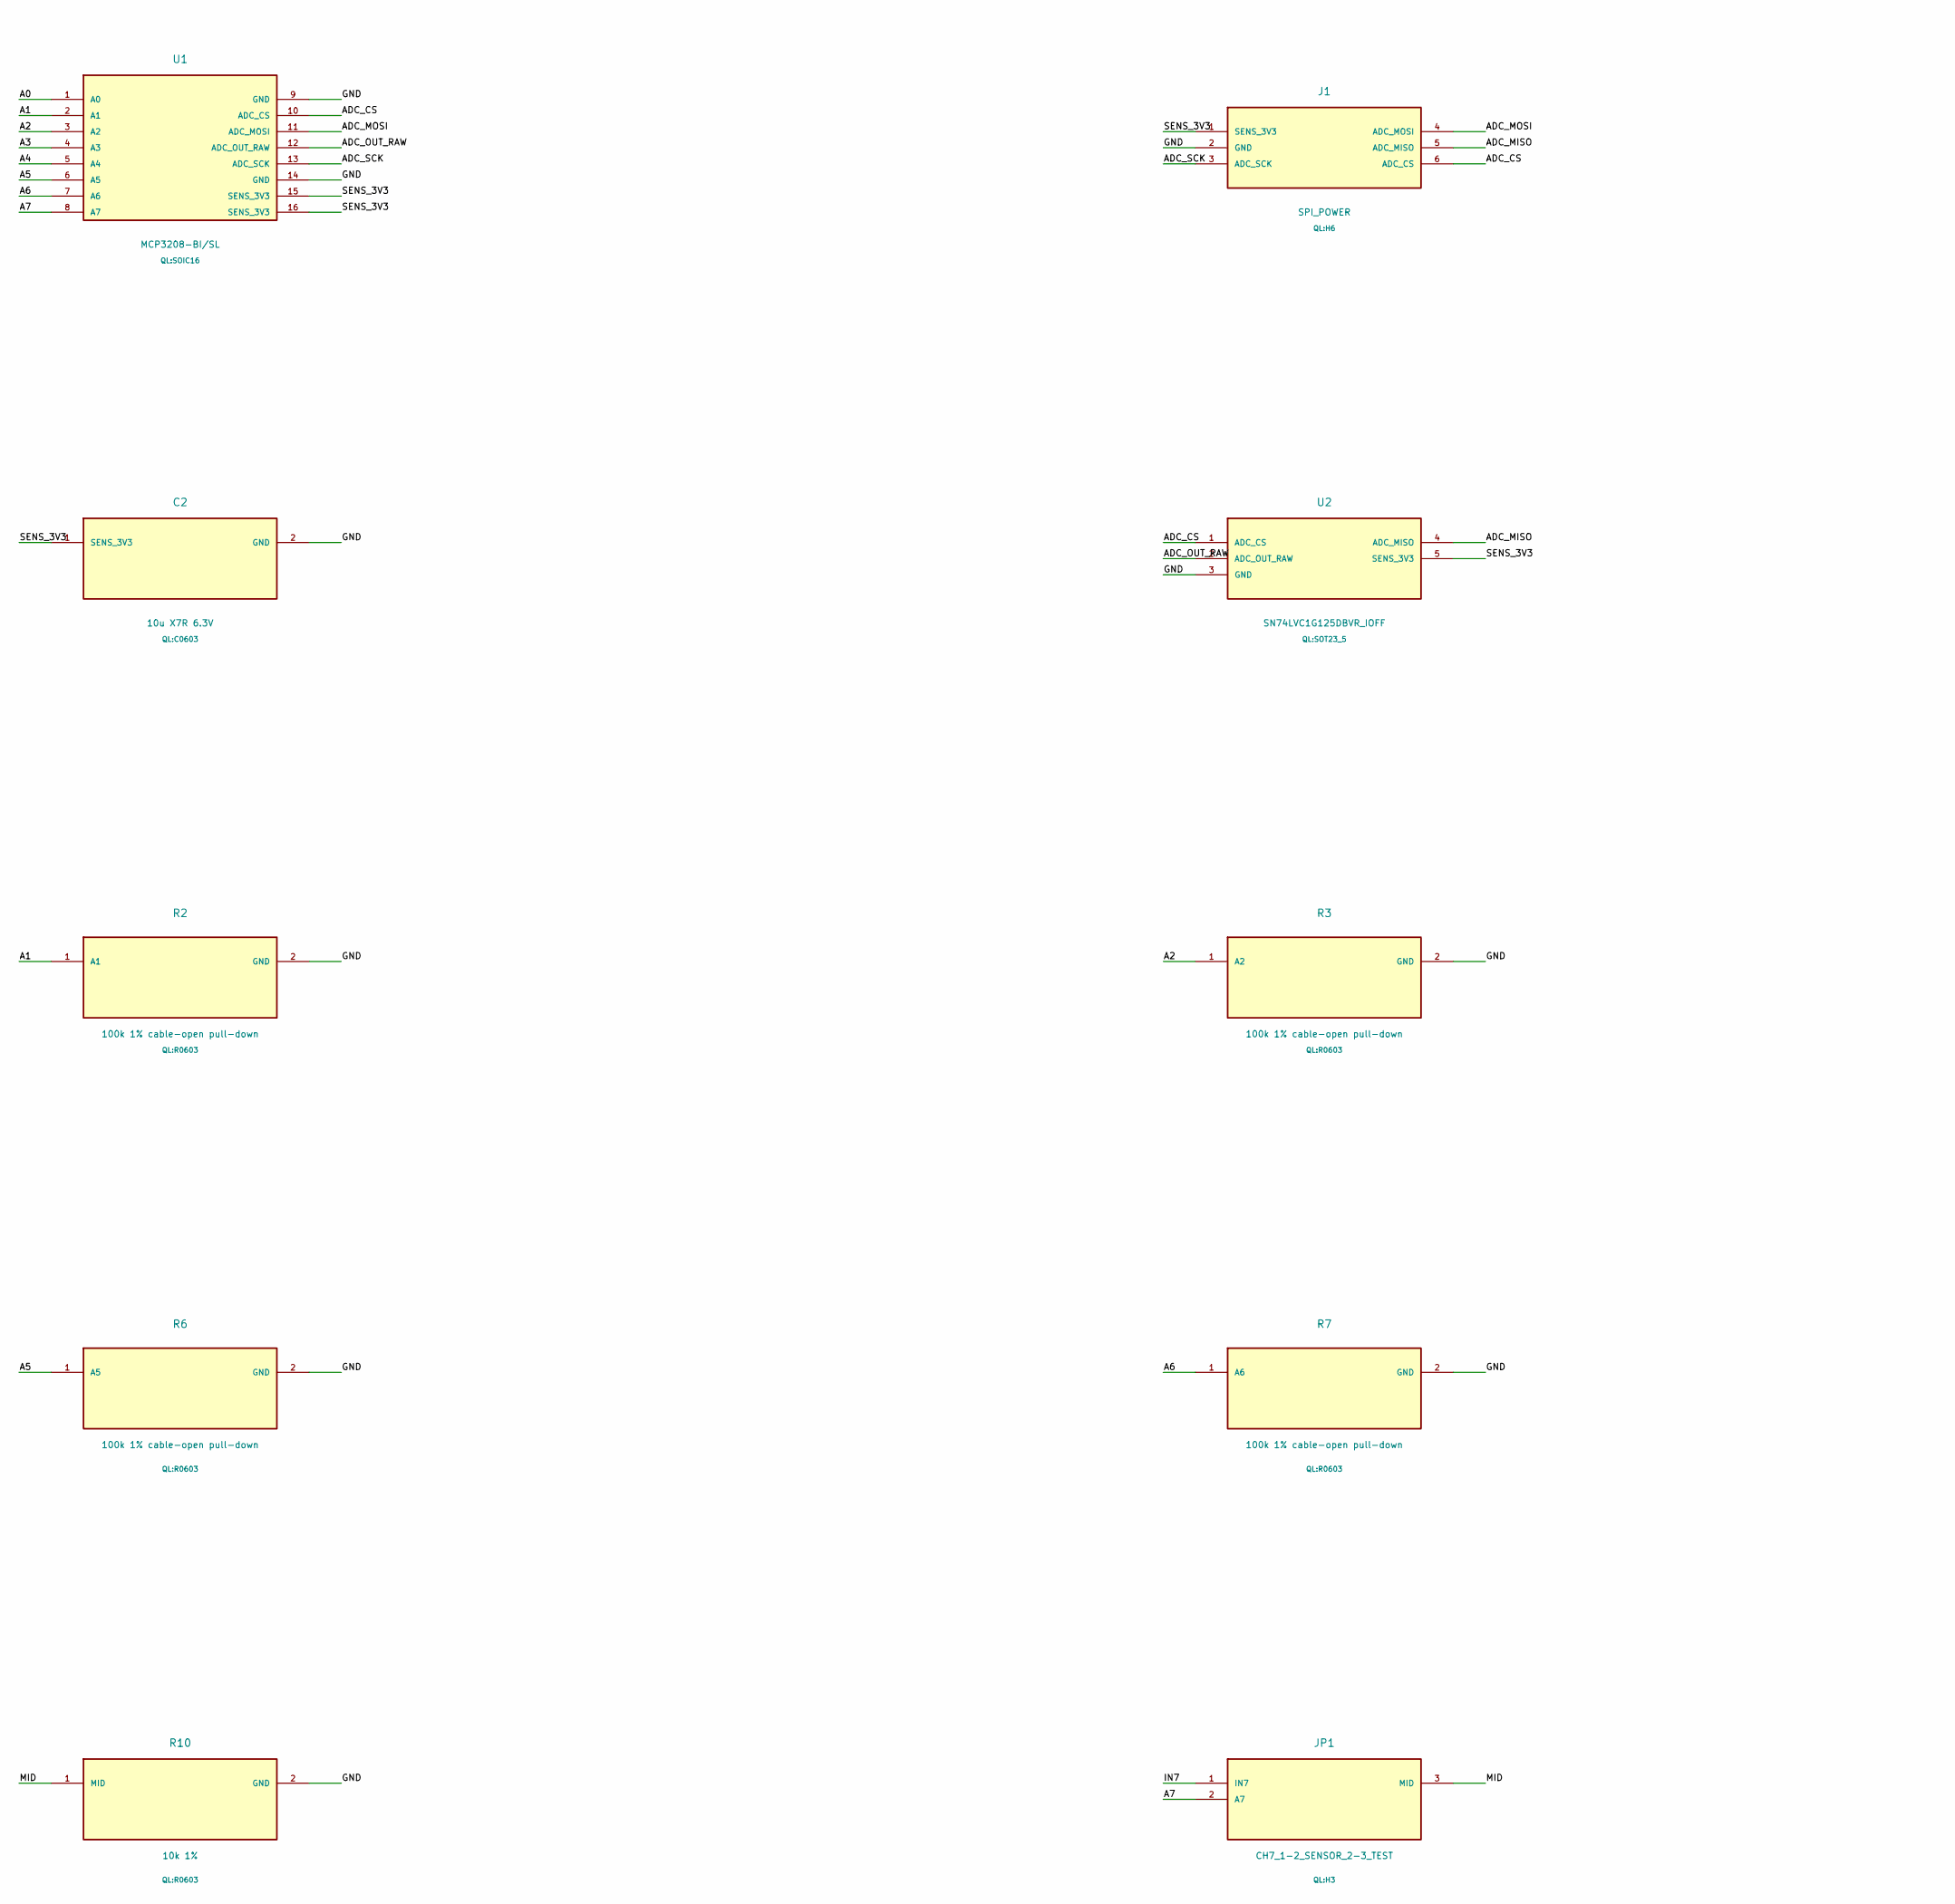
[picture p86: schematic adc.kicad_sch, QULAY QL-01 adc, part in row 1, column 1]

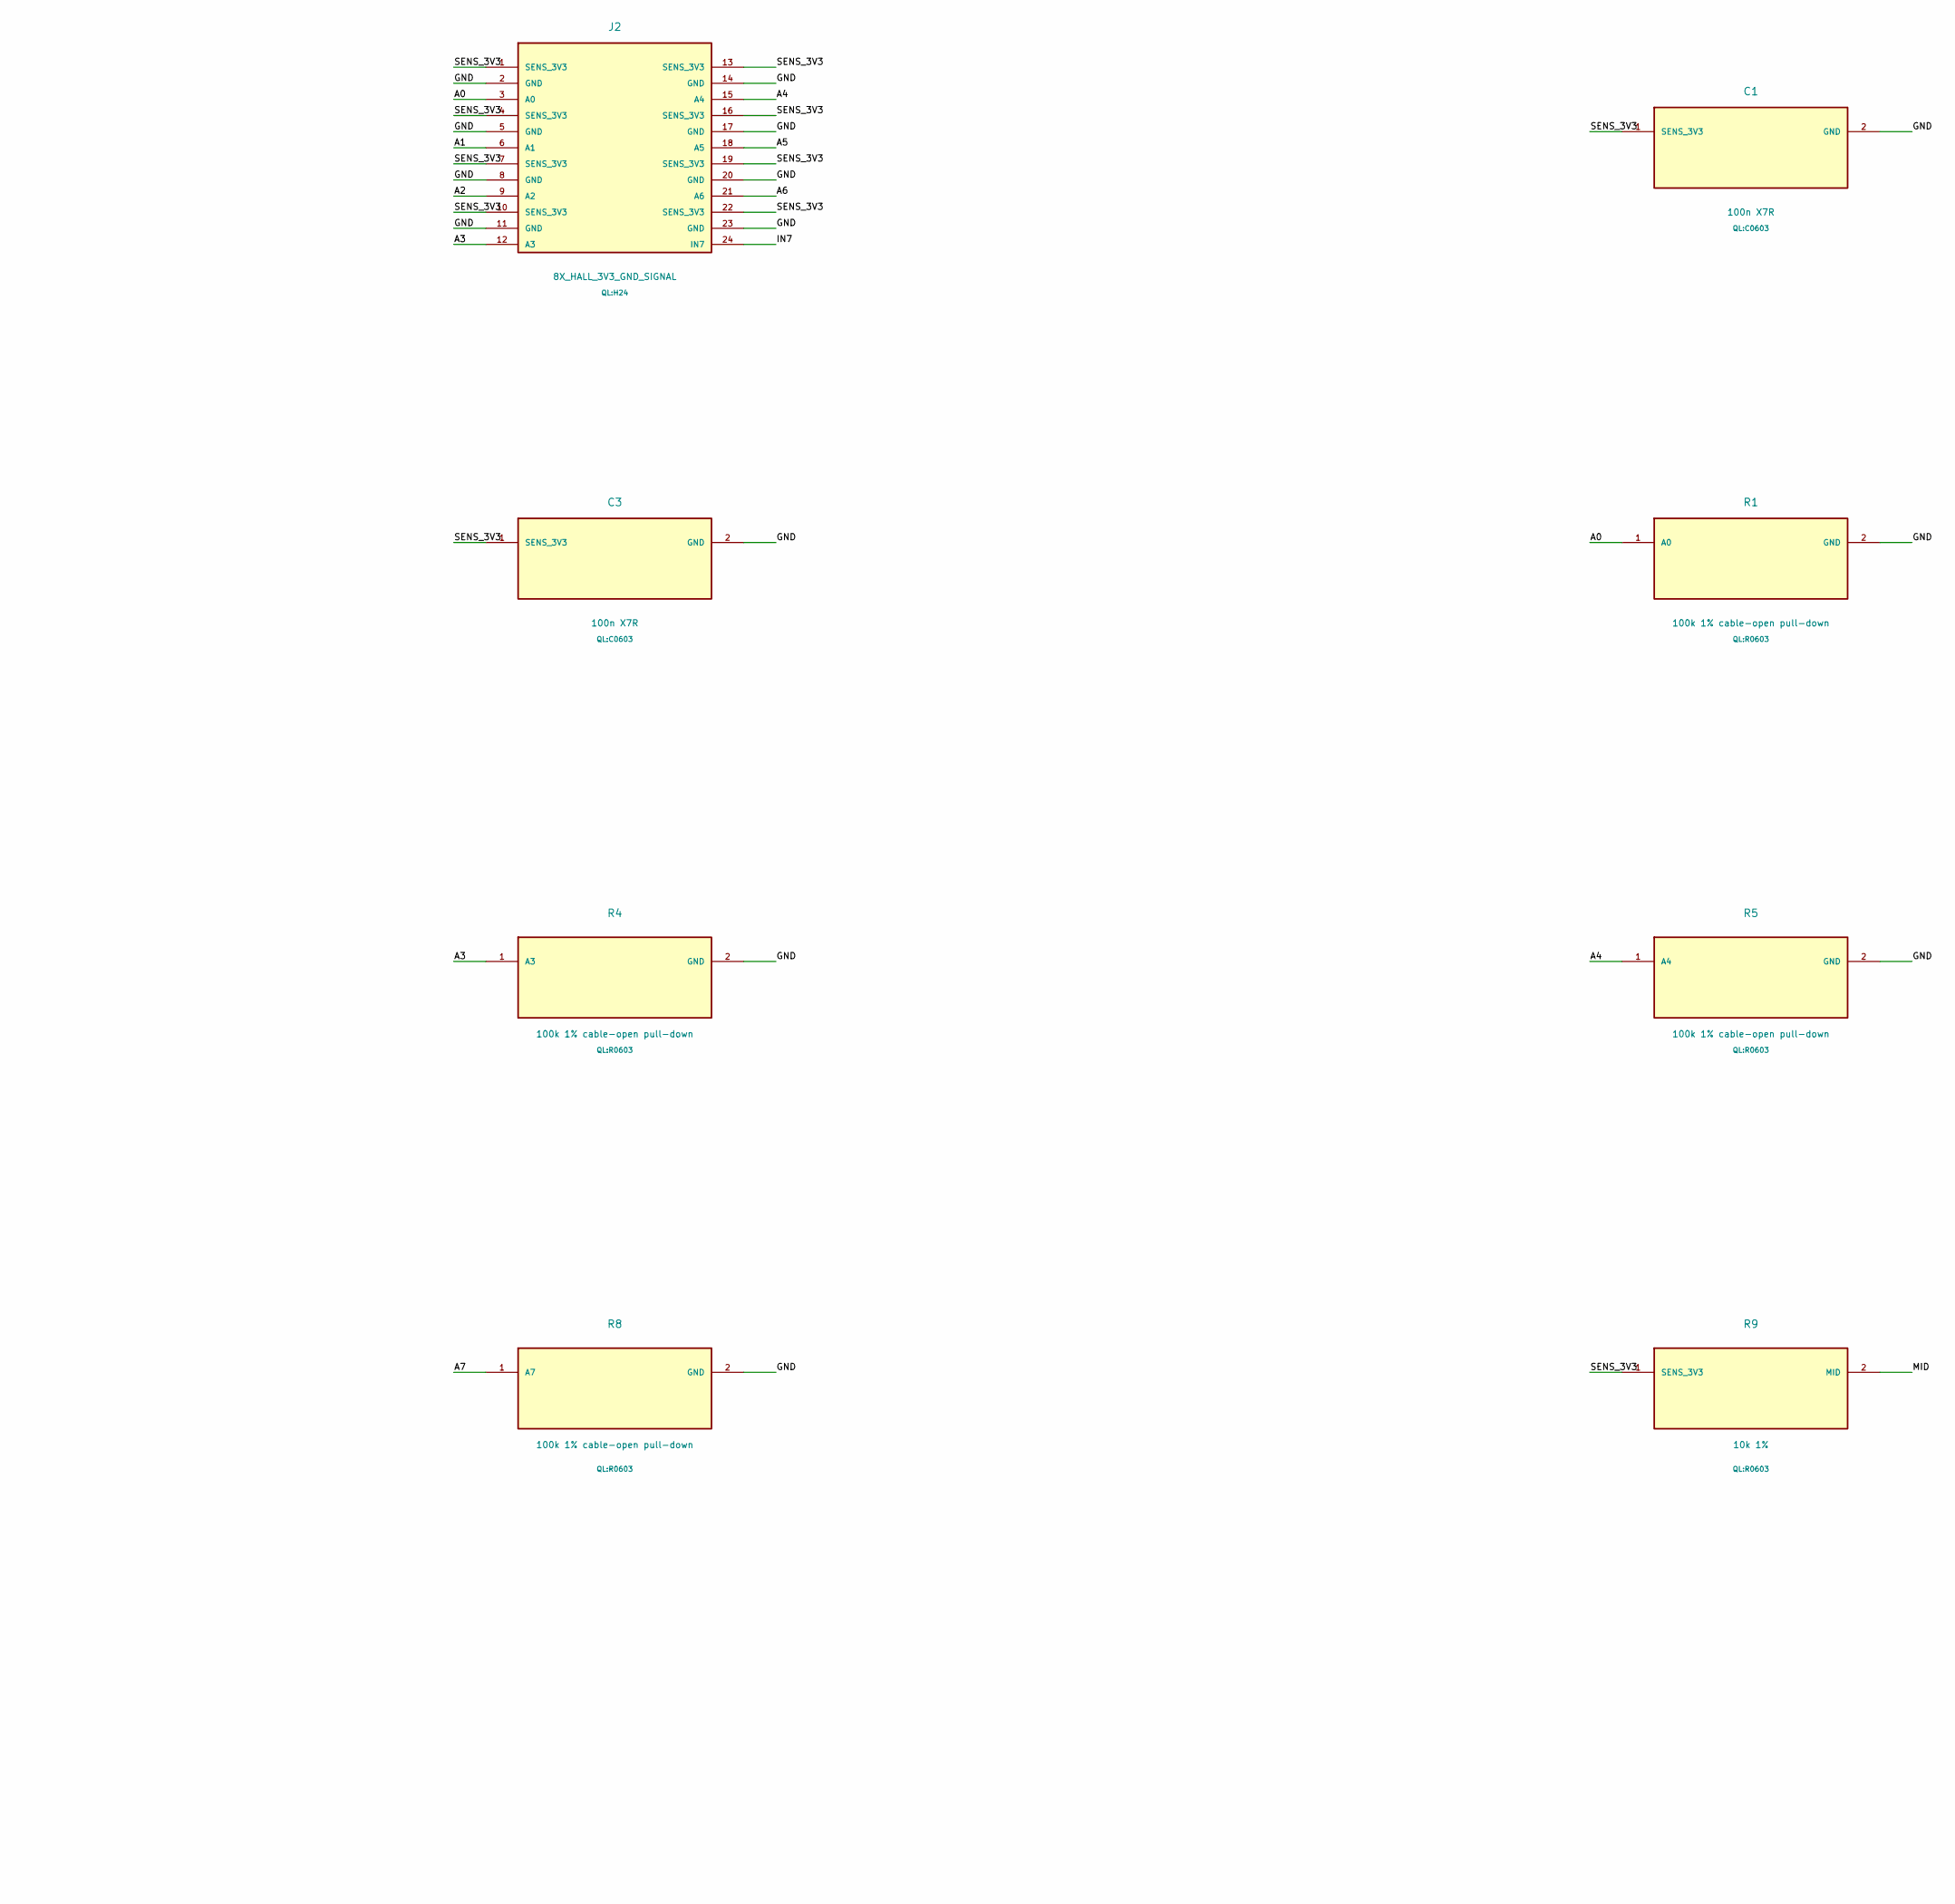
[picture p87: schematic adc.kicad_sch, QULAY QL-01 adc, part in row 1, column 2]

Parts:
C1, C3: 100n X7R; C0603
C2: 10u X7R 6.3V; C0603
J1: SPI_POWER; H6
J2: 8X_HALL_3V3_GND_SIGNAL; H24
JP1: CH7_1-2_SENSOR_2-3_TEST; H3
R1, R2, R3, R4, R5, R6, R7, R8: 100k 1% cable-open pull-down; R0603
R9, R10: 10k 1%; R0603
U1: MCP3208-BI/SL; SOIC16
U2: SN74LVC1G125DBVR_IOFF; SOT23_5

Connections:
A0: J2.3 (A0), R1.1 (A0), U1.1 (A0)
A1: J2.6 (A1), R2.1 (A1), U1.2 (A1)
A2: J2.9 (A2), R3.1 (A2), U1.3 (A2)
A3: J2.12 (A3), R4.1 (A3), U1.4 (A3)
A4: J2.15 (A4), R5.1 (A4), U1.5 (A4)
A5: J2.18 (A5), R6.1 (A5), U1.6 (A5)
A6: J2.21 (A6), R7.1 (A6), U1.7 (A6)
A7: JP1.2 (A7), R8.1 (A7), U1.8 (A7)
ADC_CS: J1.6 (ADC_CS), U1.10 (ADC_CS), U2.1 (ADC_CS)
ADC_MISO: J1.5 (ADC_MISO), U2.4 (ADC_MISO)
ADC_MOSI: J1.4 (ADC_MOSI), U1.11 (ADC_MOSI)
ADC_OUT_RAW: U1.12 (ADC_OUT_RAW), U2.2 (ADC_OUT_RAW)
ADC_SCK: J1.3 (ADC_SCK), U1.13 (ADC_SCK)
GND: C1.2 (GND), C2.2 (GND), C3.2 (GND), J1.2 (GND), J2.2 (GND), J2.5 (GND), J2.8 (GND), J2.11 (GND), J2.14 (GND), J2.17 (GND), J2.20 (GND), J2.23 (GND), R1.2 (GND), R2.2 (GND), R3.2 (GND), R4.2 (GND), R5.2 (GND), R6.2 (GND), R7.2 (GND), R8.2 (GND), R10.2 (GND), U1.9 (GND), U1.14 (GND), U2.3 (GND)
IN7: J2.24 (IN7), JP1.1 (IN7)
MID: JP1.3 (MID), R9.2 (MID), R10.1 (MID)
SENS_3V3: C1.1 (SENS_3V3), C2.1 (SENS_3V3), C3.1 (SENS_3V3), J1.1 (SENS_3V3), J2.1 (SENS_3V3), J2.4 (SENS_3V3), J2.7 (SENS_3V3), J2.10 (SENS_3V3), J2.13 (SENS_3V3), J2.16 (SENS_3V3), J2.19 (SENS_3V3), J2.22 (SENS_3V3), R9.1 (SENS_3V3), U1.15 (SENS_3V3), U1.16 (SENS_3V3), U2.5 (SENS_3V3)

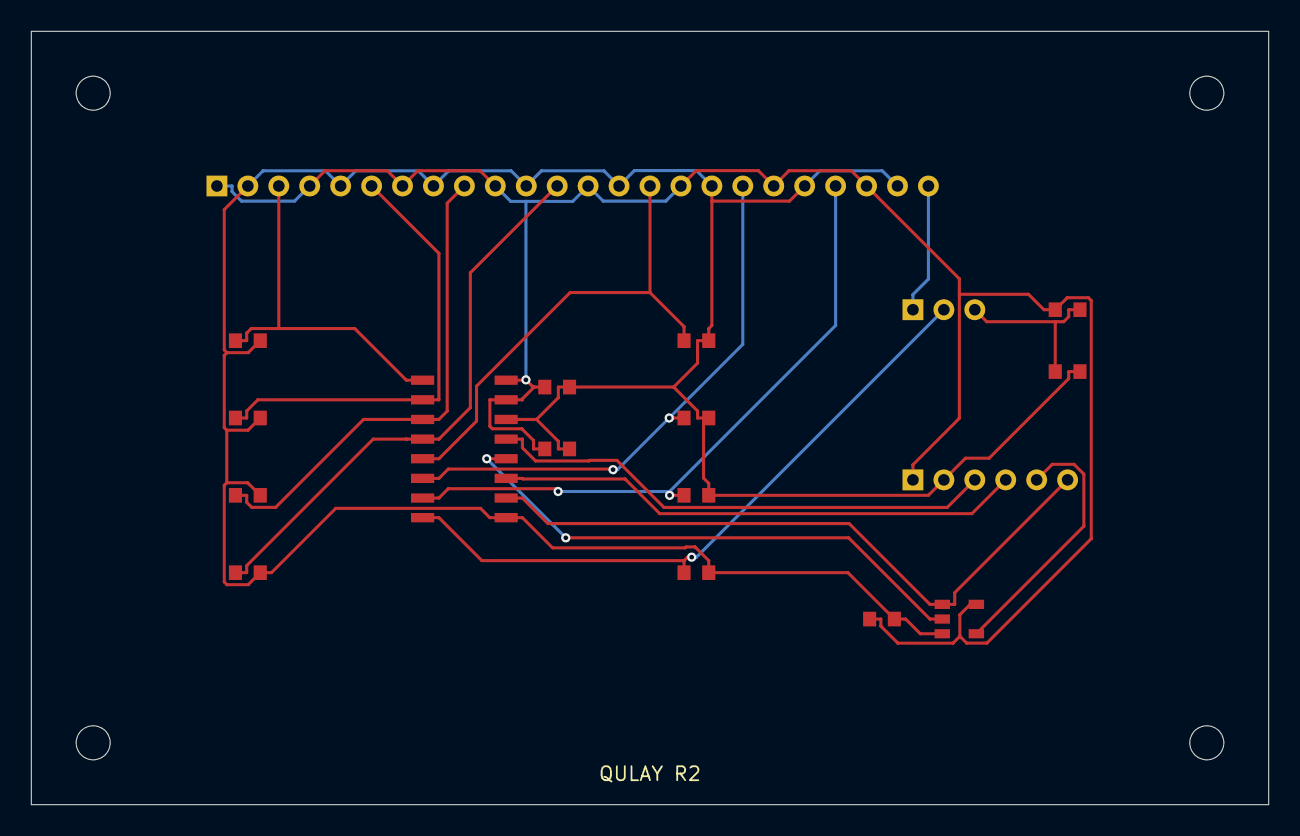
[picture p88: board adc.kicad_pcb from above]

Board: 2 copper layers, 80.0 x 50.0 mm, 22 parts (0 on the bottom side), 17 nets.

Other parts of the board:
MH1, MH2, MH3, MH4: MountingHole_2.2mm
