Eljah/qulay/electronics/generated-r2/power_good/power_good.kicad_pcb

## KiCad design electronics/generated-r2/power_good/power_good.kicad_pcb (2026-10-04)

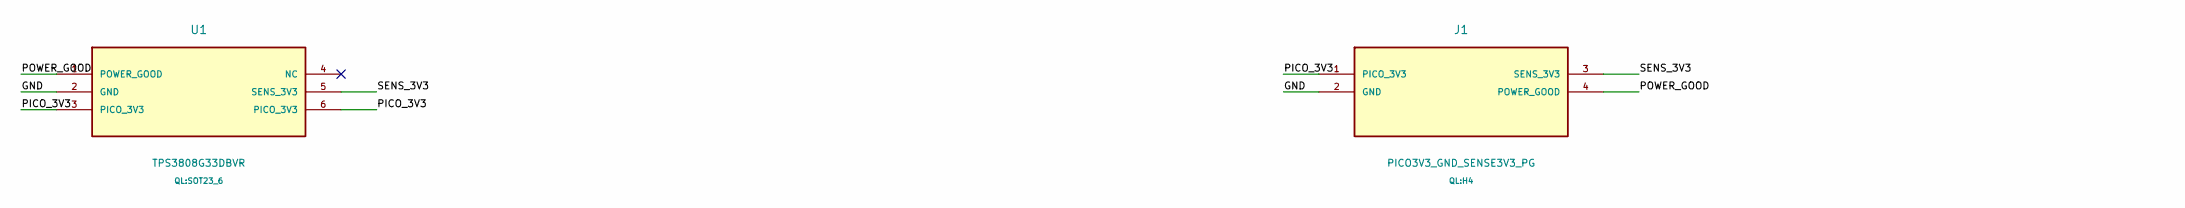
[picture p89: schematic power_good.kicad_sch, QULAY QL-01 power_good, part in row 1, column 1]

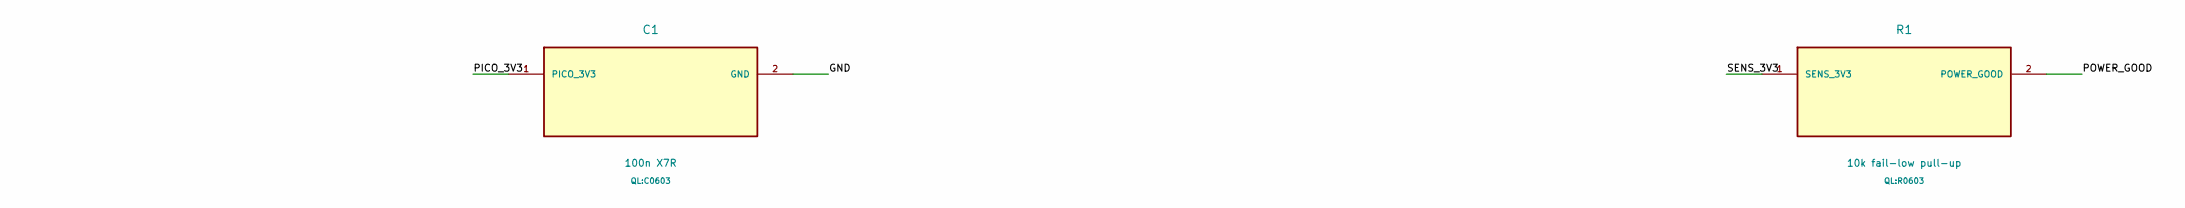
[picture p90: schematic power_good.kicad_sch, QULAY QL-01 power_good, part in row 1, column 2]

Parts:
C1: 100n X7R; C0603
J1: PICO3V3_GND_SENSE3V3_PG; H4
R1: 10k fail-low pull-up; R0603
U1: TPS3808G33DBVR; SOT23_6

Connections:
GND: C1.2 (GND), J1.2 (GND), U1.2 (GND)
PICO_3V3: C1.1 (PICO_3V3), J1.1 (PICO_3V3), U1.3 (PICO_3V3), U1.6 (PICO_3V3)
POWER_GOOD: J1.4 (POWER_GOOD), R1.2 (POWER_GOOD), U1.1 (POWER_GOOD)
SENS_3V3: J1.3 (SENS_3V3), R1.1 (SENS_3V3), U1.5 (SENS_3V3)

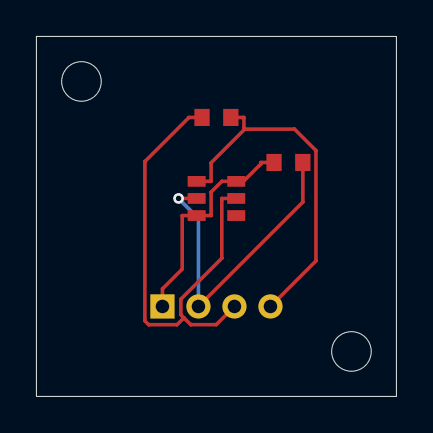
[picture p91: board power_good.kicad_pcb from above]

Board: 2 copper layers, 20.0 x 20.0 mm, 6 parts (0 on the bottom side), 4 nets.

Other parts of the board:
MH1, MH2: MountingHole_2.2mm
