Eljah/qulay/electronics/generated-r2/carrier_r2/carrier_r2.kicad_pcb

## KiCad design electronics/generated-r2/carrier_r2/carrier_r2.kicad_pcb (2026-10-04)

Schematic: carrier_r2.kicad_sch, QULAY QL-01 carrier_r2

Parts:
C1, C2, C3: 100n X7R; C0603
C4: 10u X7R 6.3V; C0603
J1: EXTERNAL_3V3_FUSED_1A; H2
J2: ENCODER_BANK_0; H6
J3: ENCODER_BANK_1; H6
J4: ENCODER_BANK_2; H6
J5: ENCODER_BANK_3; H6
J6: ADXL355_MODULE; H7
J7: ODOMETER_3V3_ONLY; H4
J8: ADC_BANK_FANOUT; H10
J9: INTERLOCK_GND_LIFT_PG_REMOTE_PULLUP; H4
Q1: MMBT3904; SOT23
R1, R2, R3, R4, R5, R6, R7, R8: 10k default-CS-high; R0603
R9, R11: 10k; R0603
R10, R13, R14: 100k; R0603
R12: 100k wire-open-low; R0603
R15, R16, R17, R18: 47R source termination; R0603
U1: Raspberry_Pi_Pico_USB_powered; PICO40
U2, U3: SN74LVC244APWR; TSSOP20
U4: SN74LVC125AD_IOFF; SOIC14

Connections:
ADC_CS0: J8.6 (ADC_CS0), R5.2 (ADC_CS0), U3.18 (ADC_CS0)
ADC_CS1: J8.7 (ADC_CS1), R6.2 (ADC_CS1), U3.16 (ADC_CS1)
ADC_CS2: J8.8 (ADC_CS2), R7.2 (ADC_CS2), U3.14 (ADC_CS2)
ADC_CS3: J8.9 (ADC_CS3), R8.2 (ADC_CS3), U3.12 (ADC_CS3)
ADC_MOSI: J8.4 (ADC_MOSI), R18.2 (ADC_MOSI)
ADC_MOSI_BUF: R18.1 (ADC_MOSI_BUF), U2.3 (ADC_MOSI_BUF)
ADC_SCK: J8.3 (ADC_SCK), R17.2 (ADC_SCK)
ADC_SCK_BUF: R17.1 (ADC_SCK_BUF), U2.5 (ADC_SCK_BUF)
CS0: J2.3 (CS0), R1.2 (CS0), U2.14 (CS0)
CS1: J3.3 (CS1), R2.2 (CS1), U2.12 (CS1)
CS2: J4.3 (CS2), R3.2 (CS2), U2.9 (CS2)
CS3: J5.3 (CS3), R4.2 (CS3), U2.7 (CS3)
CS_ADXL: J6.6 (CS_ADXL), U1.17 (CS_ADXL)
DRDY_ADXL: J6.7 (DRDY_ADXL), U1.19 (DRDY_ADXL)
GND: C1.2 (GND), C2.2 (GND), C3.2 (GND), C4.2 (GND), J1.2 (GND), J2.2 (GND), J3.2 (GND), J4.2 (GND), J5.2 (GND), J6.2 (GND), J7.2 (GND), J8.2 (GND), J8.10 (GND), J9.1 (GND), Q1.2 (GND), R10.2 (GND), R12.2 (GND), R13.2 (GND), R14.2 (GND), U1.3 (GND), U1.8 (GND), U1.13 (GND), U1.18 (GND), U1.23 (GND), U1.28 (GND), U1.33 (GND), U1.38 (GND), U2.10 (GND), U3.10 (GND), U3.11 (GND), U3.13 (GND), U3.15 (GND), U3.17 (GND), U4.1 (GND), U4.4 (GND), U4.7 (GND), U4.9 (GND), U4.12 (GND)
LIFT_STOWED_N: J9.2 (LIFT_STOWED_N), U1.26 (LIFT_STOWED_N)
MISO0: U1.6 (MISO0), U4.3 (MISO0)
MISO0_RAW: J2.6 (MISO0_RAW), J3.6 (MISO0_RAW), J4.6 (MISO0_RAW), J5.6 (MISO0_RAW), R13.1 (MISO0_RAW), U4.2 (MISO0_RAW)
MISO1: U1.16 (MISO1), U4.6 (MISO1)
MISO1_RAW: J6.5 (MISO1_RAW), J8.5 (MISO1_RAW), R14.1 (MISO1_RAW), U4.5 (MISO1_RAW)
MOSI0: J2.5 (MOSI0), J3.5 (MOSI0), J4.5 (MOSI0), J5.5 (MOSI0), R16.2 (MOSI0)
MOSI0_BUF: R16.1 (MOSI0_BUF), U2.16 (MOSI0_BUF)
ODO_A: J7.3 (ODO_A), U1.1 (ODO_A)
ODO_B: J7.4 (ODO_B), U1.2 (ODO_B)
OE_SENS_N: Q1.3 (OE_SENS_N), R11.2 (OE_SENS_N), U2.1 (OE_SENS_N), U2.19 (OE_SENS_N), U3.1 (OE_SENS_N), U3.19 (OE_SENS_N)
PICO_3V3: C3.1 (PICO_3V3), J6.1 (PICO_3V3), J7.1 (PICO_3V3), J9.4 (PICO_3V3), U1.36 (PICO_3V3), U4.10 (PICO_3V3), U4.13 (PICO_3V3), U4.14 (PICO_3V3)
POWER_GOOD: J9.3 (POWER_GOOD), R12.1 (POWER_GOOD), U1.27 (POWER_GOOD)
P_ADC_CS0: U1.21 (P_ADC_CS0), U3.2 (P_ADC_CS0)
P_ADC_CS1: U1.22 (P_ADC_CS1), U3.4 (P_ADC_CS1)
P_ADC_CS2: U1.24 (P_ADC_CS2), U3.6 (P_ADC_CS2)
P_ADC_CS3: U1.25 (P_ADC_CS3), U3.8 (P_ADC_CS3)
P_CS0: U1.7 (P_CS0), U2.6 (P_CS0)
P_CS1: U1.9 (P_CS1), U2.8 (P_CS1)
P_CS2: U1.10 (P_CS2), U2.11 (P_CS2)
P_CS3: U1.11 (P_CS3), U2.13 (P_CS3)
P_MOSI0: U1.5 (P_MOSI0), U2.4 (P_MOSI0)
P_MOSI1: J6.4 (P_MOSI1), U1.15 (P_MOSI1), U2.17 (P_MOSI1)
P_SCK0: U1.4 (P_SCK0), U2.2 (P_SCK0)
P_SCK1: J6.3 (P_SCK1), U1.14 (P_SCK1), U2.15 (P_SCK1)
Q_BASE: Q1.1 (Q_BASE), R9.2 (Q_BASE), R10.1 (Q_BASE)
SCK0: J2.4 (SCK0), J3.4 (SCK0), J4.4 (SCK0), J5.4 (SCK0), R15.2 (SCK0)
SCK0_BUF: R15.1 (SCK0_BUF), U2.18 (SCK0_BUF)
SENSOR_ENABLE: R9.1 (SENSOR_ENABLE), U1.29 (SENSOR_ENABLE)
SENS_3V3: C1.1 (SENS_3V3), C2.1 (SENS_3V3), C4.1 (SENS_3V3), J1.1 (SENS_3V3), J2.1 (SENS_3V3), J3.1 (SENS_3V3), J4.1 (SENS_3V3), J5.1 (SENS_3V3), J8.1 (SENS_3V3), R1.1 (SENS_3V3), R2.1 (SENS_3V3), R3.1 (SENS_3V3), R4.1 (SENS_3V3), R5.1 (SENS_3V3), R6.1 (SENS_3V3), R7.1 (SENS_3V3), R8.1 (SENS_3V3), R11.1 (SENS_3V3), U2.20 (SENS_3V3), U3.20 (SENS_3V3)

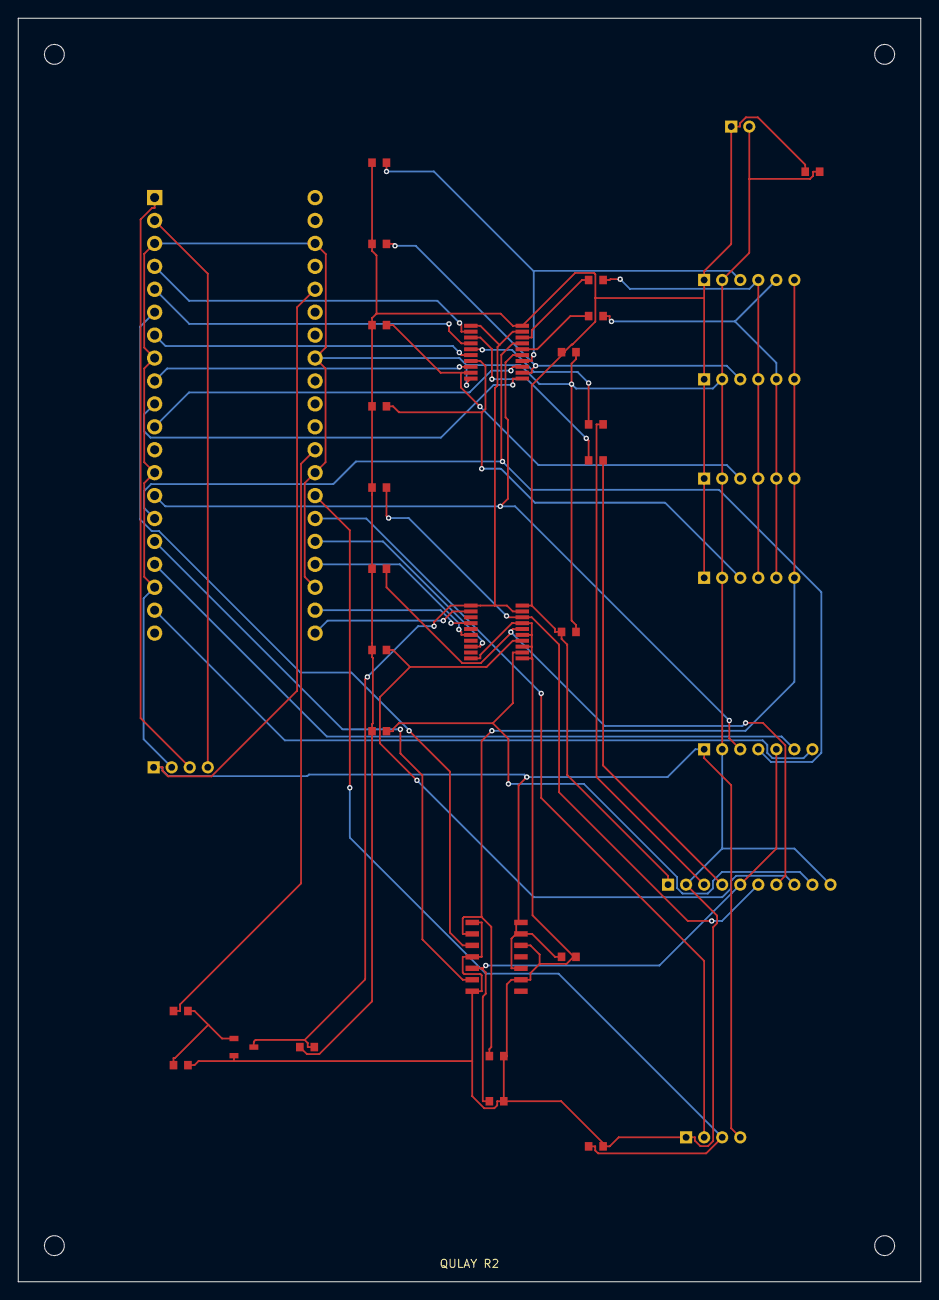
[picture p92: board carrier_r2.kicad_pcb from above]

Board: 2 copper layers, 100.0 x 140.0 mm, 40 parts (0 on the bottom side), 44 nets.

Other parts of the board:
MH1, MH2, MH3, MH4: MountingHole_2.2mm
