Eljah/qulay/electronics/generated/encoder/encoder.kicad_pcb

## KiCad design electronics/generated/encoder/encoder.kicad_pcb (2026-10-02)

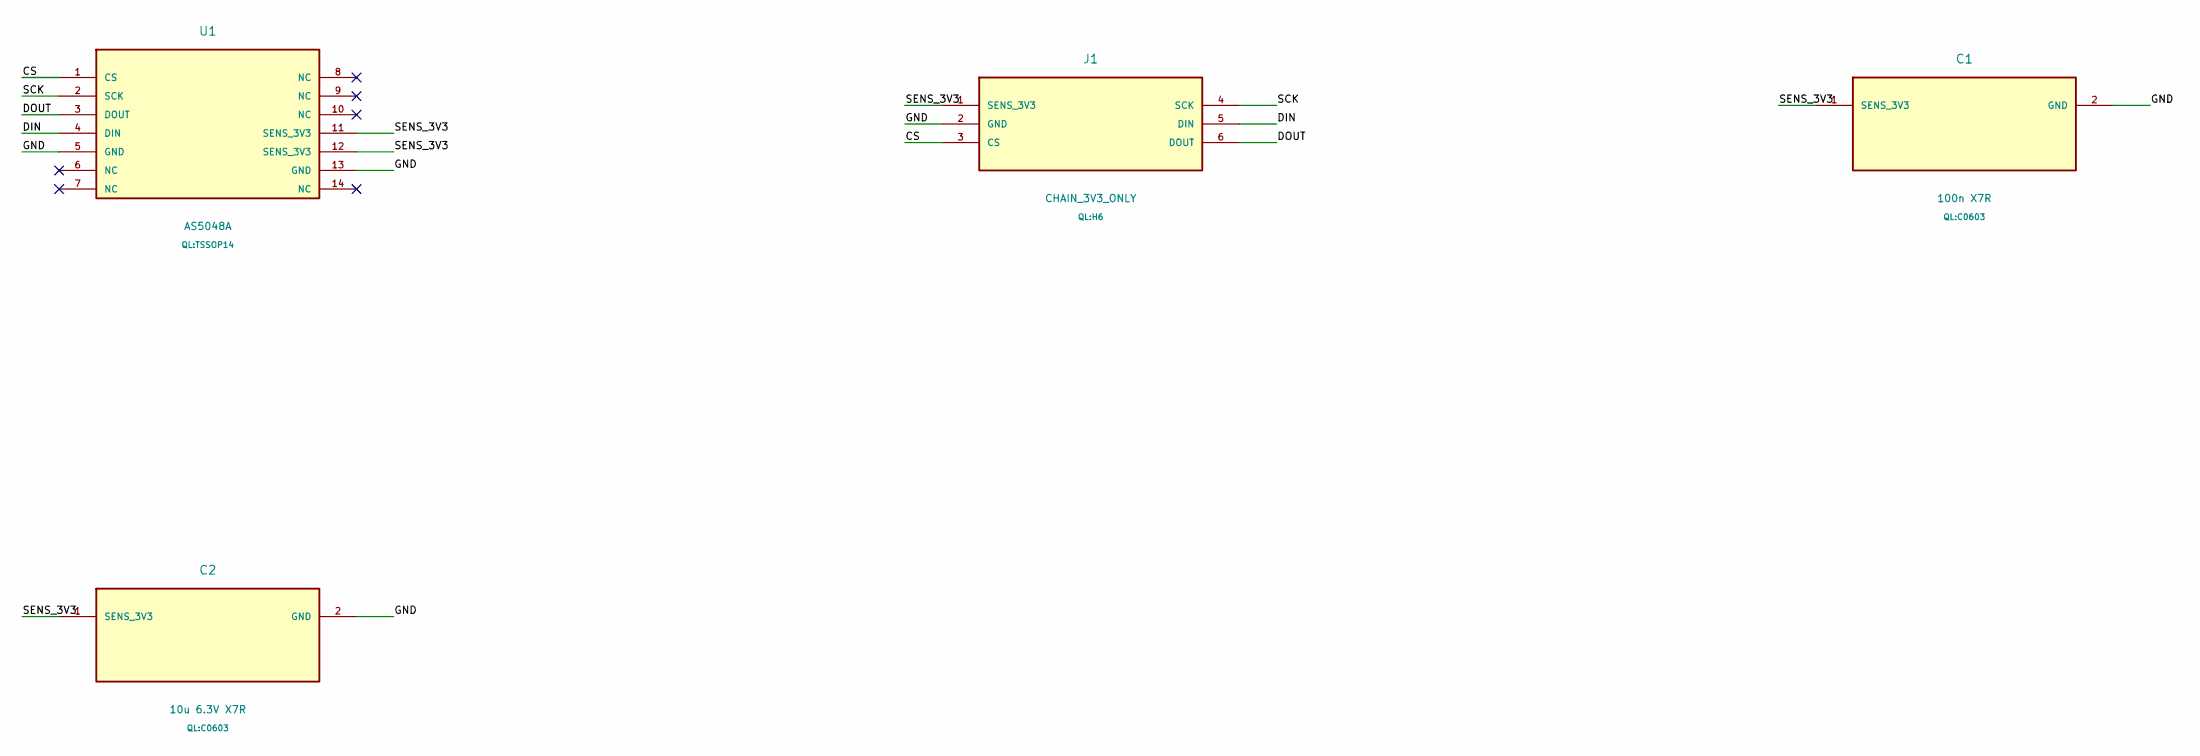
[picture p93: schematic encoder.kicad_sch, QULAY QL-01 encoder]

Parts:
C1: 100n X7R; C0603
C2: 10u 6.3V X7R; C0603
J1: CHAIN_3V3_ONLY; H6
U1: AS5048A; TSSOP14

Connections:
CS: J1.3 (CS), U1.1 (CS)
DIN: J1.5 (DIN), U1.4 (DIN)
DOUT: J1.6 (DOUT), U1.3 (DOUT)
GND: C1.2 (GND), C2.2 (GND), J1.2 (GND), U1.5 (GND), U1.13 (GND)
SCK: J1.4 (SCK), U1.2 (SCK)
SENS_3V3: C1.1 (SENS_3V3), C2.1 (SENS_3V3), J1.1 (SENS_3V3), U1.11 (SENS_3V3), U1.12 (SENS_3V3)

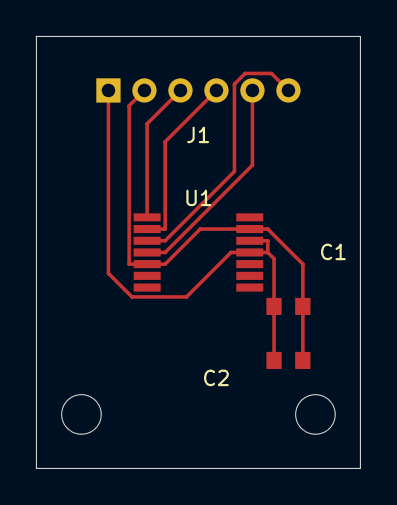
[picture p94: board encoder.kicad_pcb from above]

Board: 2 copper layers, 18.0 x 24.0 mm, 6 parts (0 on the bottom side), 6 nets.

Other parts of the board:
MH1, MH2: MountingHole_2.2mm
