Eljah/qulay/electronics/generated/carrier/carrier.kicad_pcb

## KiCad design electronics/generated/carrier/carrier.kicad_pcb (2026-10-02)

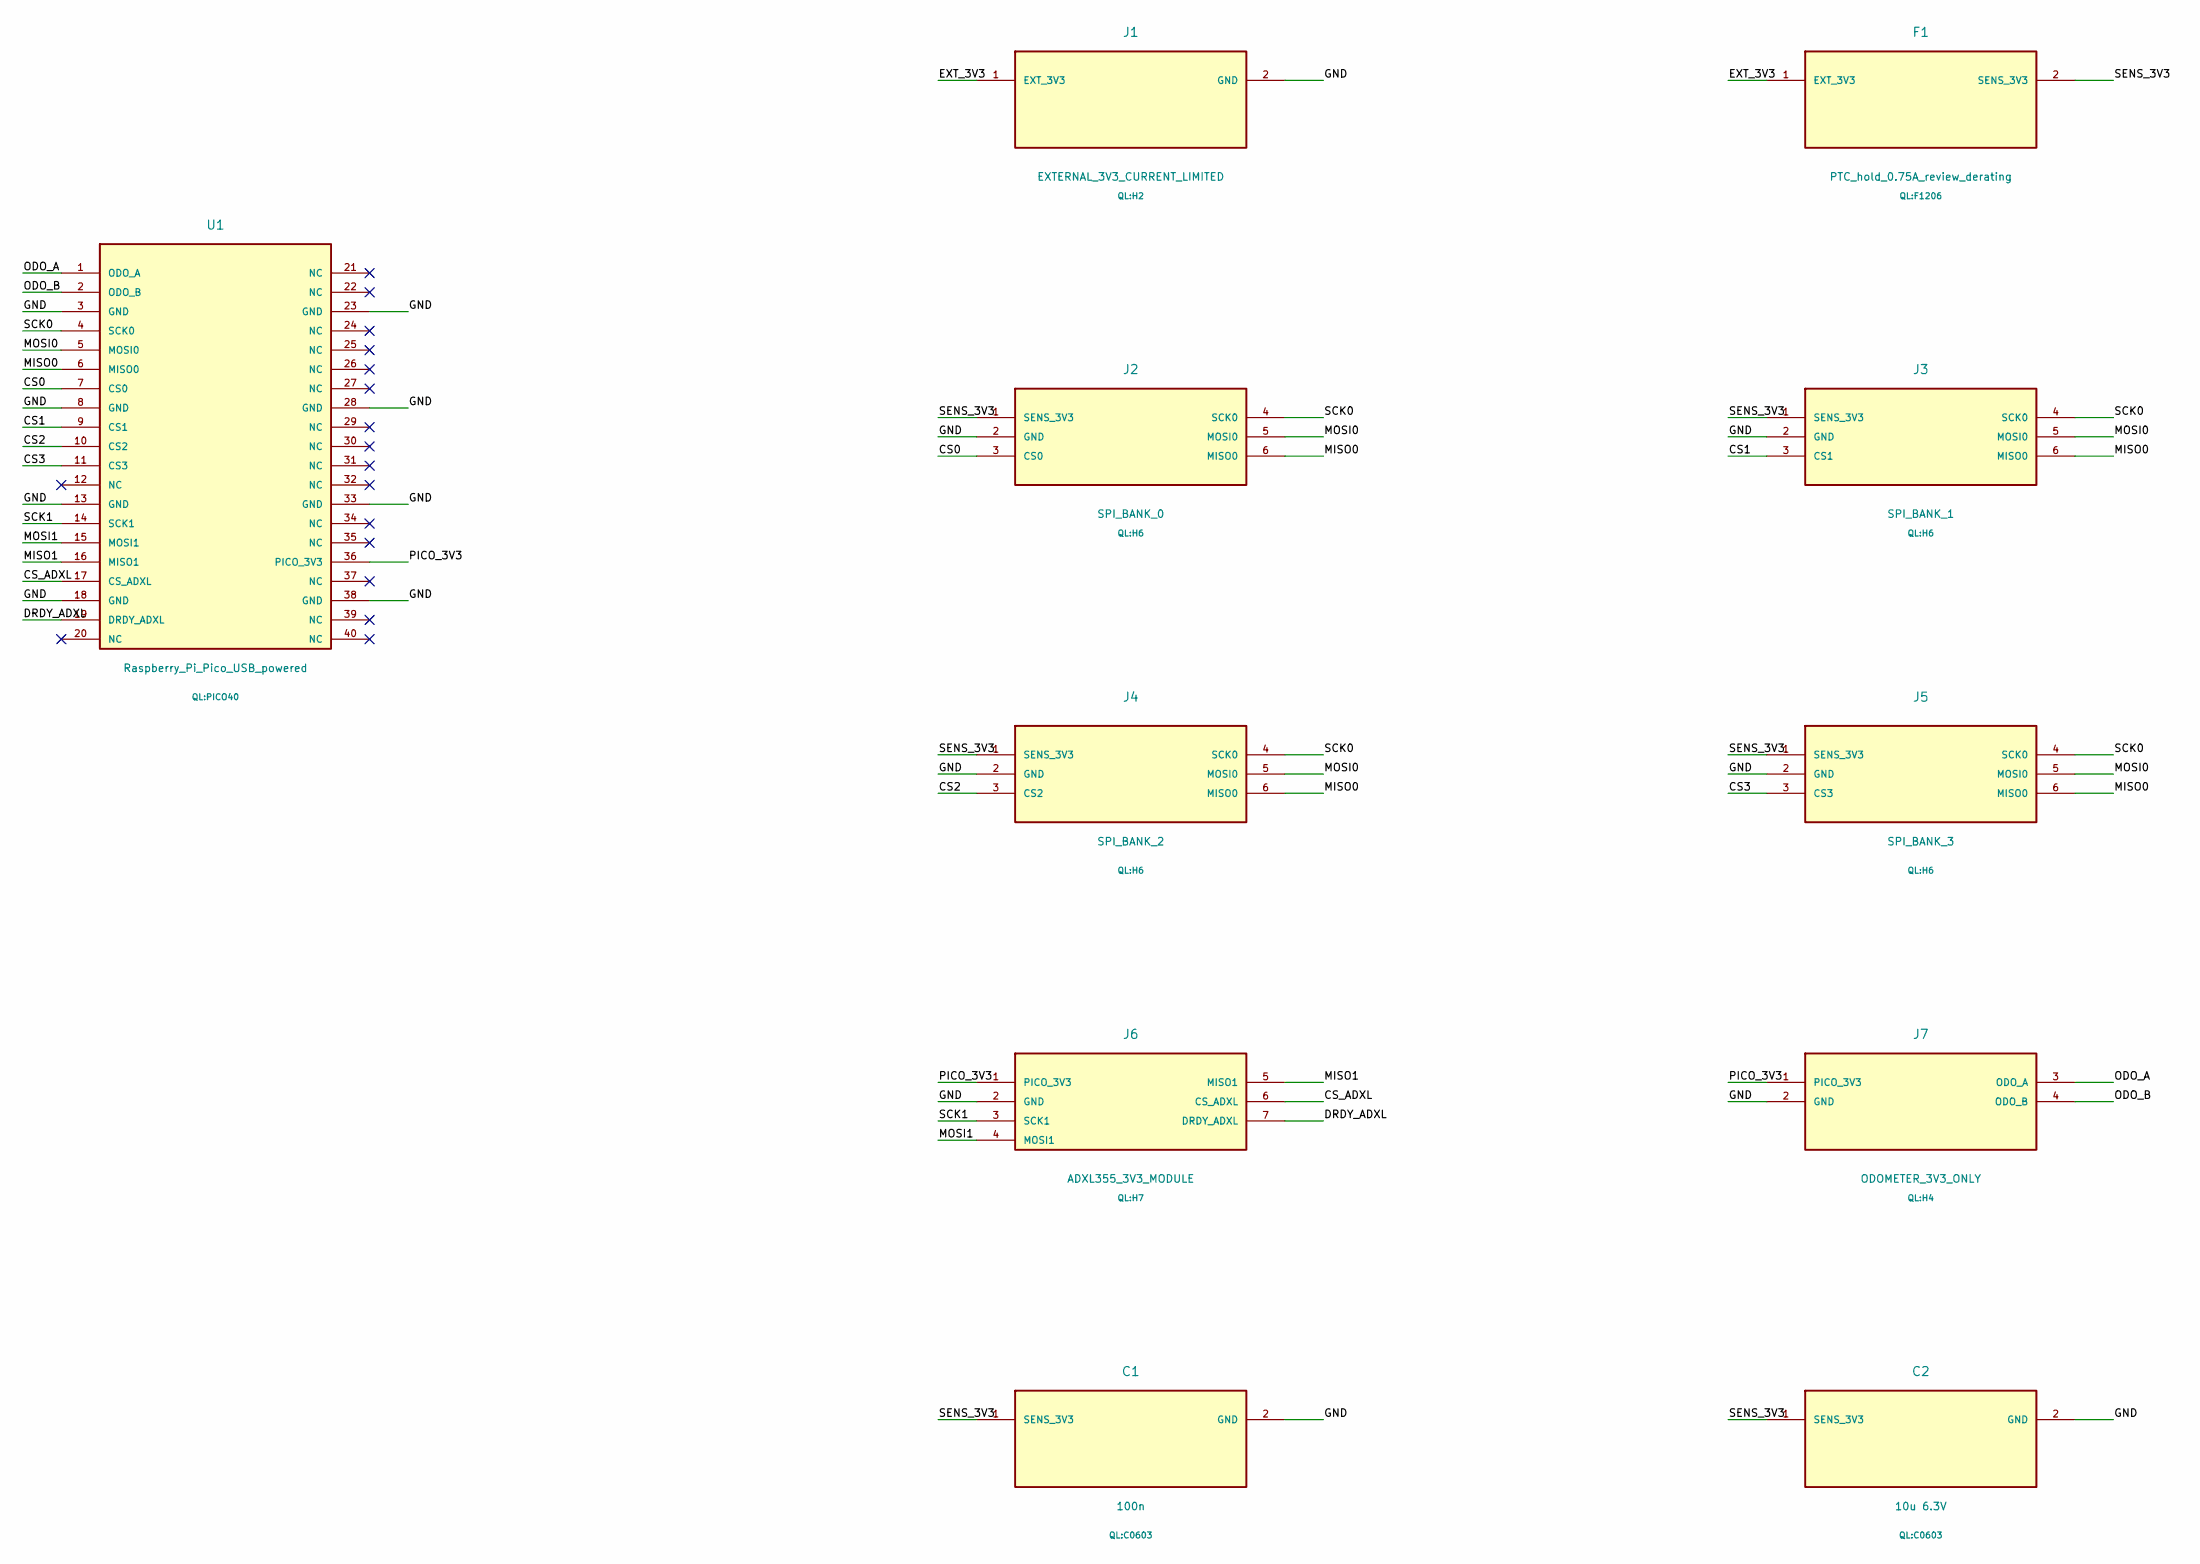
[picture p95: schematic carrier.kicad_sch, QULAY QL-01 carrier]

Parts:
C1: 100n; C0603
C2: 10u 6.3V; C0603
F1: PTC_hold_0.75A_review_derating; F1206
J1: EXTERNAL_3V3_CURRENT_LIMITED; H2
J2: SPI_BANK_0; H6
J3: SPI_BANK_1; H6
J4: SPI_BANK_2; H6
J5: SPI_BANK_3; H6
J6: ADXL355_3V3_MODULE; H7
J7: ODOMETER_3V3_ONLY; H4
U1: Raspberry_Pi_Pico_USB_powered; PICO40

Connections:
CS0: J2.3 (CS0), U1.7 (CS0)
CS1: J3.3 (CS1), U1.9 (CS1)
CS2: J4.3 (CS2), U1.10 (CS2)
CS3: J5.3 (CS3), U1.11 (CS3)
CS_ADXL: J6.6 (CS_ADXL), U1.17 (CS_ADXL)
DRDY_ADXL: J6.7 (DRDY_ADXL), U1.19 (DRDY_ADXL)
EXT_3V3: F1.1 (EXT_3V3), J1.1 (EXT_3V3)
GND: C1.2 (GND), C2.2 (GND), J1.2 (GND), J2.2 (GND), J3.2 (GND), J4.2 (GND), J5.2 (GND), J6.2 (GND), J7.2 (GND), U1.3 (GND), U1.8 (GND), U1.13 (GND), U1.18 (GND), U1.23 (GND), U1.28 (GND), U1.33 (GND), U1.38 (GND)
MISO0: J2.6 (MISO0), J3.6 (MISO0), J4.6 (MISO0), J5.6 (MISO0), U1.6 (MISO0)
MISO1: J6.5 (MISO1), U1.16 (MISO1)
MOSI0: J2.5 (MOSI0), J3.5 (MOSI0), J4.5 (MOSI0), J5.5 (MOSI0), U1.5 (MOSI0)
MOSI1: J6.4 (MOSI1), U1.15 (MOSI1)
ODO_A: J7.3 (ODO_A), U1.1 (ODO_A)
ODO_B: J7.4 (ODO_B), U1.2 (ODO_B)
PICO_3V3: J6.1 (PICO_3V3), J7.1 (PICO_3V3), U1.36 (PICO_3V3)
SCK0: J2.4 (SCK0), J3.4 (SCK0), J4.4 (SCK0), J5.4 (SCK0), U1.4 (SCK0)
SCK1: J6.3 (SCK1), U1.14 (SCK1)
SENS_3V3: C1.1 (SENS_3V3), C2.1 (SENS_3V3), F1.2 (SENS_3V3), J2.1 (SENS_3V3), J3.1 (SENS_3V3), J4.1 (SENS_3V3), J5.1 (SENS_3V3)

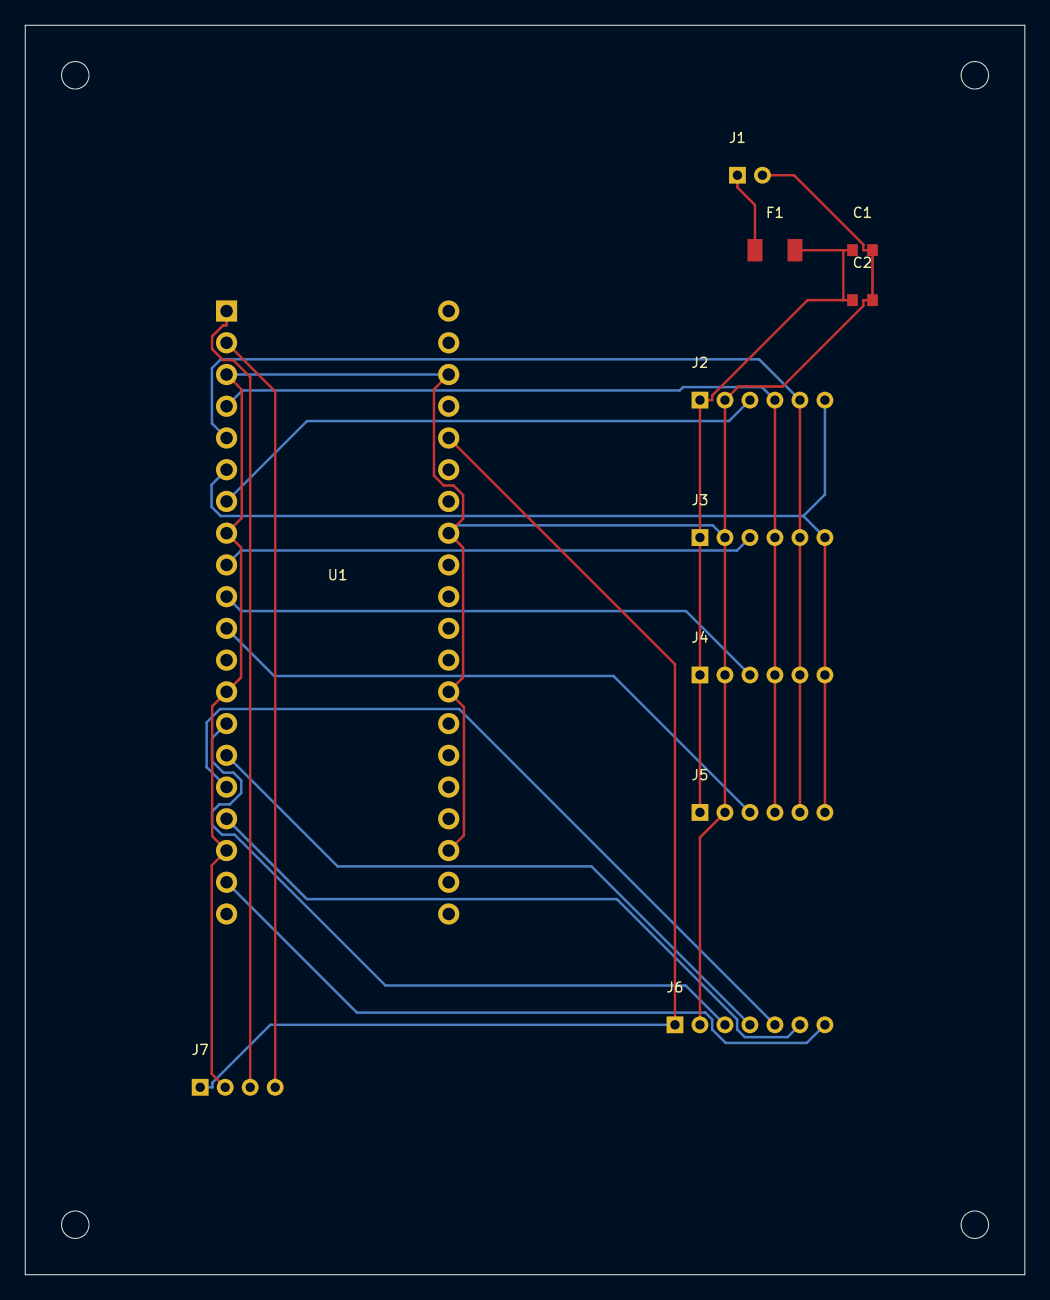
[picture p96: board carrier.kicad_pcb from above]

Board: 2 copper layers, 80.0 x 100.0 mm, 15 parts (0 on the bottom side), 18 nets.

Other parts of the board:
MH1, MH2, MH3, MH4: MountingHole_2.2mm
