Eljah/qulay/(commit log)

2026-10-02 docs: establish Qulay measurement concept and honest prototype boundaries
2026-10-02 feat(firmware): add RP2040 acquisition and protocol checks; fix Maven shade inheritance
    [main.c, protocol.h]
2026-10-02 feat(cad): add three real parametric assemblies, drawings and branch-only publication
2026-10-02 build(cad): publish STEP, DXF, CAD views, A3 album and registers [skip ci]
    [arm-240mm-3mm.dxf, arm-240mm-3mm.step, cut-list-along-curb.csv, cut-list-crossing.csv, cut-list-datum-rail.csv, parts-along-curb.csv, parts-crossing.csv, parts-datum-rail.csv]
2026-10-02 feat(electronics): generate connected KiCad encoder and Pico carrier projects
2026-10-02 feat(electronics): add autorouting import and unsuppressed KiCad checks
2026-10-02 ci(electronics): build, route, check and publish editable KiCad projects
2026-10-02 fix(electronics): use KiCad 9 and assert serialized pad coordinates before routing
2026-10-02 feat(metrology): add curb plateau analysis and explicit calibration/assembly procedure
2026-10-02 fix(eda): select native KiCad footprint writer explicitly and verify serialized pads
2026-10-02 fix(eda): convert SWIG UTF8 footprint identifiers before layout validation
2026-10-02 feat(cad): correct adjacent pivot interference; add true sections and checked revision B
2026-10-02 build(electronics): publish KiCad, routed boards, schematics and checks [skip ci]
    [BOM.csv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]
2026-10-02 ci(cad): build revision B, check neighboring parts, publish STEP and section album
2026-10-02 build(cad): publish revision B and explicit collision evidence [skip ci]
    [parts-along-curb.csv, parts-crossing.csv, parts-datum-rail.csv, pivot-bracket-5mm.dxf, qulay-r1-along-curb.step, qulay-r1-crossing.step, qulay-r1-datum-rail.step]
2026-10-02 feat(eda): normalize schematic grid, supply native symbol library and check netlist parity
2026-10-02 fix(eda): require ERC and netlist parity, correct SVG export and silkscreen
2026-10-02 test(agent): exercise timeout, truncated frames and the full replay-to-USB capture path
2026-10-02 ci(eda): preserve diagnostics and publish checked boards without concurrent rebase conflicts
2026-10-02 build: publish checked electronics/generated [skip ci]
    [carrier-B_Courtyard.gbr, carrier-B_Cu.gbl, carrier-B_Fab.gbr, carrier-B_Mask.gbs, carrier-B_Paste.gbp, carrier-B_Silkscreen.gbo, carrier-Edge_Cuts.gm1, carrier-F_Courtyard.gbr]
2026-10-02 docs: document recovered baseline, measured CAD interference fixes and field blockers
2026-10-03 docs(ci): build CAD-derived manual with pinned engineering inputs and preserve PDF
2026-10-03 docs(cad): generate manual views and exploded joint from unchanged R1 solids
2026-10-03 docs: add mechanical assembly, wiring, channel map and commissioning manual
2026-10-03 docs: render 37-page mechanical manual from CAD, DXF, PCB and wiring records
2026-10-03 docs: describe mechanical manual, print formats and engineering source revision [skip ci]
2026-10-03 docs(channel): explain one roller measurement chain against R1 CAD and AS5048A datasheet
2026-10-03 docs(channel): build illustrated single-channel sensor PDF and numerical verification
2026-10-03 ci(docs): build and publish separate single-roller tilt sensor explanation
2026-10-03 docs: publish single roller AS5048A explanation and CAD figures [skip ci]
2026-10-03 docs(channel): add qualified sensor electrical and magnetic parameters [skip ci]
2026-10-03 docs(channel): refine diagram spacing, enlarge KiCad fragments and include sensor parameter sheet
2026-10-03 docs(channel): document scope, sources and reproduction of the separate sensor note [skip ci]
2026-10-04 feat(r2): define calibrated tip-displacement and contact decision model
2026-10-04 feat(r2): retain contact ADC, encoder diagnostics and channel read times in Q2
2026-10-04 test(r2): cover contact calibration, uncertainty, disconnects and tip geometry
2026-10-04 build(r2): integrate tested Q2 runtime and preserve verification [skip ci]
    [Agent.java, ContactModel.java, WireV2Test.java]
2026-10-04 feat(eda): add per-roller Hall displacement, four ADC banks and power-safe carrier R2
2026-10-04 test(eda): require real routing, ERC, DRC and netlist parity for all R2 boards
2026-10-04 ci(r2): build and route Hall, ADC and power-safe Pico carrier projects
2026-10-04 feat(firmware): acquire Q2 angles, contact ADC and interlocks with separate read times
2026-10-04 fix(r2): align routing to 0.20 mm rules and reserve clock/data escape
2026-10-04 ci(r2): verify final routing at unchanged 0.20 mm clearance
2026-10-04 build(r2): publish final routed electronics and checks [skip ci]
    [BOM.csv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]
2026-10-04 feat(r2): complete fail-low power supervisor and correct Hall ordering code
2026-10-04 ci(r2): route and validate the added power supervisor board
2026-10-04 test(r2): verify all four boards including supply monitor
2026-10-04 build(r2): publish four routed boards and checks [skip ci]
    [adc-B_Courtyard.gbr, adc-B_Cu.gbl, adc-B_Fab.gbr, adc-B_Mask.gbs, adc-B_Paste.gbp, adc-B_Silkscreen.gbo, adc-Edge_Cuts.gm1, adc-F_Courtyard.gbr]
2026-10-04 ci(r2): retain verified ADC routing and independently recheck four boards
2026-10-04 build(r2): publish verified four-board electronics baseline [skip ci]
    [adc-B_Courtyard.gbr, adc-B_Cu.gbl, adc-B_Fab.gbr, adc-B_Mask.gbs, adc-B_Paste.gbp, adc-B_Silkscreen.gbo, adc-Edge_Cuts.gm1, adc-F_Courtyard.gbr]
2026-10-04 feat(mechanics): add C1 integral flange and positive dowel arm coupling with CAD checks
2026-10-04 docs(mechanics): specify C1 fits, matched machining, assembly and proof test
2026-10-04 docs(mechanics): add C1 dimensioned assembly shaft and lever drawing generator
2026-10-04 build(c1): publish positive coupling CAD, drawings and verification [skip ci]
    [BOM.csv, C1-ARM.step, C1-PIN-1.step, C1-PIN-2.step, C1-SCREW-1.step, C1-SCREW-2.step, C1-SHAFT.step, C1-arm-finished-face.dxf]
2026-10-04 docs(c1): publish navigation to coupling CAD and clarify superseded R1 status [skip ci]
2026-10-05 docs(sensors): add installation pinouts, harness maps, channel setup and tested code guide
2026-10-05 docs(sensors): publish checked pinout, wiring and channel manual [skip ci]
    [channel-map.csv, commissioning-31-channels.csv, encoder-harness.csv]
